eloy-cacca/Trabajo-final/trabajo final/tesis aon/tesis/hardware/tesis.PcbDoc.htm

Reporting Options

# File in Newer Format

Date | : | 30/9/2021
Time | : | 12:57:49
Filename | : | C:\Users\eloy_\Desktop\trabajo final\tesis aon\tesis\hardware\tesis.PcbDoc

Version | Warning
Release 20.0 | CAUTION - Support of propagation delay for primitives

This file was generated by a later version of the software
