eloy-cacca/Trabajo-final/trabajo final/filtro antialiasing/Analisis filtro.docx

Como se pretende adquirir señales de tensión y corriente provenientes de la línea, a estas se las debe filtrar y adecuar en tensión para su ingreso en el ADC del micro ARM. Para ello se eligió un filtro Butterworth de 3er orden.


Circuito para censado de corriente

En el circuito se optó por utilizar el amplificador operacional TLV 2474 dado que presenta una característica de amplitud lineal(dB) y no agrega fase en el intervalo de interés, esta última característica surge de que necesitamos conocer la diferencia de fase entre tensión y corriente para evaluar cuál es el comportamiento de la línea( resistivo, inductivo, capacitivo, etc.).


Circuito de salida


Bode circuito de salida

Se plantea el análisis por etapas, llegando a las ecuaciones:

H^(-) =(R_4)/(R_4 +R_5)=10.000/(10.000+10.000)=0.5

H^(+) = ((R_1 *R_2)/(R_1 +R_2)*C_1 *S)/(1+(R_1 *R_2)/(R_1 +R_2)*C_1 *S)*1/(1+R_3 *C_2 *S)=(S/21482)/(1+S/21482)*1/(1+S/21276)

G^(+) =(R_2)/(R_2 +R_1)*1/(1+(R_2 *R_1 *C_1 *S)/(R_2 +R_1))*1/(1+R_3 *C_2 *S)=0.5*1/(1+S/21482)*1/(1+S/21276)

Consideraciones de diseño:

C_1 =C_2 ; R_2 =R_1 ; R_4 =R_5 ; R_3 ~(R_4)/2


Del lado izquierdo tenemos a H^(-) y del lado derecho la red H^(+)


Circuito G+


Se trazó el diagrama de bode y se analizo la amplitud de cada una para analizar su aporte, llegando a que solo debemos considerar a H^(-) para nuestra región de incumbencia.


En verde traza de H^(+) y en celeste H^(-)

A su vez como trabajamos en la zona de G*H >> 1 entonces la ganancia se la puede considerar como A_(v1) =(G+)/(H-)=((R_2)/(R_2 +R_1)*1/(1+(R_2 *R_1 *C_1 *S)/(R_2 +R_1))*1/(1+R_3 *C_2 *S))/((R_4)/(R_4 +R_5))=(0.5*1/(1+S/21482)*1/(1+S/21276))/0.5 de donde sale que en baja frecuencia(S=0) gana 1.


Vamos a analizar la parte superior del sistema, la cual es igual a la de abajo, llegando a las ecuaciones:

H^(-) =((1+R_8 *C_6 *S)*(1+R_7 *C_3 *S))/(1+(R_8 *C_6 +R_7 *C_3 +R_7 *C_6 )*S+R_8 *C_6 *R_7 *C_3 *S^2)=((1+S/31.64)*(1+S/21276))/((1+S/12.7)*(1+S/52941))

G^(-) =(R_7 *C_6 *S)/(1+(R_8 *C_6 +R_7 *C_3 +R_7 *C_6 )*S+R_8 *C_6 *R_7 *C_3 *S^2)=(S/212.766)/((1+S/12.7)*(1+S/52941))

Como : C_6 =C_5 ; C_3 =C_7 ; R_8 =R_6 ; R_9 =R_7 entonces:

G^(+) _1 =G^(-) =(R_7 *C_6 *S)/(1+(R_8 *C_6 +R_7 *C_3 +R_7 *C_6 )*S+R_8 *C_6 *R_7 *C_3 *S^2)

G^(+) _2 =H^(-) =((1+R_8 *C_6 *S)*(1+R_7 *C_3 *S))/(1+(R_8 *C_6 +R_7 *C_3 +R_7 *C_6 )*S+R_8 *C_6 *R_7 *C_3 *S^2)

G^(+) _2 corresponde con la entrada de continua, de donde A_v =(G^(+) _2)/(H^(-))=1

A_(v2) =(G^(+) _1)/(H^(-))=(R_7 *C_6 *S)/((1+R_8 *C_6 *S)*(1+R_7 *C_3 *S))=(S/212.766)/((1+S/31.64)*(1+S/21276))


A_(vTotal) =A_(v2) *A_(v1) =(S/212.766)/((1+S/31.64)*(1+S/21276))*0.5*1/(1+S/21482)*1/(1+S/21276)*1/0.5

Se puede ver la caída de 3 dB a la frecuencia.

Es posible eliminar el capacitor C5 y C6 del circuito, el cambio general se observa que no filtra la continua. Calculando nuevamente las transferencias se llega a:

Análisis circuito tensión


Se puede ver la caída de 3dB a la frecuencia de 3400Hz


No se analiza el bloque de salida dado que es igual al de corriente, ahora bien con este circuito se llega a las ecuaciones:

H^(-) =(R_T)/(R_T +R_7)*(1+R_7 *C_3 *S)/(1+(R_T *R_7)/(R_T +R_7)*C_3 *S)

G^(-) =(R_7)/(R_7 +R_T)*1/(1+(R_T *R_7)/(R_T +R_7)*C_3 *S)

G^(+) _1 =G^(-) =(R_7)/(R_7 +R_T)*1/(1+(R_T *R_7)/(R_T +R_7)*C_3 *S)

G^(+) _2 =H^(-) =(R_T)/(R_T +R_7)*(1+R_7 *C_3 *S)/(1+(R_T *R_7)/(R_T +R_7)*C_3 *S)

G^(+) _2 corresponde con la entrada de continua, de donde A_v =(G^(+) _2)/(H^(-))=1

A_v =(G^(+) _1)/(H^(-))=((R_7)/(R_7 +R_T)*1/(1+(R_T *R_7)/(R_T +R_7)*C_3 *S))/((R_T)/(R_T +R_7)*(1+R_7 *C_3 *S)/(1+(R_T *R_7)/(R_T +R_7)*C_3 *S))=(R_7)/(R_T)

Donde R_T =R_10 +R_6

R_10 =R_11 ; R_6 =R_8 ; R_7 =R_9 ; C_3 =C_7
