eloy-cacca/Trabajo-final/firmware/proyecto_final/Nuevo DOCX Document.docx

Configuracion usb

/**

* USB Device Configuration

* @{

*/

//! Device definition

#define USB_DEVICE_VENDOR_ID USB_VID_ATMEL

#define USB_DEVICE_PRODUCT_ID USB_PID_ATMEL_ASF_CDC

#define USB_DEVICE_MAJOR_VERSION 1

#define USB_DEVICE_MINOR_VERSION 0

#define USB_DEVICE_POWER 100

#define USB_DEVICE_MANUFACTURE_NAME "ATMEL ASF"

#define USB_DEVICE_PRODUCT_NAME "CDC"

#define USB_DEVICE_ATTR \

(USB_CONFIG_ATTR_SELF_POWERED)

/**

* USB Device Callbacks definitions

* @{

*/

#define UDC_VBUS_EVENT(b_vbus_high)

#define UDC_SOF_EVENT()

#define UDC_SUSPEND_EVENT()

#define UDC_RESUME_EVENT()

//@}

//@}

/**

* USB Interface Configuration

* @{

*/

/**

* Configuration of CDC interface

* @{

*/

//! Interface callback definition

#define UDI_CDC_ENABLE_EXT(port) stdio_usb_enable()

#define UDI_CDC_DISABLE_EXT(port) stdio_usb_disable()

#define UDI_CDC_RX_NOTIFY(port)

#define UDI_CDC_TX_EMPTY_NOTIFY(port)

#define UDI_CDC_SET_CODING_EXT(port,cfg)

#define UDI_CDC_SET_DTR_EXT(port,set)

#define UDI_CDC_SET_RTS_EXT(port,set)

//! Default configuration of communication port

#define UDI_CDC_DEFAULT_RATE 115200

#define UDI_CDC_DEFAULT_STOPBITS CDC_STOP_BITS_1

#define UDI_CDC_DEFAULT_PARITY CDC_PAR_NONE

#define UDI_CDC_DEFAULT_DATABITS 8

//@}

//@}

Definicion de board_init()

void board_init(void)

{

/* Disable the watchdog */

WDT->WDT_MR = WDT_MR_WDDIS;

/* GPIO has been deprecated, the old code just keeps it for compatibility.

* In new designs IOPORT is used instead.

* Here IOPORT must be initialized for others to use before setting up IO.

*/

ioport_init();

/* Configure LED pins */

gpio_configure_pin(LED0_GPIO, LED0_FLAGS);

gpio_configure_pin(LED1_GPIO, LED1_FLAGS);

/* Configure Push Button pins */

gpio_configure_pin(GPIO_PUSH_BUTTON_1, GPIO_PUSH_BUTTON_1_FLAGS);

}

**

* \brief main function

*/

int main (void)

{

sysclk_init(); // inicializo reloj

board_init(); // inicializo la board
