eloy-cacca/Trabajo-final/trabajo final/archivos entregar/logo/Diagrama en bloques final 3_9.pptx

Fuentes de Alimentación

Adecuación de sensado de Corriente

Microcontrolador ARM

USB

Filtro Antialiasing

Conversor ADC
Y
PLL Digital

Firmware de procesado

Modulo wifi

Adecuación de sensado de tensión

Filtro Antialiasing

Modulo SD
