eloy-cacca/Trabajo-final/trabajo final/tesis aon/tesis/docs/et-junta/sections/.output/analog-y-dig.pdf

Calibrador y caracterizador de sondas de corriente | Especificación técnica

### 0.1. Generación de corriente

Requisito relacionado | Descripción
RF01 | Generación y adquisición de corriente

La etapa de generación de corriente se implementará utilizando una configuración puente H, utilizando MOSFETs controlados por sus respectivos drivers. En las Figuras 1a y 1b se pueden observar los dispositivos y sus respectivos esquemáticos que se utilizarán. Se deberá incluír un circuito de alimentación, mostrado en la Figura 1c, un circuito de protección, mostrado en la Figura 1d y una resistencia de medición tipo shunt, junto con un conector para la salida al multiplicador, mostrados en la Figura 1e.

Se utilizarán cuatro MOSFETs junto con dos drivers, con la misma configuración mostrada.

### 0.2. Adecuación y filtrado

Requisito relacionado | Descripción
RF01 | Generación y adquisición de corriente

### 0.3. ADC

Requisito relacionado | Descripción
RF01 | Generación y adquisición de corriente

### 0.4. Microcontrolador

Requisito relacionado | Descripción
RF01 | Generación y adquisición de corriente
RF02 | Sistema de control gráfico y gestión de ensayos

### 0.5. Fuentes de alimentación

Fecha: 05/08/2021 | Versión 1.0 | Página 1 de 2

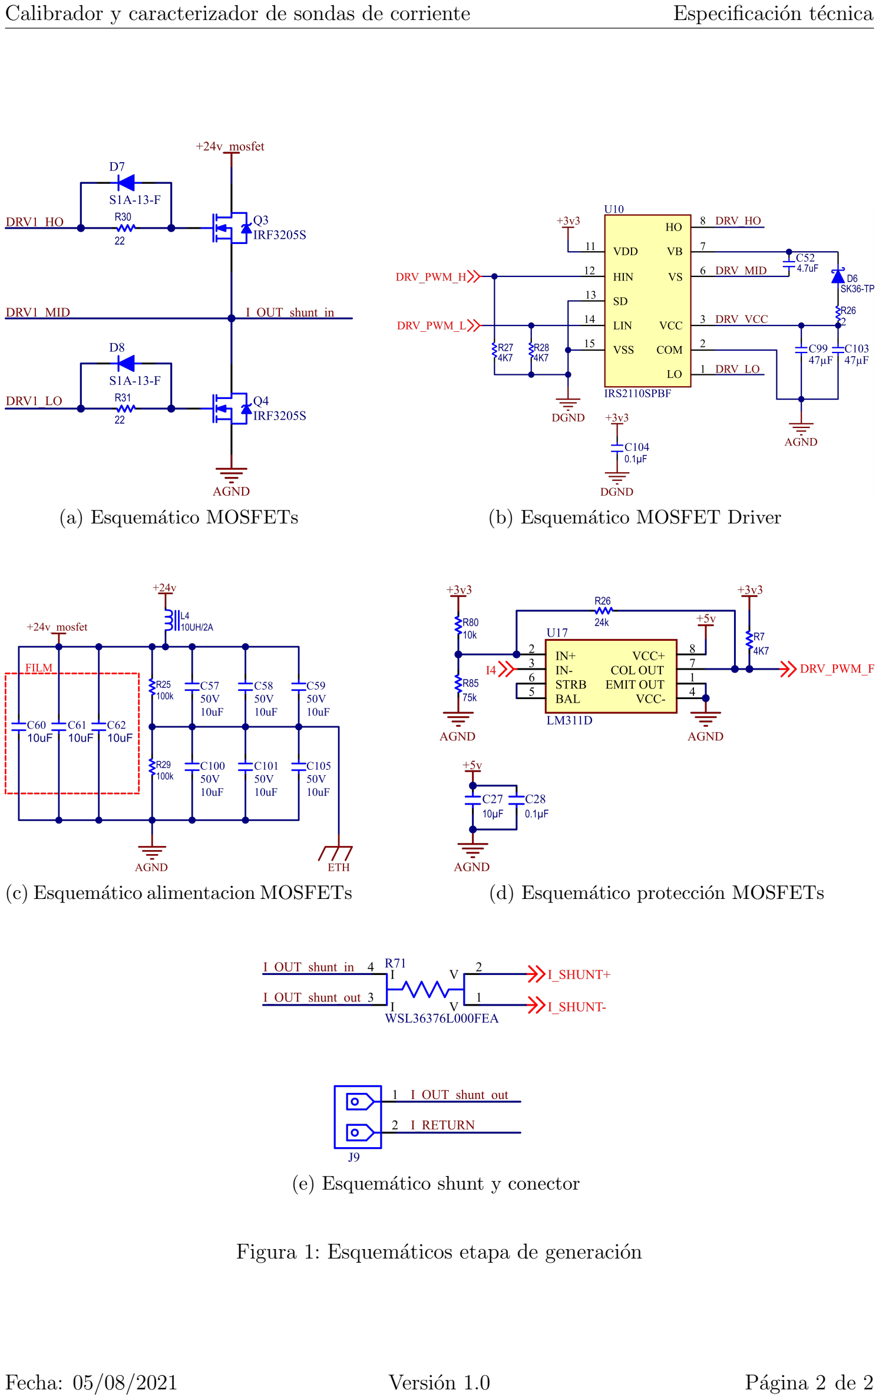
[picture p71: page 2]

Calibrador y caracterizador de sondas de corriente | Especificación técnica
(a) Esquemático MOSFETs | (b) Esquemático MOSFET Driver
(c) Esquemático alimentacion MOSFETs | (d) Esquemático protección MOSFETs
(e) Esquemático shunt y conector

Figura 1: Esquemáticos etapa de generación

Fecha: 05/08/2021 | Versión 1.0 | Página 2 de 2
