eloy-cacca/Trabajo-final/trabajo final/tesis aon/tesis/docs/et-junta/sections/analog-y-dig/.output/adc.pdf

Calibrador y caracterizador de sondas de corriente | Especificación técnica

Para la implementación del lazo de control de corriente en el multiplicador y la adquisición de la señal entregada por la sonda de corriente a caracterizar, se utilizará un conversor analógico digital.

Se utilizará el integrado ADS1174IPAPT. El esquemático para la conexión del mismo, por su complejidad, fue dividido en secciones.

### 0.0.1. Alimentación

Este dispositivo, necesita tres fuentes de alimentación separadas: 5 V, 3.3 V y 1.8 V. Debido a indicaciones del fabricante, se agregó un capacitor de desacople de 10 µF entre cada entrada y masa, como se puede ver en la Figura 1

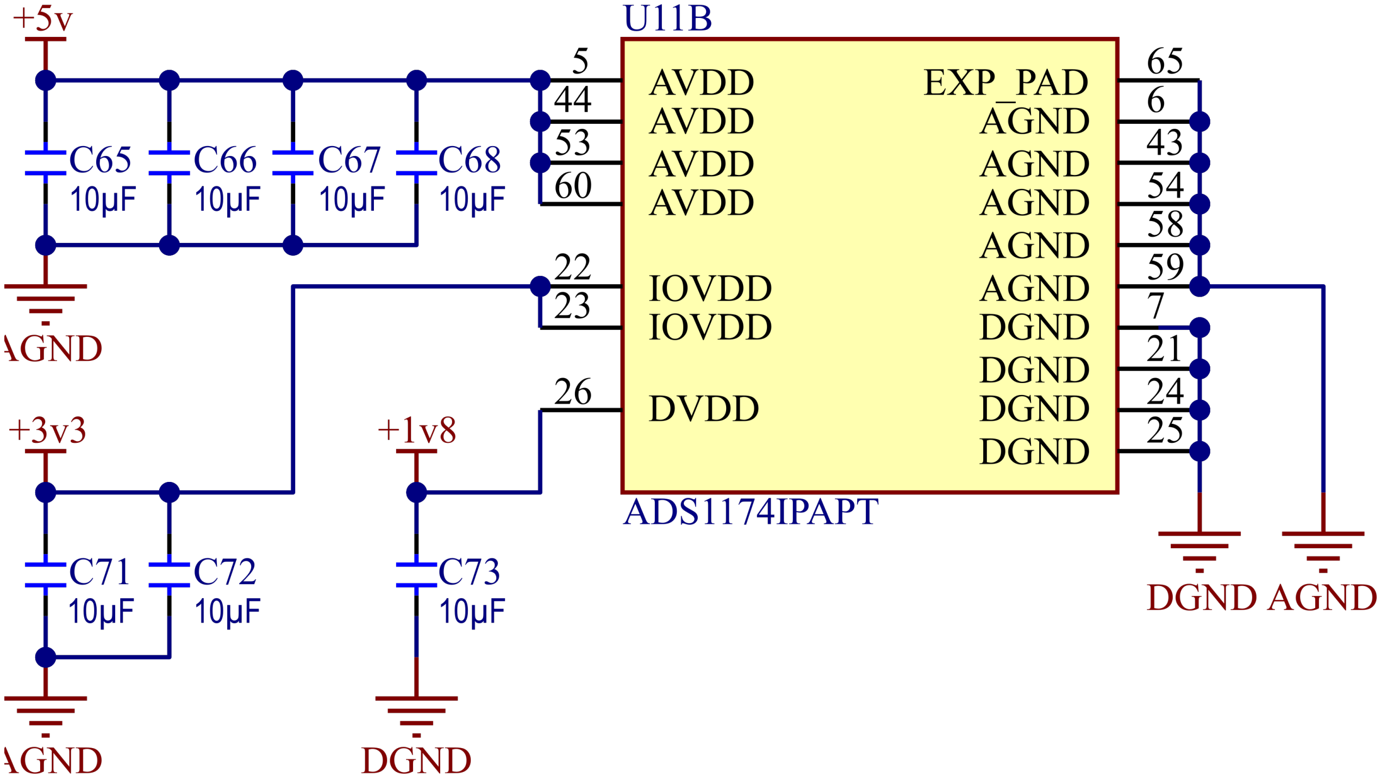
[picture p89: figure]

Figura 1: Alimentación del ADC

### 0.0.2. Entradas analógicas

En el caso de las entradas analógicas, se colocó un capacitor cerámico de 2.2 nF entre cada entrada diferencial, por indicación del fabricante para mejorar la performance del sistema. Además, se colocaron las cuatro entradas superiores (AINP4-AINP8) a masa, ya que éstas sólo están habilitadas en la versión de 8 canales del integrado. En esta etapa se incluyó también la tensión de referencia, la cual dictará el fondo de escala del dispositivo. El esquemático resultante se puede ver en la Figura 2.

### 0.0.3. Entradas y salidas digitales

Siguiendo las indicaciones del fabricante, se conectó el pin DOUT1 a la entrada SPI MISO (Master Input Slave Output) del microcontrolador, terminando la conexión con una resistencia de 100 Ω para adaptación de impedancias. Se conectó también SPCK al clock del SPI del microcontrolador y CLK al clock generado por el PWM del microcontrolador. El pin de DRDY (data ready) se ha conectado a una entrada GPIO del microcontrolador.

El funcionamiento de la interfaz SPI es el siguiente. Una vez que el ADC tiene los datos listos, genera una interrupción en el microcontrolador a través del pin de DRDY. El microcontrolador así comienza a generar el clock del SPI y el ADC envía los datos. En la Figura 3 se puede observar una descripción gráfica del funcionamiento descripto.

Fecha: 05/08/2021 | Versión 1.0 | Página 1 de 5

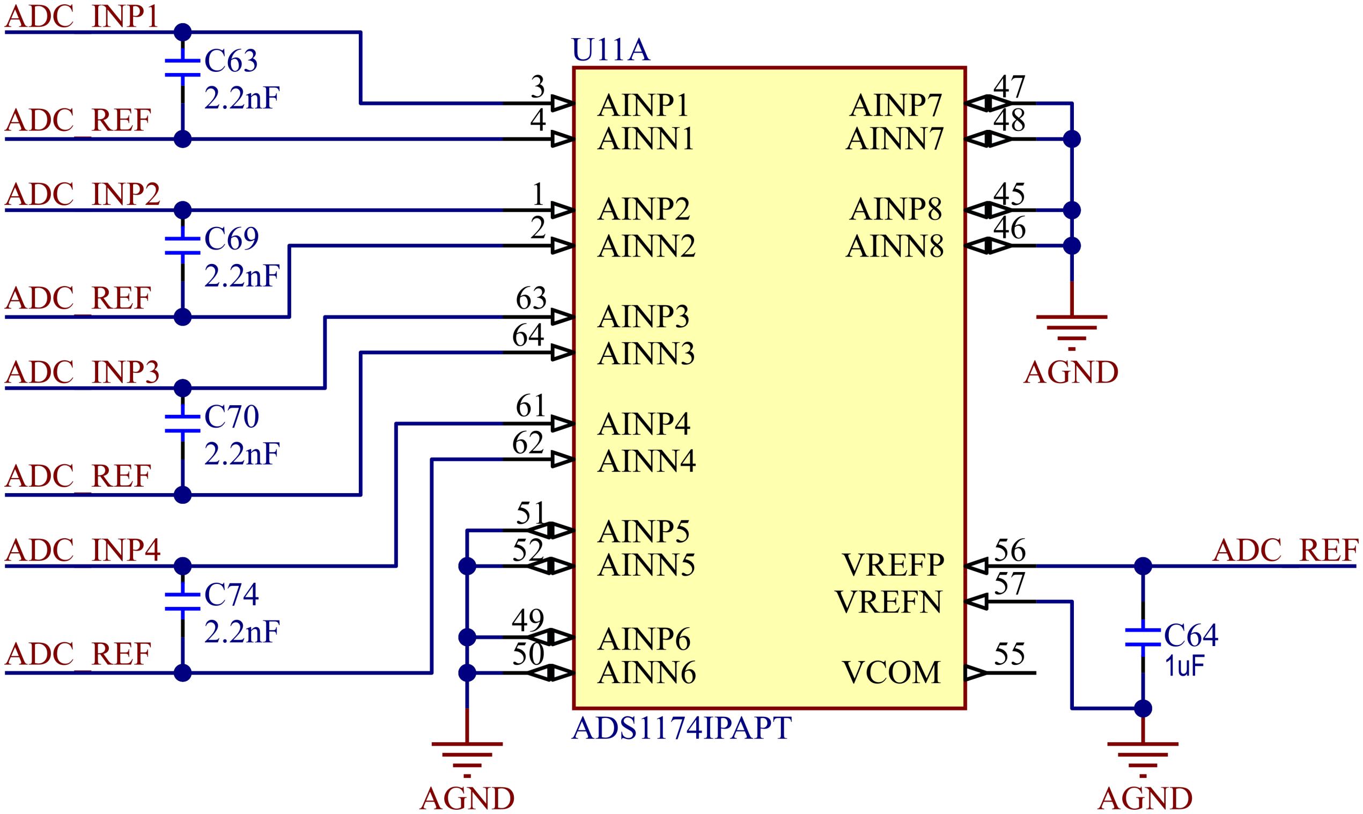
[picture p90: figure]

Figura 2: Entradas analógicas del ADC

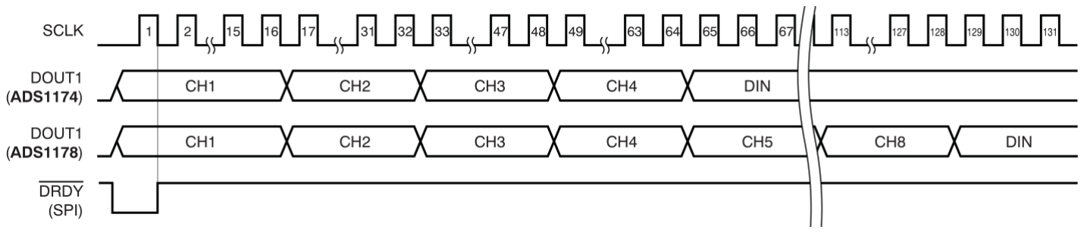
[picture p91: figure]

Figura 3: Diagrama de tiempo de envío de datos del ADC en modo TDM

### 0.0.4. Modos de salida de datos

Tanto para la conexión mediante el protocolo SPI o Frame-Sync, el ADC ofrece tres modos distintos para envío de datos:

TDM Dynamic: solo se enviarán las muestras de los canales habilitados en serie a través del pin DOUT1.

TDM Fixed: las muestras de todos los canales son enviadas en serie a través del pin DOUT1. En caso de que alguno no esté habilitado, se dejará lugar para el tiempo que hubiese ocupado.

Discrete: las muestras son enviadas en paralelo en cada una de los pones de salida dispo-nibles para tal fin (DOUT1-4).

Previendo futuras modificaciones en el modo de envío de información, se decidió dejar un header que permita modificar esta configuración mediante el agregado de jumpers, como se puede ver en la Figura 4

### 0.0.5. Modos de testeo

Este modo permite medir la continudad de los pines de entrada y salida según se ve en la Tabla 1. Una vez activado, las funciones normales de los pines digitales son deshabilitadas. Nuevamente se dejó un header con pines expuestos en caso de que se necesite utilizar esta función, como se puede ver en la Figura 5.

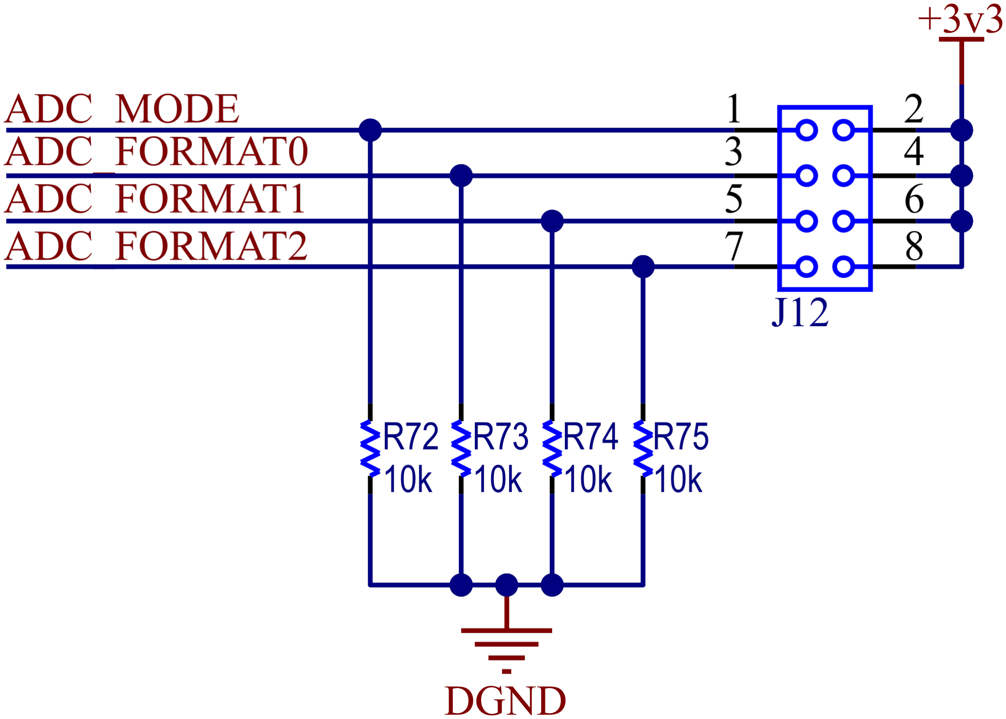
[picture p92: figure]

Figura 4: Selector de modo de salida de datos del ADC

Entrada | Salida
PWDN1 | DOUT1
PWDN2 | DOUT2
PWDN3 | DOUT3
PWDN4 | DOUT4
MODE | DIN
FORMAT0 | CLKDIV
FORMAT1 | DRDY/FSYNC
FORMAT2 | SCLK

Cuadro 1: Conexión interna de pines en modo de testeo del ADC

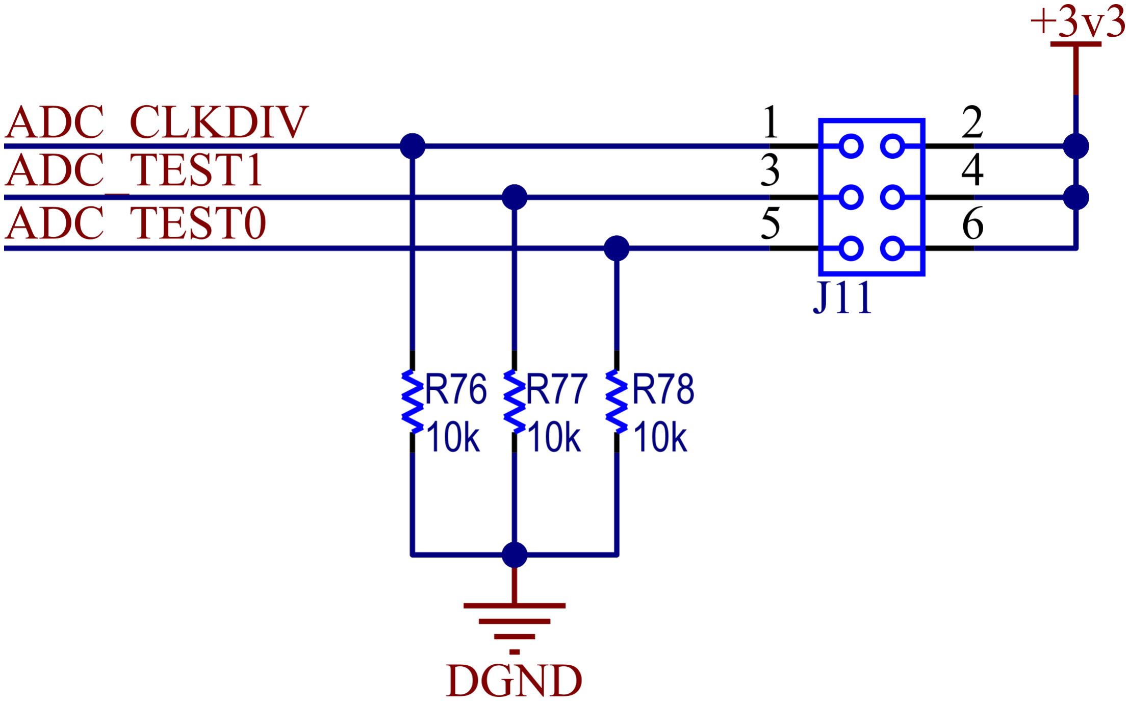
[picture p93: figure]

Figura 5: Selector de modo de testeo del ADC

### 0.0.6. Selección de ADC

Se contempló el uso del conversor analógico interno del microcontrolador, por lo que se adicionó un header de selección. El esquemático se puede ver en la Figura 6.

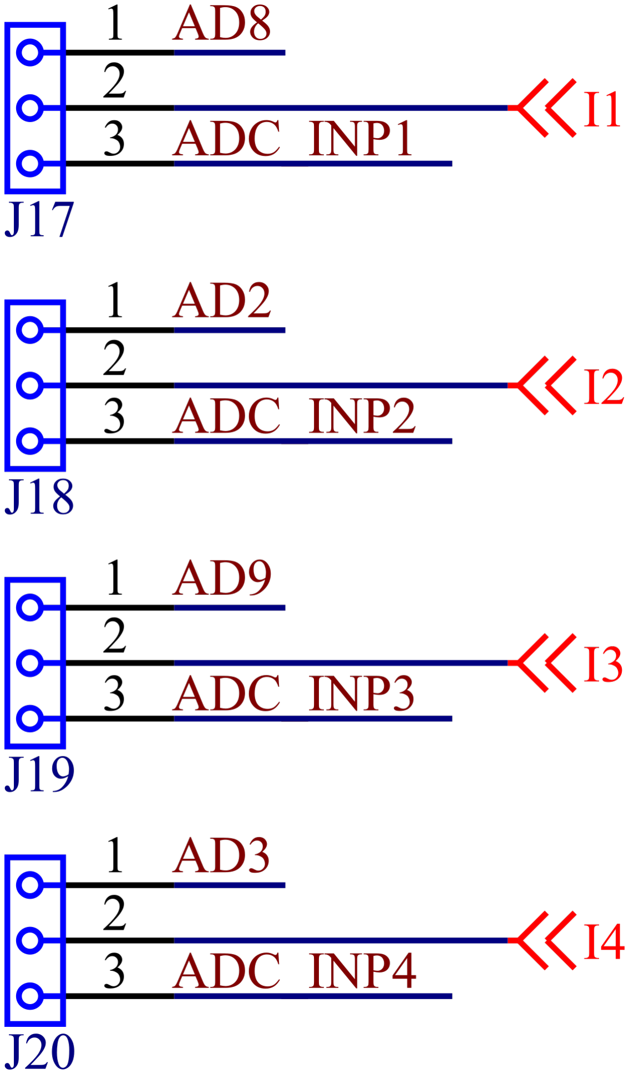
[picture p94: figure]

Figura 6: Selector de ADC

### 0.0.7. Características integrado

El integrado que se utilizará es el ADS1174IPAPT de Analog Devices. Este cuenta con las siguientes características:

4 canales simultáneos.

Dos modos de selección posibles: 52 kSPS o 10 kSPS.

DC Performance:

2 µV/°C deriva de offset

2 ppm/°C deriva de ganancia

AC Performance:

25 kHz de ancho de banda

97 dB de SNR

−105 dB de THD

Interfaz SPI.

Muestreador tipo delta-sigma.

Filtro interno de ±0.005 dB de ripple y respuesta de fase lineal.

En la Figura 7 se puede observar el diagrama en bloques interno del integrado, provisto por el fabricante.


Figura 7: Diagrama en bloques interno del ADS1174IPAPT
