eloy-cacca/Trabajo-final/trabajo final/tesis aon/tesis/docs/et-junta/sections/analog-y-dig/.output/adecuacion.pdf

Calibrador y caracterizador de sondas de corriente | Especificación técnica

El instrumento deberá contar con tres puertos a los cuales se puedan conectar sondas externas (sondas de Rogowski, pinzas amperométricas, etc.), para su calibración y caracterización. Uno de estos puertos será dedicado para la sonda Rogowski y los otros dos genérico para otras sondas.

El dispositivo contará con dos esquemáticos distintos para sus puertos de conexión. En la Figura 1a se puede observar el correspondiente para la sonda Rogowski y en la Figura 1b el correspondiente para otras sondas.

Se incluirá además circuitos de adecuación y filtrado para cada etapa, descriptos en el esquemático de la Figura 1c.

(a) Esquemático puerto
sonda Rogowski


(b) Esquemático puertos para otras sondas


(c) Esquemático circuito de adecuación y filtrado

Figura 1: Esquemáticos etapa de adquisición

### 0.0.1. Funcionamiento

Este circuito proveerá la ganancia y filtrado anti-aliasing para los cuatro canales del conversor analógico digital. Los mismos, están divididos en dos tipos diferentes:

Un canal para medir la corriente en el multiplicador. Se mide la caída de tensión de la resistencia shunt colocada en serie con la corriente que circula por la carga. Esta medición es realizada de manera de, a partir de un lazo de control, regular la corriente.

Tres canales para la conexión de las sondas de corriente a caracterizar.

Si bien existen estos dos tipos de entradas, el circuito de adecuación y filtrado es el mismo para todas, pudiendo variar entre ellos la ganancia aplicada.

En la Figura 2 se puede observar el circuito genérico utilizado para la adecuación y filtrado.

Fecha: 05/08/2021 | Versión 1.0 | Página 1 de 4

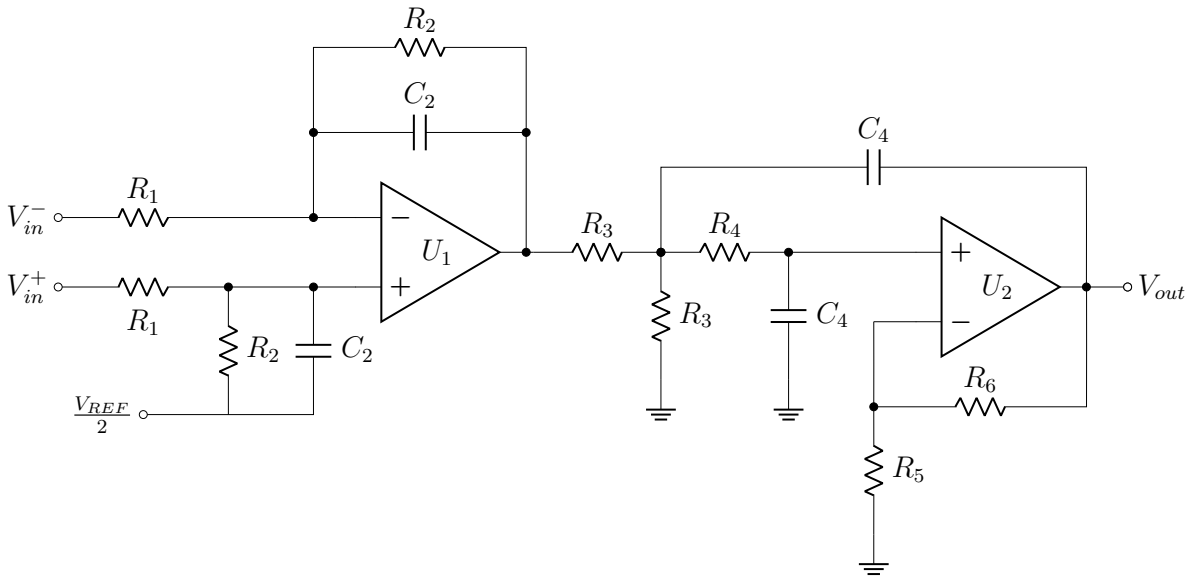
[picture p95: figure]
VREF 2; Vout

Figura 2: Circuito de adecuación y filtrado

Primera etapa En esta etapa que culmina en la salida del primer amplificador operacional U1, se incluye una configuración diferencial junto con un filtro pasabajos de primer orden. La transferencia de esta etapa es la siguiente:

V1(s)
V

+
in (s) − V

−
in (s)

=

R2
R1

·

1
1 + sC2R2

De manera de tener una frecuencia de corte de aproximadamente 3400 Hz, se eligieron los siguientes valores:

R2 = 4.7 kΩ

C2 = 10 nF

Se obtuvo de esta forma una frecuencia de corte fc = 3386 Hz. La resistencia R1 se elegirá de acuerdo a las necesidades de ganancia de cada entrada.

Los amplificadores operacionales son alimentados en forma unipolar, por lo que se emplea una tensión de offset de VREF
2

Segunda etapa Filtro pasabajos de segundo orden tipo Sallen-Key.

Si se observa la Figura 3, se verá una de las configuraciones más comunes encontradas en la literatura [ti:sloa024b].

La transferencia de un circuito Sallen-Key en la configuración de la Figura 3 es la siguiente:

Vo(s)
Vi(s)

=

K
s

2
(R3R4C3C4) + s(R3C3 + R4C3 + R3C4(1 − K)) + 1

siendo:
fc =

1
2π

√
R3R4C3C4

y Q =

√
R3R4C3C4
R3C3 + R4C3 + R3C4(1 − K)

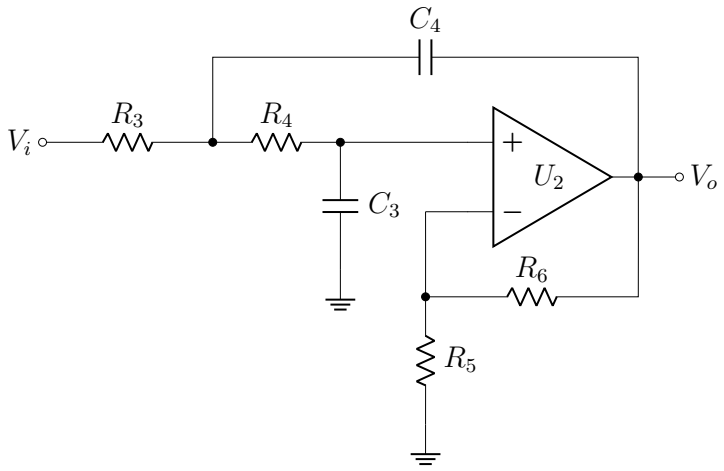
[picture p96: figure]

Figura 3: Configuración Sallen-Key pasabajos estándar

Para acelerar el diseño, se pueden encontrar en la literatura diversas simplificaciones [ti:sloa024b]. En este caso, se ha decidido optar por igualar componentes. Así, R3 = R4 = R y C3 = C4 = C, resultando en:
fc =

1
2πRC | y | Q =

1
3 − K

Así, se eligió utilizar un factor Q = 1 que, utilizando resistencias con margen de error de 1 %, resultaría para un peor caso un factor Q = 1.02.

Habiendo realizado esta elección, y siendo este el único grado de libertad del circuito, se obtiene K = 2. Es por ello que, tal como se mencionó antes, se realiza la modificación en la resistencia R3. Al atenuar la señal a la mitad con el divisor resistivo antes de introducirla a la segunda etapa, se cancela el efecto de ganancia de esta última, quedando así, a fines prácticos, una ganancia unitaria. La única condición necesaria es ahora:

R3
2
| = R4

de manera de cumplir la simplificación planteada.

Atendiendo a todas estas consideraciones y cumpliendo la frecuencia de corte antes planteada, se eligieron los siguientes valores:

R3 = 9.31 kΩ

R4 = 4.7 kΩ

C3 = C4 = 10 nF

R5 = R6 = 10 kΩ

utilizando de esta manera los mismos componentes que en la etapa previa, llegando a la frecuencia de corte de 3386 Hz, logrando el filtro pasabajos de tercer orden deseado.

Protección ADC En el circuito final, se agregaron dos diodos schottky a la salida, uno conectado a 3.3 V y el otro a masa para la protección de las entradas del conversor analógico digital, limitando la tensión máxima a 3.3 V +VF , siendo VFmax = 1 V para el integrado elegido.

### 0.0.2. Puertos de conexión

Para los puertos de conexión, se incluirá en ambos casos salidas de ±5 V, junto con una salida de masa, para conectar las sondas que las requieran. Se agregará también una salida con la tensión de referencia utilizada en la etapa de adecuación.

En el caso del puerto genérico se agregará una serie de resistencias que permita generar una tensión medible a partir de la corriente de entrada. Las mismas no serán montadas en la construcción y se dejará al usuario decidir los valores de acuerdo a la necesidad de la sonda que desee conectar.

Los puertos físicos podrán ser elegidos por el desarrollador.
