eloy-cacca/Trabajo-final/trabajo final/tesis aon/tesis/docs/et-junta/sections/analog-y-dig/.output/gen-corriente.pdf

Calibrador y caracterizador de sondas de corriente | Especificación técnica

La etapa de generación de corriente se implementará utilizando una configuración puente H, utilizando MOSFETs controlados por sus respectivos drivers. En las Figuras 1a y 1b se pueden observar los dispositivos y sus respectivos esquemáticos que se utilizarán. Se deberá incluír un circuito de alimentación, mostrado en la Figura 1c, un circuito de protección, mostrado en la Figura 1d y una resistencia de medición tipo shunt, junto con un conector para la salida al multiplicador, mostrados en la Figura 1e.

Se utilizarán cuatro MOSFETs junto con dos drivers, con la misma configuración mostrada.

### 0.0.1. Funcionamiento

El circuito completo a utilizar, se puede ver en la Figura 2.

El microcontrolador controlará a partir de sus salidas PWM los drivers de los MOSFETs. Así, este dictará la apertura y cierre de los cuatro MOSFET que generarán una caída de tensión sobre el multiplicador de corriente, representado en el circuito como el inductor L, de aproximadamente 24 V positiva o negativa.

Se incluirá también una resistencia de shunt Rshunt cuya caída de tensión deberá ser medida para poder ser realimentada en el microcontrolador y así controlar la corriente generada.

Para poder proveer las corrientes de alta frecuencia necesarias y aliviar los requerimientos sobre la fuente de tensión externa, se agregará el circuito de alimentación de la Figura 3.

El capacitor C1 representará varios capacitores de film en paralelo, capaces de proveer gran cantidad de corriente en frecuencias de bajas a medias. Para la corriente agregada por el switching se agregarán capacitores cerámicos representados por C2 y C3. Estos proveerán las corrientes de alta frecuencia. En paralelo a estos se agregarán dos resistencias R1 y R2 que permitan mantener el punto medio de los capacitores cerámicos en la mitad de la tensión.

Además de estos componentes se agregó una bobina L1 que actúa de filtro pasaaltos, de manera tal que las corrientes de alta frecuencia sean obtenidas por los capacitores y no de la fuente de alimentación externa.

### 0.0.2. MOSFETs

Se utilizarán MOSFETs de montaje superficial, por su velocidad de conmutación, por su capacidad de disipar el calor con el mismo cobre del PCB, su baja resistencia de drain y baja resistencia térmica.

Se montará entonces el integrado IRF3205S, que cuenta con las siguientes características:

VDSS = 55 V

RDSon = 8 mω

ID = 110 A

RθJA = 40 °C/W

Como se puede observar en la Figura 1a, en serie entre el driver y el MOSFET, se encuentra una resistencia en paralelo con un diodo conectado en inverso. El objetivo de la resistencia es aumentar el tiempo que tarda el transistor en encenderse, como se puede ver en la Figura 4 obtenida del datasheet del integrado, dado que un encendido demasiado rápido puede producir tensiones negativas sobre el pin VS, lo cual puede llegar a romper el integrado. El diodo, por

Fecha: 05/08/2021 | Versión 1.0 | Página 1 de 8

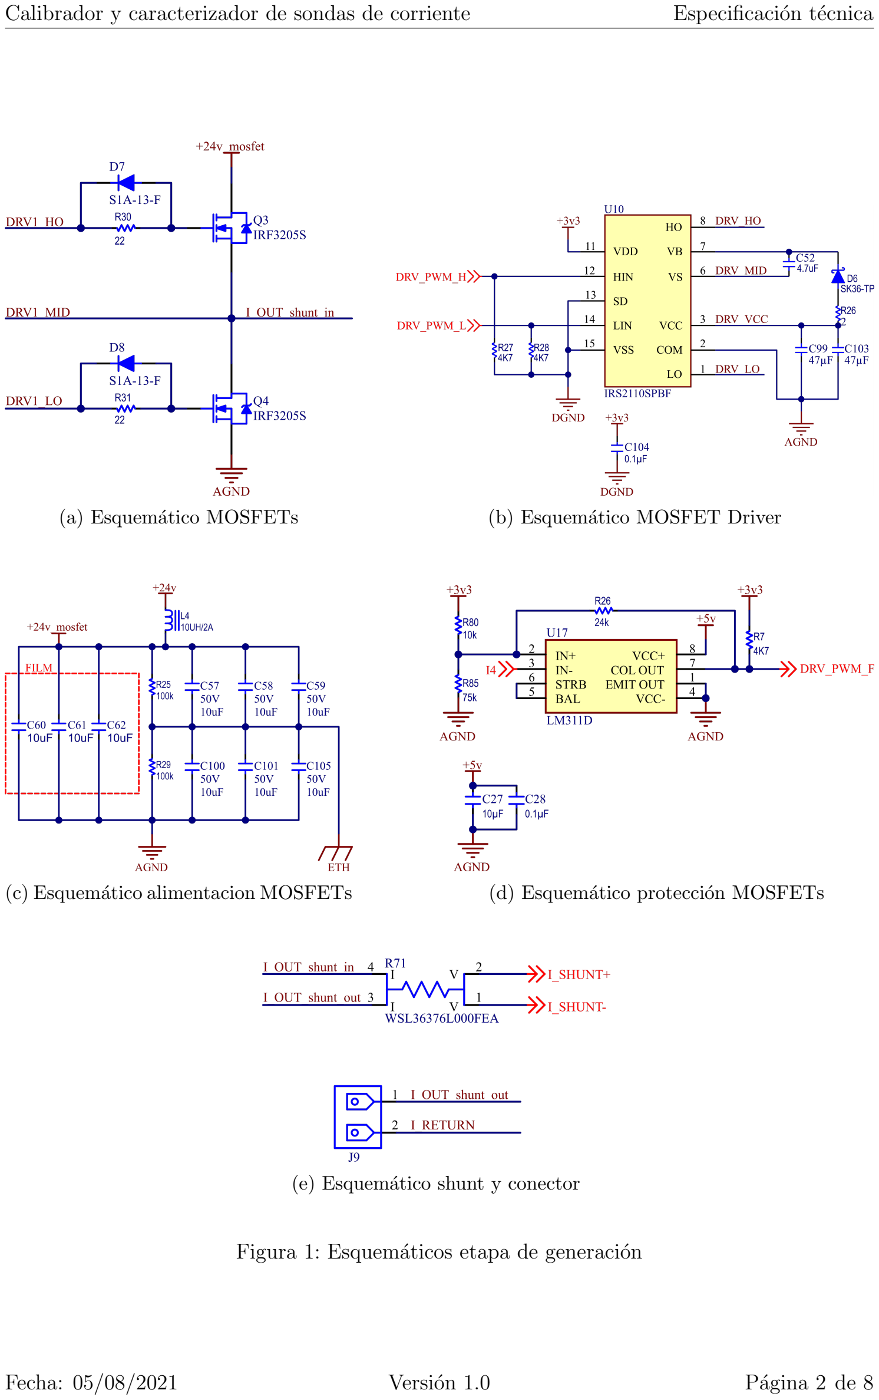
[picture p101: page 2]

(a) Esquemático MOSFETs | (b) Esquemático MOSFET Driver
(c) Esquemático alimentacion MOSFETs | (d) Esquemático protección MOSFETs
(e) Esquemático shunt y conector

Figura 1: Esquemáticos etapa de generación

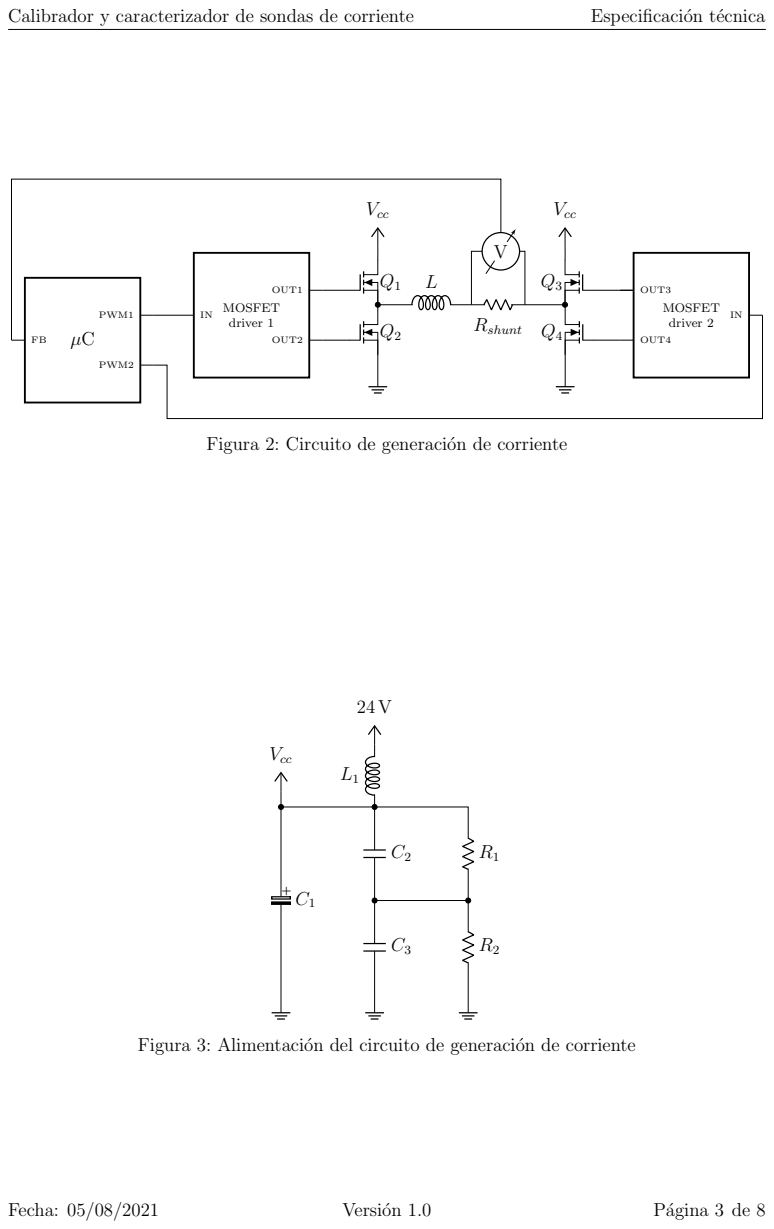
[picture p102: page 3]

Figura 2: Circuito de generación de corriente

Figura 3: Alimentación del circuito de generación de corriente

otra parte, acelera el apagado del MOSFET, previniendo las posibilidades de cortocircuito en la conmutación.


Figura 4: Pico de tensión en pin VS vs. resistencia y tiempo de encendido

### 0.0.3. MOSFET driver

El rol de estos componentes será controlar la apertura y cierre de los MOSFET. Para ello se buscó un dispositivo que cumpliera con los requerimientos de frecuencia de switching necesarios, tensión de disparo del gate, bajo costo y de utilización general.

El integrado que se montará será el IRS2110SPBF, de Infineon Technologies con las siguientes características:

Tensión de gate entre 10 V y 20 V.

Tiempo de encendido y apagado de 130 ns y 120 ns respectivamente.

Tensión de drive del MOSFET hasta 500 V

Compatible con lógica 3.3 V

Canal flotante diseñado para utilizar con bootstrap

La frecuencia de switching que se utilizará es 100 kHz, siendo el retardo del integrado despreciable comparado con esta. La tensión de gate del MOSFET será proveída por la fuente de 12 V. Además, el MOSFET driver será disparado con el PWM del microcontrolador, de lógica 3.3 V. Finalmente el canal flotante permitirá disparar el MOSFET del lado alto utilizando únicamente un diodo y un capacitor de bootstrap de componentes externos.

El diagrama de bloques interno del integrado se puede ver en la Figura 5.

Se describirá a continuación la selección realizada de componentes para el esquemático de este dispositivo.

Etapa lógica Las entradas HIN y LIN serán conectadas a los puertos PWM del microcontrolador, con dos resistencias pull-down de 4.7 kW, lo cual permitirá dejar el valor en bajo ante el apagado del microcontrolador. La fuente de tensión lógica VDD será conectada a 3.3 V, siendo esta la máxima tensión del microcontrolador, y VSS a masa.


Figura 5: Diagrama en bloques del integrado IRS2110SPBF

Etapa de potencia El pin de VCC se conectará a 12 V. Los capacitores de desacople para esta pin fueron elegidos de esos valores ya que el fabricante recomienda una capacidad al menos 10 veces más grande que el capacitor de bootstrap. Se han colocado dos por motivos de disposición del PCB.

En los pines 8 y 7 se puede ver la conexión de la fuente flotante VB y VS, el punto de retorno de la misma. El objetivo de este bloque es el de proveer una tensión mayor a 24 V para poder activar el gate del MOSFET de la parte alta. Así, durante el período en el que el MOSFET de la parte baja está activo, el capacitor C52 se carga a través del diodo D6 a la tensión de VCC, es decir aproximadamente 12 V. Luego cuando este MOSFET se apaga y se quiere activar el de la parte alta, VS ahora se encuentra a 24 V, quedando la fuente flotante VB con una tensión efectiva de 36 V debido al capacitor cargado, pudiendo así proveer la tensión necesaria al gate del MOSFET.

Capacitor de bootstrap Dado que el capacitor de bootstrap C52 sera utilizado como fuente para proveer de carga al gate del MOSFET, se debe dimensionar de manera tal que mantenga su tensión luego de haberla entregado. Siguiendo las notas de aplicación brindada por el fabricante [ir:an-978], [ir:dt04-04], se han diseñado entonces los componentes de bootstrap.

El primer paso es establecer la máxima disminución de tensión ∆VBS que se puede tener en el capacitor de bootstrap Cbs para garantizar que el MOSFET del lado alto se mantenga prendido. Esta caída estará dada por:

∆VBS ≤ VCC − VF − VGSmin − VDSon − VRbs | (1)

siendo VCC la tensión de la fuente de alimentación de 12 V, VF la caída sobre el diodo de bootstrap, VGSmin la mínima tensión de gate a mantener, VDSon la caída sobre el MOSFET del lado bajo cuando está encendido y VRbs la caída sobre la resistencia de bootstrap. En la Figura 6 se puede observar un esquemático de esta parte del circuito.

Para poder encontrar ∆VBS, se deben hallar primero los valores de las demás tensiones, como se puede ver en (1). A partir de valores del fabricante y datos propios se obtuvo:

VCC = 12 V

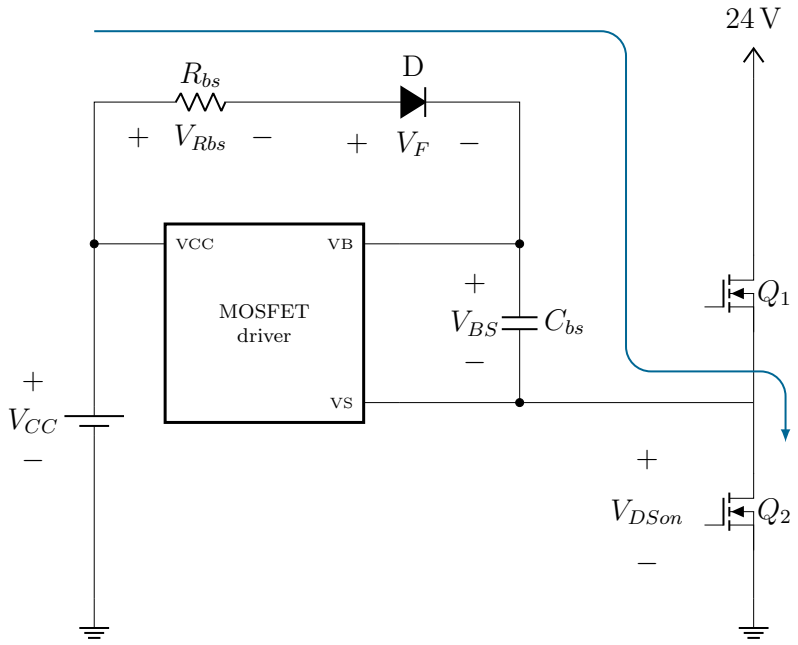
[picture p103: figure]
MOSFET driver; VCC; Rbs; + VRbs; Cbs; VBS; VDSon

Figura 6: Esquemático de la etapa de bootstrap del MOSFET driver

VF = 0.75 V

VGSmin = 4 V

VDSon = ID · RDSon = 10 A · 3.95 mΩ = 395 mV

De aquí solo resta hallar VRbs. El objetivo de esta resistencia es limitar la máxima corriente que circula por el diodo D al valor máximo que permite el fabricante. Para ello se calcula:

Rbsmin =

VCC

IDmax

=

12 V
100 A = 0.12 Ω

La cual si multiplicamos por 10 para tener un margen de seguridad y redondeamos hacia arriba al valor más cercano obtenemos Rbs = 2 Ω, obteniendo así una corriente máxima sobre el diodo IDmax = 6 A.

De manera de poder hallar entonces VRbs en valor promedio se realiza el siguiente cálculo:

VRbs = Qtot · Tof f · Rbs | (2)

el cual solo podrá ser resuelto una vez se obtenga la carga total que sale del capacitor de bootstrap.

El segundo paso es entonces, hallar todos los factores que contribuyen a que VBS disminuya, es decir todas las cargas y corrientes que circulan por el circuito:

Carga de Gate requerida para encender el transistor (QG)

Carga requerida por los level shifters internos del MOSFET (QLS), generamente 5 nC (500V/600V MOSFETs) o 20 nC (1200V MOSFETs)

Corriente de fuga Gate-Source del transistor (ILK−GS)

Corriente de reposo de la sección flotante (IQBS)

Corriente de fuga de la sección flotante (ILK)

Corriente de fuga del diodo de bootstrap (ILK−D)

Corriente de desaturación del diodo encendido (IDS−)

Corriente de fuga del capacitor de bootstrap (ILK−CAP )

Tiempo que dura encendido el lado alto (THon)

ILK−CAP es sólo relevante cuando se utiliza un capacitor electrolítico y puede ser ignorada si se usan de otro tipo. El fabricante recomienda utilizar al menos un capacitor cerámico con bajo ESR (puede ser en paralelo con un capacitor electrolítico).

ILK−D es sólo elevante para diodos comunes, siendo en nuestro caso uno tipo Schottky.

Entonces se tiene:

QT OT = QG + QLS + (ILK−GS + IQBS + ILK + ILK−D + IDS−) · THon | (3)

Para poder hallar esta carga total, se recurre a los datos de los fabricantes nuevamente, obteniendo:

QG = 146 nC

QLS = 5 nC

ILK−GS = 100 nA

IQBS = 230 µA

ILK = 50 µA

ILK−D = 10 mA

Se obtiene suponiendo el peor caso, cuando el MOSFET alto está el mayor tiempo prendido, es decir para THon =

0.9
100 kHz :

Cbsmin =

QT OT

∆VBS

= 36.22 nF | (4)

Dejando un margen de seguridad de al menos 100 veces y redondeando al siguiente valor superior, se obtuvo:

Cbs = 4.7 µF

### 0.0.4. Protección

Para protección de sobrecorriente se deberá agregar el circuito mostrado en la Figura 1d. Para su diseño se utilizó el comparador LM311D, en una configuración de comparador con histéresis

Con los valores de resistencias dados, se obtiene una histéresis de 10 A a 20 A.

### 0.0.5. Resistencia de shunt

Esta resistencia se colocará en serie al multiplicador de corriente, como se puede ver en la Figura 1e de manera que deberá soportar 10 A que circularán por esta. Se utilizará entonces la resistencia WSL36376L000FEA que tiene las siguientes características:

R = 6 mΩ ± 1 %

Pmax = 3W

Esta resistencia posee cuatro terminales, permitiendo así contar con puertos separados para la medición y la parte de potencia.

Se deberá también incluír un conector que soporte una salida de por lo menos 10 A, para la conexión con el multiplicador de corriente.
