eloy-cacca/Trabajo-final/vistas nuevo diseño 31-3-22.docx

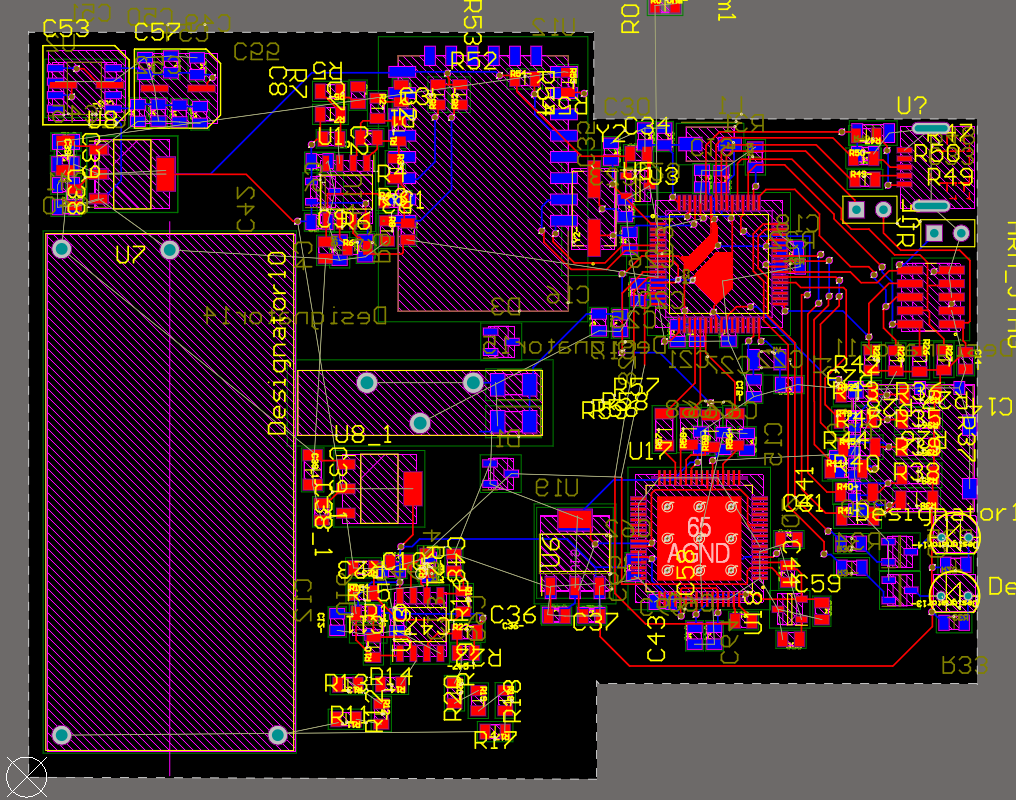
[picture p119: figure]
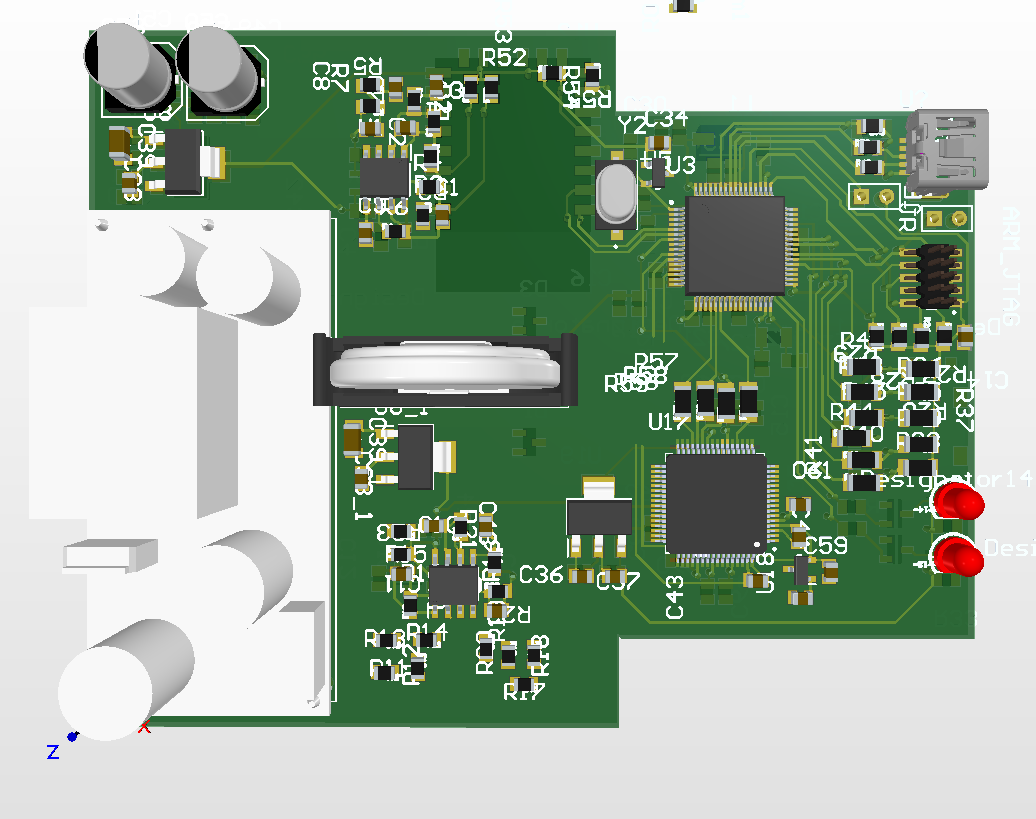
[picture p120: figure]
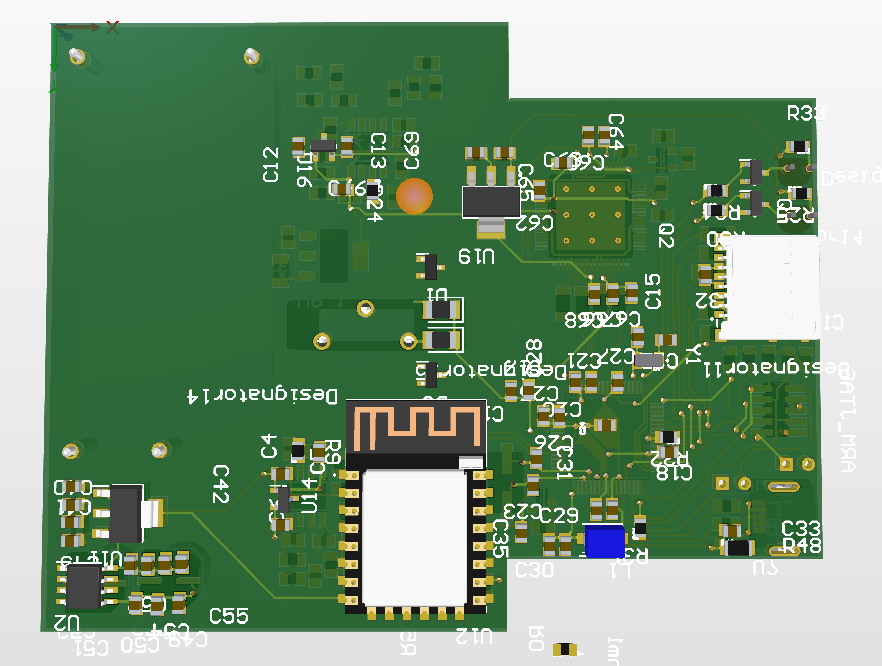
[picture p121: figure]
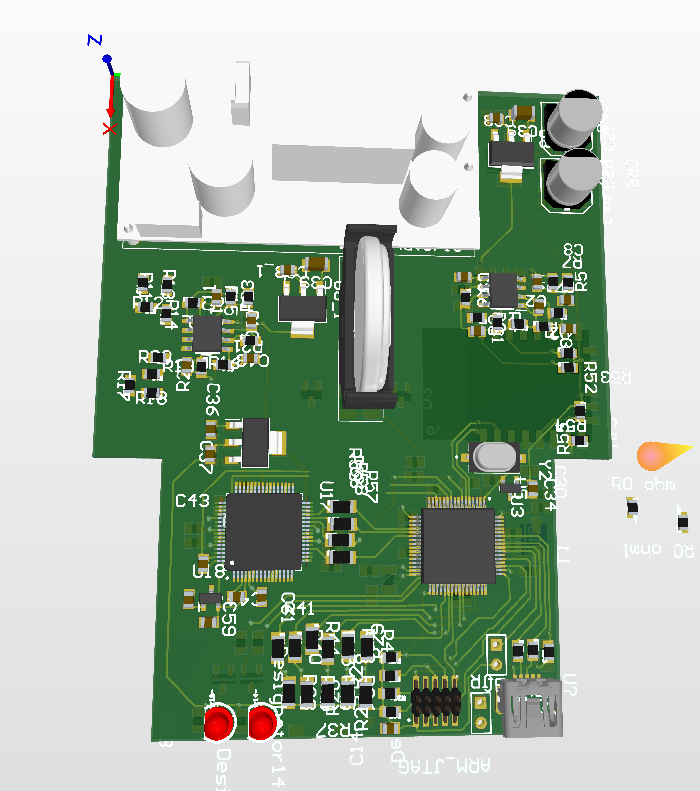
[picture p122: figure]
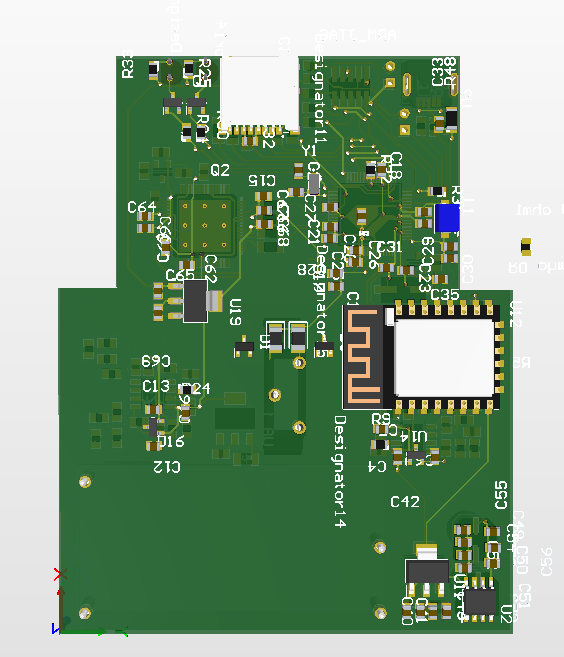
[picture p123: figure]
