eloy-cacca/Trabajo-final/curso altium/Trabajo Final/smd capacitores.docx

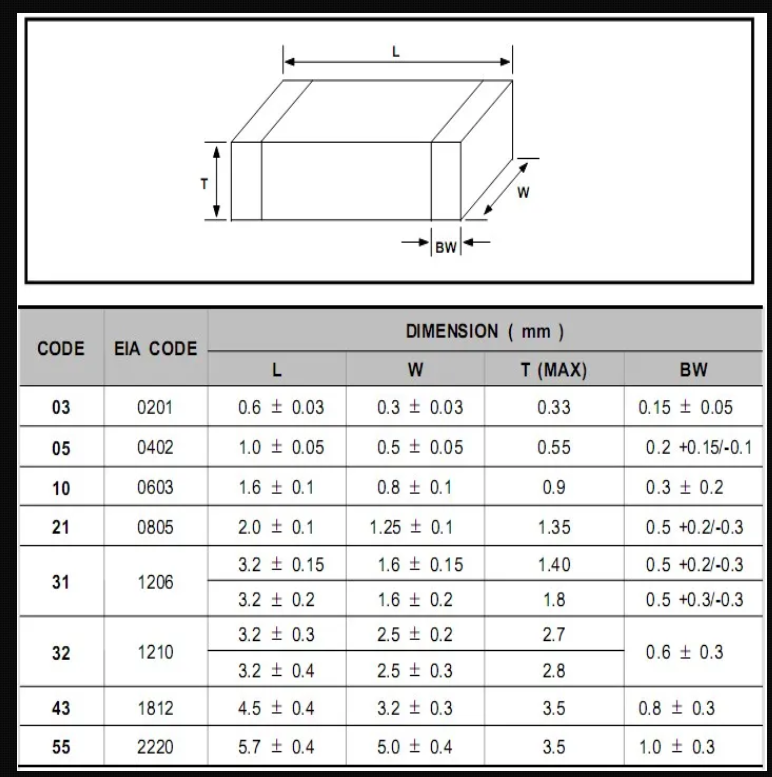
[picture p130: figure]
