eloy-cacca/Trabajo-final/trabajo final/tesis aon/tesis/docs/et-junta/sections/.output/firmware.pdf

Calibrador y caracterizador de sondas de corriente | Especificación técnica

El diseño de firmware consiste en la creación del proceso de decisión que se lleva a cabo en el microcontrolador. Este luego ha sido programado en lenguaje C, sin utilizar ningún sistema operativo en tiempo real (RTOS) y con la ayuda del Advanced Software Framework (ASF) de Atmel, que provee una capa de abstracción de hardware, facilitando así el uso de los periféricos.

Esta sección responde a los requerimientos RF01 y RF02.

### 0.1. Estructura general

El programa que correrá en el microcontrolador se dividirá en módulos llamados apps. Cada uno de ellos cuenta con un api que será el encargado de comunicarse con la interfaz de comunicaciones, así permitiendo tener una capa de abstracción entre ambos. Por último, esta interfaz de comunicaciones además de contar con su propio api para comunicarse con los módulos, provee también la estructura necesaria para poder comunicarse con la PC, ya sea vía UART o USB.

Esta estructura se puede ver en la Figura 1.


Figura 1: Estructura general de los módulos en el microcontrolador

Las distintas partes que componen el firmware son:

Módulo de comunicaciones

Módulo de control

Módulo de adquisición y procesamiento de señales

Módulo de generación de corriente

De estos se explicarán algunos que vale la pena resaltar.

### 0.2. Módulo de comunicaciones

Este módulo es el encargado de enviar y recibir comunicaciones entre el microcontrolador y la PC. La característica de diseño del mismo es que su función sea solamente receptiva: esto es,

Fecha: 05/08/2021 | Versión 1.0 | Página 1 de 6

el microcontrolador nunca iniciará una comunicación por si cuenta, sólo responderá. Se ahorra así la implementación de un esquema de acceso al medio.

Se diseñó entonces un sencillo protocolo de comunicaciones mostrado a continuación:

Inicio | Proyecto | Fuente | Destino | Longitud | Datos | ... | CRC

Cada bloque representa un byte, excepto el CRC (código de corrección de errores) que es de dos bytes. Tanto el byte de inicio, como el de proyecto, fuente y destino, son configurables. La longitud representa la cantidad de datos enviados y el CRC se genera y verifica solo.

Se permite realizar la comunicación de dos formas. La primera es utilizando la UART y conectando la PC a través de un convertidor. La segunda y más cómoda es utilizar el puerto USB. Una vez conectado, el mismo funcionará generando un puerto COM virtual, a través del cual se puede enviar y recibir información.

### 0.3. Módulo de control

Este módulo es la implementación del mecanismo de control a partir del cual se genera una corriente precisa. Esto se logra realimentándola y comparando la medición con un valor de referencia, obteniendo así un error que se desea minimizar.

### 0.3.1. Estrategia de control

Si bien hay varias estrategias de control para sistemas con señales de referencia alternas, se decidió utilizar un esquema de control repetitivo (RC) tal como está descripto en [1].

La ventaja del controlador repetitivo respecto al controlador resonante, otra opción explorada, es que este último introduce polos en s = ±jω0, debiendo introducir tantos controladores como frecuencias se quieran controlar. En cambio, el RC, al estar basado en el principio del modelo interno, introduce polos en s = ±jnω0, de manera de permitir seguir tanto la señal fundamental como sus armónicos, obteniendo así mejor performance.

### 0.3.2. Diagrama en bloques

Es necesario entonces, definir la estructura del sistema que se desea controlar. Es así como el diagrama en bloques del sistema completo se puede ver en la Figura 2. Se pueden observar los siguientes bloques y señales:

r(z): señal de referencia

e(z): señal de error

Grc(z): transferencia controlador repetitivo

Gc(z): transferencia del controlador del lazo interno

Gp(z): transferencia de la planta

Gf (z): transferencia del filtro de adquisición

i(z): salida de corriente

Cabe mencionar que en el planteo de este diagrama en bloques, se omitió el conversor analógicodigital y se trabajó directamente con el sistema discreto, teniendo en cuenta una frecuencia de muestreo fs = 128 × 50 Hz = 6400 Hz. Además, se trabajó con el modelo promediado, sin considerar la injerencia de la frecuencia del tuyo del PWM (100 kHz) por encontrarse muy por encima de la frecuencia máxima de trabajo del sistema de control.

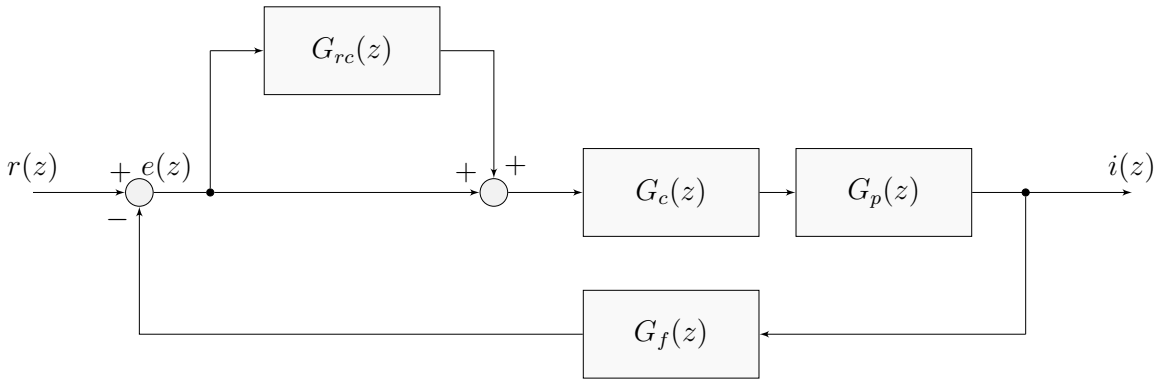
[picture p183: figure]
Grc(z)

Figura 2: Diagrama en bloques sistema completo

De aquí se pueden comenzar a definir las transferencias de los bloques.

La transferencia del filtro de adquisición, tal como fue definida en la sección ??, se puede definir como:
Gf (s) = 1

s

2
p

2 +

s
p + 1

·

1

s
p + 1

donde p es el polo del filtro, cuyo valor de diseño es 2π3400. Sin embargo, debido a que este sistema analógico es adquirido digitalmente, su transferencia debe ser analizada de manera discreta, obteniendo así:

Gf (z) = 0.9105z

2 + 0.4081z + 0.03233
z

3 + 0.3296z

2 + 0.02255z − 0.001261

La transferencia de la planta en este estadío del proyecto, sólo se puede estimar. Es por ello que se aproxima la impedancia de salida a:

L = 0.3 mH

R = 0.1 Ω

De esta forma, se define la transferencia como:

Gp(s) = 2VCC
s ∗ L + R
en donde 2VCC es la ganancia del modulador, siendo VCC = 24 V, obteniendo así una transferencia discreta:
Gp(z) = 24.36
z − 0.9492

Respecto del controlador repetitivo, su estructura interna se puede observar en la Figura 3. Siguiendo el principio del modelo interno, la mínima expresión para sintetizar los polos de un controlador repetitivo es:
Grc(z) = z

−N
1 − z

−N donde N es un entero fijo calculado como N = Tg/Ts, siendo Tg el período de la señal generada y Ts el período de muestreo. Sin embargo, se puede demostrar que esta forma simple no es estable. Se incorporan así dos bloques, Q(z) y L(z), quedando la transferencia siguiente:

Grc(z) = krc

Q(z)z

−N L(z)
1 − Q(z)z

−N

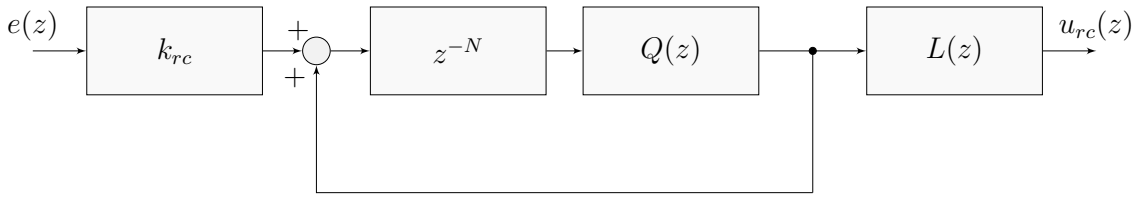
[picture p184: figure]
krc; urc(z)

Figura 3: Diagrama en bloques de controlador repetitivo

Q(z) es un filtro pasabajos, cuya función es seleccionar aquellas frecuencias que el sistema va a controlar y estabilizar el sistema a altas frecuencias. Por su simplicidad, se eligió el siguiente filtro FIR:
Q(z) = 0.25z + 0.5 + 0.25z

−1

Este filtro no añade retraso de fase, lo cual de otra forma degradaría la performance del controlador.

Se puede demostrar que la ganancia krc se debe encontrar entre 0 y 2 para que el sistema sea estable. De esta forma se elige el siguiente valor:

krc = 0.5

L(z) es un filtro de compensación de fase, cuya función es estabilizar el sistema a bajas frecuencias. Uno de los métodos de diseño del mismo es la compensación de fase cero. Esto implica plantear el filtro de la siguiente forma:

L(z) = 1 H(z)

Una vez finalizado el diseño del controlador repetitivo, se ajustó el controlador Gc(z). Se decidió utilizar un controlador proporcional que posee mínimo costo computacional y ofrece una respuesta transitoria aceptable. La ganancia del mismo fue elegida de acuerdo a las variaciones de los parámetros de la planta, que se asumen ±50 % para L y ±30 % para R.

Se obtuvo así el siguiente valor de ganancia:

Gc(z) = 0.001

que considerando el peor caso (L + 50 %, R − 20 %) se obtiene un margen de fase de aproximadamente 85°.

### 0.4. Módulo de adquisición y procesamiento de señales

Este módulo es el encargado de adquirir y procesar las señales provenientes de los instrumentos que se desean calibrar o caracterizar. El objetivo general del mismo es obtener parámetros comunes a partir de los cuales el software va a mostrar la información pertinente al usuario.

Entre las mediciones que se desean obtener se tiene:

Amplitud RMS

Amplitud RMS de armónicos, fundamental y continua

Distorsión total de la forma de onda (TWD)

### 0.4.1. Obtención de parámetros

La obtención de la amplitud RMS es sencilla, siguiéndose la siguiente ecuación:

URMS =

PN
n=1 x

2
[n]
N

en donde x[n] es el valor de la muestra n y N es la cantidad de muestras a partir de las cuales se calcula este parámetro, definido más adelante.

Para la obtención de la amplitud RMS de armónicos, fundamental y continua se siguió el algoritmo de medición de armónicos utilizando transformadas de Fourier discretas de ventana deslizante modulada o mSDFT, por sus siglas en inglés. Este método se puede encontrar desarrollado en [2].

La distorsión total de la forma de onda (TWD) permite cuantificar la distorsión armónica, incluyendo la distorsión por continua, interarmónicos y/o ruido, a diferencia de la distorsión armónica total (THD), que solo mide la distorsión armónica pura. La ecuación para su cálculo es la siguiente:

TW D =

p
U

2
RMS − U

2
1
U1
en donde URMS es la amplitud RMS de la señal y U1 es la amplitud de la fundamental.

### 0.4.2. Mecanismo de medición

Para la adquisición y procesado de las señales se siguió un mecanismo de medición basado en índices y tendencias (“index” y “trend”). El esquema seguido es de la Figura 4.

El muestreo se produce regularmente, 128 veces por ciclo de la frecuencia fundamental de 50 Hz. Este proceso es disparado por un timer del microcontrolador. Cuando el dispositivo tiene tiempo, se calcula los index y los trend. Este proceso al no ser prioritario no es necesario que sea provocado por una interrupción. El proceso de trend puede ser generado a partir de un real time clock de ser necesario, para mayor precisión.

Los index son generados cada 10 ciclos de la frecuencia fundamental. En ellos se obtiene las distintas amplitudes como la distorsión. A partir de los mismos se construye los trend. Estos son generados cada una cierta cantidad de minutos definida por el usuario, aunque usualmente se utilizan entre 1 y 3 segundos. Estas tendencias además de dar valores promediados a partir de los índices, proveen los valores máximos y mínimos de ese período.

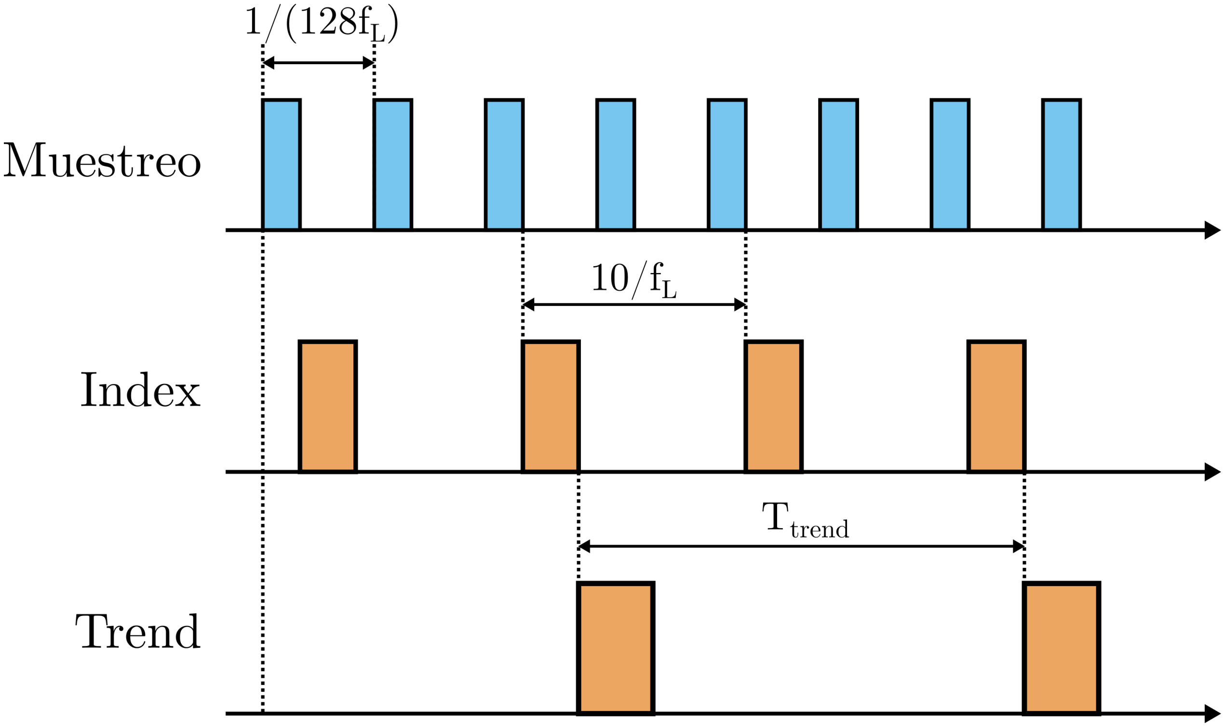
[picture p185: figure]

Figura 4: Esquema de adquisición y procesado de señales
