eloy-cacca/Trabajo-final/trabajo final/tesis aon/tesis/docs/et-junta/sections/.output/software.pdf

Calibrador y caracterizador de sondas de corriente | Especificaci´on t´ecnica

Para dise˜nar la interfaz del usuario en la PC, se decidi´o utilizar el lenguaje de programaci´on Python, por su simplicidad y cantidad de librer´ıas y recursos que se pueden encontrar en l´ınea.

Esta app fue dividida en dos, el backend que se comunica con el microcontrolador y la interfaz gr´afica utilizando la librer´ıa Tkinter. Esta librer´ıa fue elegida por su simplicidad y ya que viene incluida por defecto en Python.

En la Figura 1 se puede ver una imagen de la ventana principal. Se utiliza una barra superior, donde se puede elegir el puerto COM, refrescar la lista de puertos, conectarse al dispositivo y ver su estado; una barra lateral, donde se muestran y modifican par´ametros; y la ventana principal, donde se puede elegir el test a correr y ver su resultado.


Figura 1: Ventana principal interfaz PC

En cada uno de estos tests se podr´a guardar un informe en formato PNG o CSV, si se necesita trabajar con esos datos crudos. Adem´as, se pueden ver los logs del sistema, seleccionando el nivel de profundidad con el que se quiere inspeccionar.

Fecha: 05/08/2021 | Versi´on 1.0 | P´agina 1 de 1
