eloy-cacca/Trabajo-final/trabajo final/tesis aon/tesis/docs/ef/diagrams/puertos.png

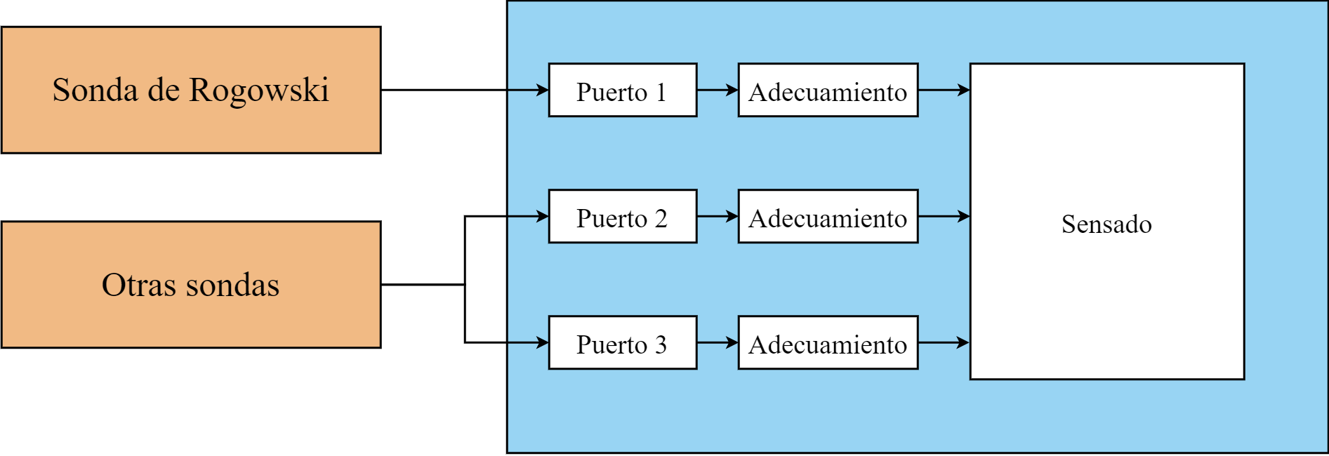
trabajo final/tesis aon/tesis/docs/ef/diagrams/puertos.png
