eloy-cacca/Trabajo-final/trabajo final/tesis aon/tesis/docs/et-junta/images/adc-digital-io.png

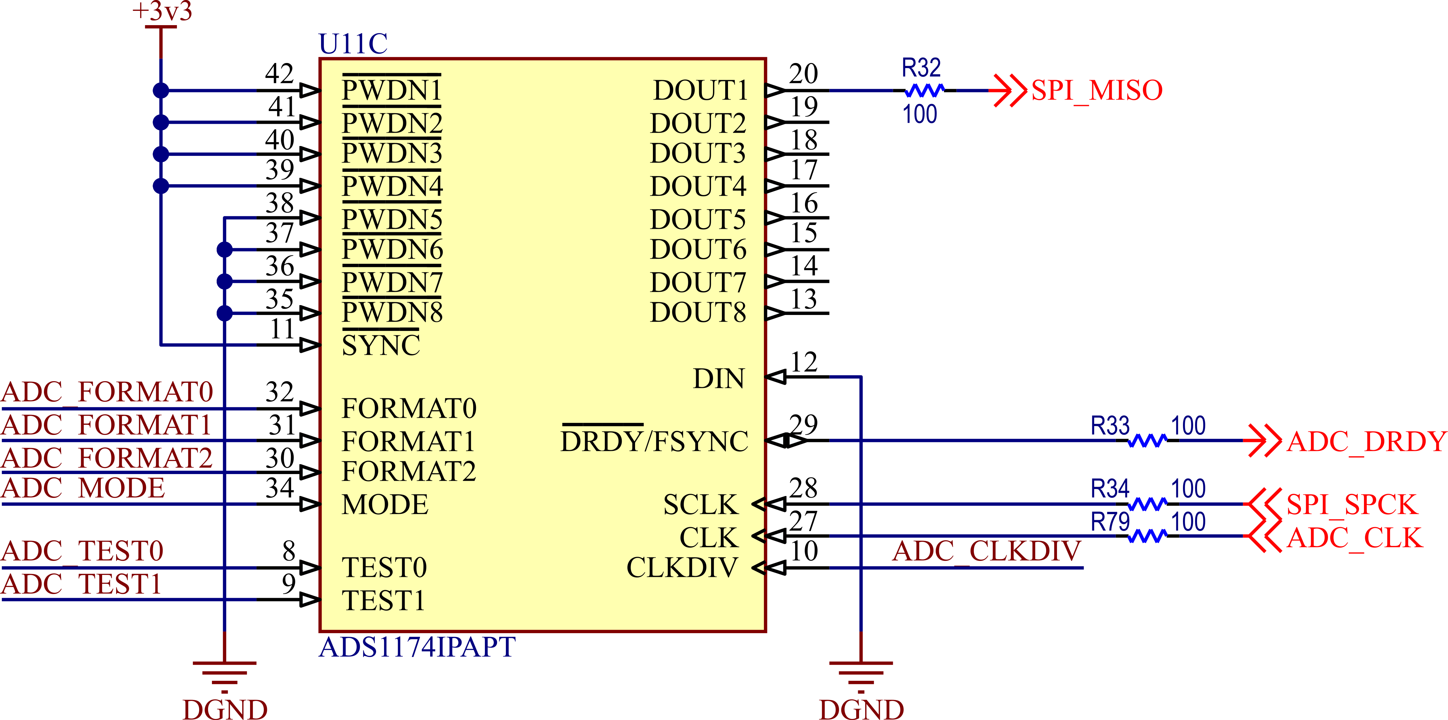
trabajo final/tesis aon/tesis/docs/et-junta/images/adc-digital-io.png
