eloy-cacca/Trabajo-final/trabajo final/tesis aon/tesis/docs/et-junta/images/analog-fuente-5v.png

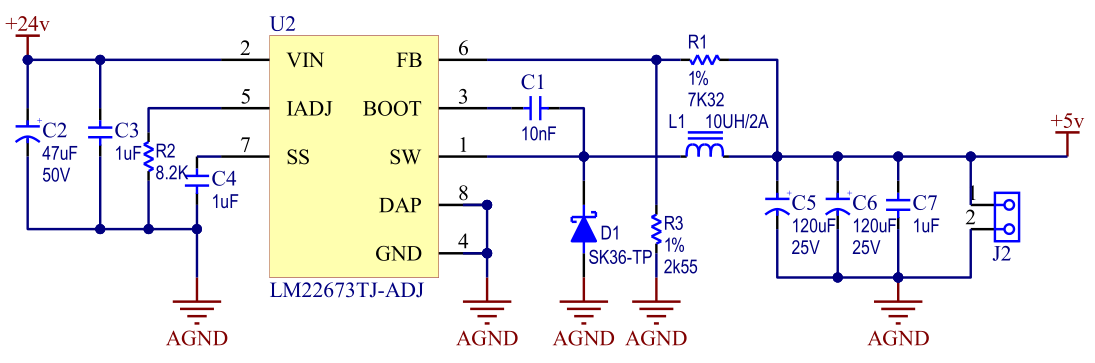
trabajo final/tesis aon/tesis/docs/et-junta/images/analog-fuente-5v.png
