eloy-cacca/Trabajo-final/trabajo final/tesis aon/tesis/docs/informe/images/mosfet-driver-selector.png

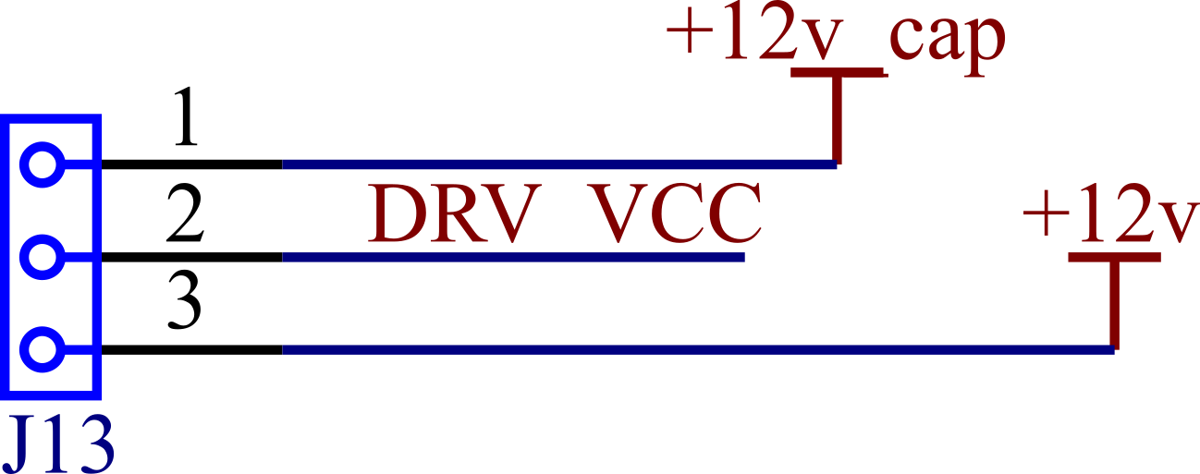
trabajo final/tesis aon/tesis/docs/informe/images/mosfet-driver-selector.png
