eloy-cacca/Trabajo-final/trabajo final/tesis aon/tesis/docs/informe/images/rogowski-esquematico.png

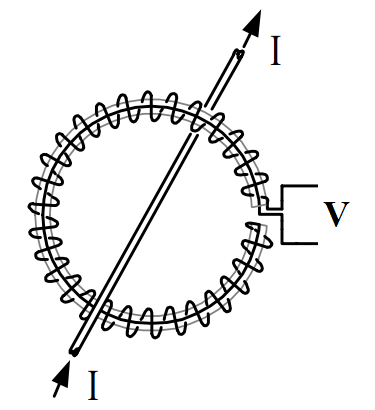
trabajo final/tesis aon/tesis/docs/informe/images/rogowski-esquematico.png
