eloy-cacca/Trabajo-final/curso altium/Trabajo Final/Project Outputs for Trabajo Final/lista componentes 23_11.xls

Line # | Description | Quantity | Manufacturer Part Number 1 | Supplier Part Number 1 | Designator
 | Conn Unshrouded Header HDR 10 POS 1.27mm Solder ST Top Entry SMD Minitek127® T/R | 1 | 20021121-00010C4LF | 609-3695-1-ND | ARM_JTAG
 | 0805 10 nF 50 V ±1% Tolerance C0G SMD Multilayer Ceramic Capacitor | 8 | GRM2195C1H103FA01D | GRM2195C1H103FA01D | C1, C2, C8, C9, C10, C11, C47, C48
 | Cap Film 10uF 500V PP 10% (31.5 X 22 X 36.5mm) Dipped Radial 27.5mm 105°C Bulk | 2 | B32754C2106K000 | 495-76101-ND | C3, C7
 | CAPACITOR, 0805, 100NF, 25V, REEL 4000 | 16 | CC0805KRX7R8BB104 | 311-1141-1-ND | C4, C14, C18, C19, C20, C21, C25, C26, C27, C28, C29, C30, C32, C33, C45, C46
 | YAGEO CC0805KKX7R7BB105 CERAMIC CAPACITOR, 1UF, 16V, X7R, 10%, 0805 | 6 | CC0805KKX7R7BB105 | 311-1365-1-ND | C5, C6, C12, C13, C34, C35
 | Multilayer Ceramic Capacitors MLCC - SMD/SMT 50volts 15pF 5% C0G | 4 | C0805X150J5GACTU | 399-7428-1-ND | C15, C22, C23, C31 | 11
 | CAP CER 10UF 16V X5R 0805 | 11 | CL21A106KOCL3RC | 1276-2398-2-ND | C16, C17, C24, C36, C37, C38, C40, C41, C42, C43, C44
 | Cap Ceramic 10uF 50V X5R 20% Pad SMD 1206 85°C T/R | 1 | CL31A106MBHNNNE | 1276-6736-1-ND | C39
 | DIODE ARRAY SCHOTTKY 40V SOT23 | 2 | BAS40-04-TP | BAS40-04TPMSDKR-ND | D1, D2 | 1
 | SMD LED red 2.4 V 0805, 150080RS75000, Würth Elektronik | 1 | 150080RS75000 | 732-4984-1-ND | D3
 | PANASONIC - DB2J20900L - Schottky Rectifier, 20 V, 500 mA, Single, SOD-323F, 2 Pins, 500 mV | 2 | DB2J20900L | 70358466 | D4, D5 | 3
 | LED GREEN CLEAR 0805 SMD | 1 | 150080VS75000 | 8154237P | D6
 | LED YELLOW CLEAR 0805 SMD | 1 | 150080YS75000 | 8154231P | D7
 |  | 2 |  |  | H1, H2
 | Ind General Purpose Chip Wirewound 10uH 10% 2.52MHz 50Q-Factor Ferrite 250mA 1812 T/R | 1 | CM453232-100KL | CM453232-100KLCT-ND | L1
 | Trans GP BJT NPN 40V 0.6A 3-Pin SOT-23 T/R | 2 | MMBT2222ALT1G | MMBT2222ALT1GOSCT-ND | Q1, Q2 | 6 | transistor
 | YAGEO - RC0805FR-074K7L - SMD 0805 [2012 Metric], 4.7 kohm, 125 mW | 6 | RC0805FR-074K7L | 6181408 | R1, R4, R7, R10, R16, R22
 | Res Thick Film smd 0805 3.16K Ohm 1% 0.125W(1/8W) | 2 | RC0805FR-073K16L | 311-3.16KCRCT-ND | R2, R5
 | Res Thick Film smd 0805 9.31K Ohm 1% 0.125W(1/8W) | 4 | RC0805FR-079K31L | 311-9.31KCRCT-ND | R3, R8, R15, R23
 | RES SMD 0805 10K OHM 1% 1/8W | 4 | RC0805FR-0710KL | 311-10.0KCRCT-ND | R6, R9, R21, R24
 | RES SMD 0805 412K OHM 1% 1/8W | 6 | RC0805FR-07412KL | 311-412KCRCT-ND | R11, R12, R13, R17, R18, R19 | 12
 | Res Thick Film smd 0805 15.8K Ohm 1% 0.125W(1/8W) | 2 | RC0805FR-0715K8L | 311-15.8KCRCT-ND | R14, R20
 | Res Thick Film smd 0805 130 Ohm 1% 0.125W( | 3 | RC0805FR-07130RL | 311-130CRCT-ND | R25, R33, R51 | 1
 | Thick Film Resistors - SMD 0805 100K ohm 5% 1/8W | 5 | AC0805JR-07100KL | YAG3756CT-ND | R26, R27, R28, R29, R47
 | Res Thick Film smd 0805 10K Ohm 5% 1/8W | 8 | RC0805JR-0710KL | 311-10KARCT-ND | R30, R31, R32, R34, R52, R53, R54, R55
 | Thick Film Resistors smd 1206(3216) 68K OHM 5% 250mW | 5 | RC1206JR-0768KL | 311-68KERCT-ND | R35, R36, R37, R38, R39 | 4 | res 0805
 | Thick Film Resistors SMD 1206 (3264) 100 OHM 5% 250mW | 7 | RC1206JR-07100RL | 311-100ERCT-ND | R40, R41, R42, R43, R44, R45, R46 | 23
 | RES SMD 1206 180K OHM 5% 1/4W | 1 | RC1206JR-07180KL | 82AH8580 | R48
 | Res Thick Film smd 0805 22 Ohm 5% 1/8W | 2 | RC0805JR-0722RL | 311-22ARCT-ND | R49, R50
 | IC OPAMP GP 2.8MHZ RRO 8SOIC | 2 |  | 296-2440-1-ND | U1, U13 | 12 | tlv2472
 | INTERSIL ISL21010CFH315Z-TK Voltage Reference, Precision Micropower, Series - Fixed, ISL21010 Series, 1.5V, SOT-23-3 | 2 | ISL21010CFH315Z-TK | ISL21010CFH315Z-TK | U2, U14
 | MICROCONTROLLER MCU, 32 BIT, CORTEX-M4, 120MHZ, LQFP-64; Architecture:ARM Cortex-M4; CPU Speed:120MHz; Program Memory Size:512KB; RAM Memory Size:128KB; No. of Pins:64; MCU Case Style:LQFP; No. of I/Os:47; Supply Voltage Min:1.62V ;RoHS Compliant: Yes | 1 | ATSAM4S8BA-AU | ATSAM4S8BA-AU-TRAY | U3 | 4 | micro arm
 | Conn; Data; SD (SanDisk Memory) Card Reader; Push - Push Type | 1 | 10067847-001RLF | 70248486 | U4
 | INTERSIL ISL21010CFH330Z-TK Voltage Reference, Precision Micropower, Series - Fixed, ISL21010 Series, 3V, SOT-23-3 | 1 | ISL21010CFH330Z-TK | ISL21010CFH330Z-TK | U5 | 2 | 3v regulador
 | LDO Regulator Pos 3.3V 0.8A 4-Pin(3+Tab) SOT-223 T/R | 2 | LM1117MP-3.3 | LM1117MP-3.3 | U6, U11
 | AC/DC CONVERTER 12V 10W | 1 | VOF-10B-S12 | 102-4145-ND | U7
 | Space saving 800-mA low-dropout linear regulator with internal current limit 4-SOT-223 0 to 125 | 1 | LM1117MP-5.0/NOPB | LM1117MP-5.0/NOPB | U8
 | Conn Mini USB 2.0 Type B RCP 5 POS 0.8mm Solder RA SMD 5 Terminal 1 Port Embossed T/R | 1 | UX60SC-MB-5S8 | H11589CT-ND | U9
 | Fixed Positive LDO Regulator, 1.8V, 1.3V Dropout, BIPolar, PDSO4 | 1 | LM1117MP-1.8/NOPB | LM1117MP-1.8/NOPBCT-ND | U10
 |  | 1 |  |  | U12
 | BATTERY HOLDER COIN 20MM PC PIN | 1 | BS-7 | BS-7-ND | U15
 | Crystal 0.032768MHz ±20ppm (Tol) 12.5pF Flexural 70000Ohm 2-Pin CSMD T/R | 1 | ECS-.327-12.5-34S-TR | XC1967CT-ND | Y1 | 5 | cristal
 | CRYSTAL 12.0000MHZ 20PF SMD | 1 | ECS-120-20-3X-TR | XC1770CT-ND | Y2 | 5 | cristal
