eloy-cacca/Trabajo-final/curso altium/Trabajo Final/Project Outputs for Trabajo Final/Trabajo Final.xls

Description | Quantity | Designator | Manufacturer Part Number 1 | Supplier Unit Price 1 | Supplier Subtotal 1 | otro modelo
Conn Unshrouded Header HDR 10 POS 1.27mm Solder ST Top Entry SMD Minitek127® T/R | 1 | ARM_JTAG | 20021121-00010C4LF
0805 10 nF 50 V ±1% Tolerance C0G SMD Multilayer Ceramic Capacitor | 8 | C1, C2, C8, C9, C10, C11, C47, C48 | GRM2195C1H103FA01D | 0.2548 | 2.04
CAP CER 10UF 16V X5R 0805 | 21 | C3, C7, C16, C17, C24, C36, C37, C38, C40, C41, C42, C61, C62, C63, C64, C65, C66, C67, C68, C69, C70 | CL21A106KOCL3RC
CAPACITOR, 0805, 100NF, 25V, REEL 4000 | 23 | C4, C14, C18, C19, C20, C21, C25, C26, C27, C28, C29, C30, C32, C33, C45, C46, C49, C50, C51, C52, C54, C55, C56 | CC0805KRX7R8BB104 | 0.084 | 1.93
YAGEO CC0805KKX7R7BB105 CERAMIC CAPACITOR, 1UF, 16V, X7R, 10%, 0805 | 9 | C5, C6, C12, C13, C34, C35, C58, C59, C60 | CC0805KKX7R7BB105 | 0.112 | 1.12
Multilayer Ceramic Capacitors MLCC - SMD/SMT 50volts 15pF 5% C0G | 4 | C15, C22, C23, C31 | C0805X150J5GACTU
Cap Ceramic 10uF 50V X5R 20% Pad SMD 1206 85°C T/R | 2 | C39, C71 | CL31A106MBHNNNE | 0.3 | 0.6 | c3225y5v1h106z
Cap Ceramic 0.0022uF 50V X7R 10% SMD 0805 125°C Paper T/R | 2 | C43, C44 | C0805C222K5RACTU |  |  | Son del ADC externo
KEMET - ESY107M050AG3AA - Elektrolytkondensator, 100 µF, 50 V, Produktreihe ESY, ± 20%, Radial bedrahtet, 8 mm | 2 | C53, C57 | ESY107M050AG3AA |  |  | Ver equivalente SMD 100X10 SMD
DIODE ARRAY SCHOTTKY 40V SOT23 | 2 | D1, D2 | BAS40-04-TP | 0.36 | 0.72 | bat542 free electron
SMD LED red 2.4 V 0805, 150080RS75000, Würth Elektronik | 1 | D3 | 150080RS75000 | 0.18 | 0.18 | Va led comun
PANASONIC - DB2J20900L - Schottky Rectifier, 20 V, 500 mA, Single, SOD-323F, 2 Pins, 500 mV | 2 | D4, D5 | DB2J20900L |  |  | 3 unidades
LED GREEN CLEAR 0805 SMD | 1 | D6 | 150080VS75000 | 0.096 | 48
LED YELLOW CLEAR 0805 SMD | 1 | D7 | 150080YS75000 | 0.096 | 48 | Va led comun
tira poste para erase y reset, modulo wifi(Cambiar de modo) | 2 | H1, H2
Connector | 1 | J1 |  |  |  | comprar free electron conector 2 pines
Connector | 1 | J2 |  |  |  | comprar free electron conector 4 pines
Ind General Purpose Chip Wirewound 10uH 10% 2.52MHz 50Q-Factor Ferrite 250mA 1812 T/R | 1 | L1 | CM453232-100KL | 0.43 | 0.43 | pm812-100j-rc
Trans GP BJT NPN 40V 0.6A 3-Pin SOT-23 T/R | 2 | Q1, Q2 | MMBT2222ALT1G
YAGEO - RC0805FR-074K7L - SMD 0805 [2012 Metric], 4.7 kohm, 125 mW | 6 | R1, R4, R7, R10, R16, R22 | RC0805FR-074K7L | 0.005 | 25
Res Thick Film smd 0805 3.16K Ohm 1% 0.125W(1/8W) | 2 | R2, R5 | RC0805FR-073K16L | 0.1 | 0.2
Res Thick Film smd 0805 9.31K Ohm 1% 0.125W(1/8W) | 4 | R3, R8, R15, R23 | RC0805FR-079K31L | 0.1 | 0.4
RES SMD 0805 10K OHM 1% 1/8W | 4 | R6, R9, R21, R24 | RC0805FR-0710KL | 0.1 | 0.4 | free electron
RES SMD 0805 412K OHM 1% 1/8W | 6 | R11, R12, R13, R17, R18, R19 | RC0805FR-07412KL | 0.042 | 0.42
Res Thick Film smd 0805 15.8K Ohm 1% 0.125W(1/8W) | 2 | R14, R20 | RC0805FR-0715K8L | 0.1 | 0.2
Res Thick Film smd 0805 130 Ohm 1% 0.125W( | 3 | R25, R33, R51 | RC0805FR-07130RL | 0.1 | 0.3 | 1 unidad
Thick Film Resistors - SMD 0805 100K ohm 5% 1/8W | 5 | R26, R27, R28, R29, R47 | AC0805JR-07100KL | 0.043 | 0.43
Res Thick Film smd 0805 10K Ohm 5% 1/8W | 8 | R30, R31, R32, R34, R52, R53, R54, R55 | RC0805JR-0710KL | 0.036 | 0.36 | free electron PR0805-10K
Res Thick Film smd 1206 10K Ohm 1% 0.25W(1/4W) | 1 | R35 | RC1206FR-0710KL
Thick Film Resistors smd 1206(3216) 68K OHM 5% 250mW | 4 | R36, R37, R38, R39 | RC1206JR-0768KL | 0.1 | 0.4 | erj-8geyj683v
Thick Film Resistors SMD 1206 (3264) 100 OHM 5% 250mW | 11 | R40, R41, R42, R43, R44, R45, R46, R56, R57, R58, R59 | RC1206JR-07100RL | 0.063 | 0.693
RES SMD 1206 180K OHM 5% 1/4W | 1 | R48 | RC1206JR-07180KL |  |  | erj-8geyj184v
Res Thick Film smd 0805 22 Ohm 5% 1/8W | 2 | R49, R50 | RC0805JR-0722RL | 0.1 | 0.2
IC OPAMP GP 2.8MHZ RRO 8SOIC | 2 | U1, U13 | TLV2472CDR | 2.73 | 5.46
Charge Pump INV/STPUP -1.5V to -5.5V 120mA 8-Pin SOIC T/R | 1 | U2 | LM2660MX/NOPB
MICROCONTROLLER MCU, 32 BIT, CORTEX-M4, 120MHZ, LQFP-64; Architecture:ARM Cortex-M4; CPU Speed:120MHz; Program Memory Size:512KB; RAM Memory Size:128KB; No. of Pins:64; MCU Case Style:LQFP; No. of I/Os:47; Supply Voltage Min:1.62V ;RoHS Compliant: Yes | 1 | U3 | ATSAM4S8BA-AU
INTERSIL ISL21010CFH330Z-TK Voltage Reference, Precision Micropower, Series - Fixed, ISL21010 Series, 3V, SOT-23-3 | 1 | U5 | ISL21010CFH330Z-TK
LDO Regulator Pos 3.3V 0.8A 4-Pin(3+Tab) SOT-223 T/R | 2 | U6, U11 | LM1117MP-3.3 |  |  | free electron
AC/DC CONVERTER 12V 10W | 1 | U7 | VOF-10B-S12 | 12.02 | 12.02 | hay stock
Space saving 800-mA low-dropout linear regulator with internal current limit 4-SOT-223 0 to 125 | 2 | U8, U20 | LM1117MP-5.0/NOPB |  |  | free electron
Conn Mini USB 2.0 Type B RCP 5 POS 0.8mm Solder RA SMD 5 Terminal 1 Port Embossed T/R | 1 | U9 | UX60SC-MB-5S8 | 0.99 | 0.99 | 3 uniades
Strain Relief Bushing; .437" Mounting Hole; Black | 1 | U10 | 1074 | 0.66 | 0.66 | Porta pila vertical free electron
Modulo Wifi | 1 | U12
ISL21080 Series 1.5 V 0.5% 300nA NanoPower Voltage Reference - SOT-23-3 | 3 | U14, U16, U18 | ISL21080CIH315Z-TK | 2.06 | 6.18 | free electron
1.10mm Pitch microSD Memory Card Connector, Surface Mount, Push-Pull Type, 1.42mm Height, with Detect Switch | 1 | U15 | 104031-0811 | 2.12 | 2.12
Octal Channel Quad ADC Delta-Sigma 52ksps 16-bit Serial 64-Pin HTQFP EP T/R | 1 | U17 | ADS1174IPAPT | 16.29 | 16.29 | adc externo
Fixed Positive LDO Regulator, 1.8V, 1.3V Dropout, BIPolar, PDSO4 | 1 | U19 | LM1117MP-1.8/NOPB |  |  | adc externo/free electron
Crystal 0.032768MHz ±20ppm (Tol) 12.5pF Flexural 70000Ohm 2-Pin CSMD T/R | 1 | Y1 | ECS-.327-12.5-34S-TR
CRYSTAL 12.0000MHZ 20PF SMD | 1 | Y2 | ECS-120-20-3X-TR | 0.35 | 0.35
