eloy-cacca/Trabajo-final/trabajo final/tesis aon/Nueva carpeta/PM2PM1MB1_PCB_RevA_ic_161017_Altium/pqm_v2/Project Outputs for pqm_v2/pqm_v2.xls

Comment | Description | Digikey Part Number | Mouser Part Number | Quantity
CAP_C3216X7R2J103K115AA_TDK | 10000pF, 630 V, Capacitores cerámicos, X7R, 1206 (3216 métrico), 0.126" L x 0.063" A (3.20 mm x 1.60 mm) | 445-2291-1-ND | 810-C3216X7R2J103K | 1
CAP_EEE-1HA470XP_PANASONIC | 47µF 50V Aluminum Capacitors Radial, Can - SMD 2000 Hrs @ 85°C | PCE3929CT-ND | 667-EEE-1HA470XP | 1
CAP_C3216X7R1E105M085AA_TDK | 1 µF, 25 V, Capacitores cerámicos, X7R, 1206 (3216 métrico), 0.126" L x 0.063" A (3.20 mm x 1.60 mm) | 445-4024-1-ND | 810-C3216X7R1E105M-2 | 5
CAP_ELXY250ELL121MF15D_UC | CAP ALUM 120UF 20% 25V RADIAL | 565-1791-ND | 661-ELXY250ELL121MF1 | 2
CAP_GRM2195C1H103FA01D_MURATA | CAP CER 10000PF 50V NP0 0805 | 490-8295-1-ND | 81-GRM2195C1H103FA1D | 32
CAP_CC0805KRX7R8BB104_YAGEO | CAP CER 0.1UF 25V 10% X7R 0805 | 311-1141-1-ND | 603-CC805KRX7R8BB104 | 26
CAP_CC0805KKX7R7BB105_YAGEO | CAP CER 1UF 16V X7R 0805 | 311-1365-1-ND | 603-CC805KKX7R7BB105 | 13
CAP_CC1206KKX7R7BB225_YAGEO | CAP CER 2.2UF 16V X7R 1206 | 311-1957-1-ND | 603-CC126KKX7R7BB225 | 1
CAP_C2012X6S1C106K085AC_TDK | CAP CER 10UF 16V 10% X6S 0805 | 445-14483-1-ND | 810-C2012X6S1C106K0C | 3
CAP_C0805X150J5GACTU_KEMET | CAP CER 15PF 50V NP0 0805 | 399-7428-1-ND | 80-C0805X150J5G | 4
CAP_CC0805JRNPO9BN101_YAGEO | CAP CER 100PF 50V NPO 0805 | 311-1111-1-ND | 603-CC805JRNPO9BN101 | 8
DIO_SK36_MICROCOM | DIODE SCHOTTKY 60V 3A SMC | SK36-TPMSCT-ND | 833-SK36-TP | 1
DIO_DB2J20900L_PANASONIC | DIODE SCHOTTKY 20V 500MA SMINI2 | DB2J20900LCT-ND | 667-DB2J20900L | 2
LED | LED |  |  | 1
CON_DB_15 | Receptacle Assembly, 15 Position, Right Angle, 8.08mm Series, Amplimite, with Screwlocks |  |  | 2
DIM 100 - F28335 |  | A121375-ND | 571-5390213-1 | 1
CON_Header_2X4 |  |  |  | 1
HeaderX2 |  |  |  | 4
CON_RADX2 |  |  |  | 5
HeaderX8 |  |  |  | 1
CON_HeaderX40 |  |  |  | 1
CON_20021121-00010C4LF_FCI | CONN HEADER 10POS DL UNSHRD SMD | 609-3695-1-ND | 649-202112100010C4LF | 1
COM_HeaderX9 |  |  |  | 1
Header_DSP_1 |  |  |  | 1
CON_BAT | HOLDER COINCELL 2032 RETAINRCLIP | BS-7-ND | 122-2420-GR | 1
CON_HeaderX30 |  |  |  | 1
CON_RADX2b |  |  |  | 2
MAG_SRR1005-100M_BOURNS | FIXED IND 10UH 2A 65 MOHM SMD | SRR1005-100MCT-ND | 652-SRR1005-100M | 1
MAG_CM453232-100KLCT_BOURNS | FIXED IND 10UH 2A 65 MOHM SMD | CM453232-100KLCT-ND | 652-CM453232-100KL | 2
RES_ERJ-8ENF2551V_Panasonic | RES SMD 2.55K OHM 1% 1/4W 1206 | P2.55KFCT-ND | 667-ERJ-8ENF2551V | 1
RES_ERJ-8GEYJ822V_Panasonic | RES SMD 8.2K OHM 5% 1/4W 1206 | P8.2KECT-ND | 667-ERJ-8GEYJ822V | 1
RES_ERJ-8ENF7321V_Panasonic | RES SMD 7.32K OHM 1% 1/4W 1206 | P7.32KFCT-ND | 667-ERJ-8ENF7321V | 1
RES_RC0805FR-0710KL_YAGEO | RES SMD 10K OHM 1% 1/8W 0805 | 311-10.0KCRCT-ND | 603-RC0805FR-0710KL | 16
RES_RC0805FR-07412KL_YAGEO | RES SMD 412K OHM 1% 1/8W 0805 | 311-412KCRCT-ND | 603-RC0805FR-07412KL | 24
RES_RC0805FR-074K7L_YAGEO | RES SMD 4.7K OHM 1% 1/8W 0805 | 311-4.70KCRCT-ND | 603-RC0805FR-074K7L | 24
RES_RC0805FR-079K31L_YAGEO | RES SMD 9.31K OHM 1% 1/8W 0805 | 311-9.31KCRCT-ND | 603-RC0805FR-079K31L | 16
RES_RC0805FR-07510KL_YAGEO | RES SMD 510K OHM 1% 1/8W 0805 | 311-510KCRCT-ND | 603-RC0805FR-07510KL | 8
RES_RC0805FR-0749K9L_YAGEO | RES SMD 49.9K OHM 1% 1/8W 0805 | 311-49.9KCRCT-ND | 603-RC0805FR-0749K9L | 4
RES_RC0805FR-0715K8L_YAGEO | RES SMD 15.8K OHM 1% 1/8W 0805 | 311-15.8KCRCT-ND | 603-RC0805FR-0715K8L | 8
RES_RC0805FR-073K16L_YAGEO | RES SMD 3.16K OHM 1% 1/8W 0805 | 311-3.16KCRCT-ND | 603-RC0805FR-073K16L | 8
RES_RC1206FR-0710KL_Yageo | RES SMD 10K OHM 1% 1/4W 1206 | 311-10.0KFRCT-ND | 603-RC1206FR-0710KL | 1
RES_RC0805FR-071RL_YAGEO | RES SMD 1 OHM 1% 1/8W 0805 | 311-1.00CRCT-ND | 603-RC0805FR-071RL | 4
RES_AC0805JR-07100KL_YAGEO | RES SMD 100K OHM 5% 1/8W 0805 | YAG3756CT-ND | 603-AC0805JR-07100KL | 5
RES_RC0805JR-0710KL_YAGEO | RES SMD 10K OHM 5% 1/8W 0805 | 311-10KARCT-ND | 603-RC0805JR-0710KL | 2
RES_RC0805JR-07330RL_YAGEO | RES SMD 330 OHM 5% 1/8W 0805 | 311-330ARCT-ND | 603-RC0805JR-07330RL | 1
IC_LM22673TJ-ADJ | 3A SIMPLE SWITCHER® Step-Down Voltage Regulator with Adjustable Soft-Start and Current Limit, 7-pin TO-263 Thin | LM22673TJ-ADJ/NOPBCT-ND | 926-LM22673TJADJNOPB | 1
IC_DCR010503U_TI | IC REG ISOLATED 3.3V 0.3A 12SOP | 296-9450-5-ND | 595-DCR010503U | 1
IC_TLV2472_ANALOG | IC OPAMP GP 2.8MHZ RRO 8SOIC | 296-2440-1-ND | 595-TLV2472CDR | 4
IC_TLV2474_ANALOG | IC OPAMP GP 2.8MHZ RRO 14SOIC | 296-2442-1-ND | 595-TLV2474CDR | 2
IC_INA121U | IC OPAMP INSTR 600KHZ 8SOIC | INA121UA-ND | 595-INA121UA | 4
IC_ATSAM4S8BA-AU_ATMEL | IC MCU 32BIT 512KB FLASH 64LQFP | ATSAM4S8BA-AU-ND | 556-ATSAM4S8BA-AU | 1
ISL21010_1V5 | IC VREF SERIES 1.5V SOT23-3 | ISL21010CFH315Z-TKCT-ND | 968-ISL21010CFH315ZT | 4
ISL21010_2V5 | IC VREF SERIES 2.5V SOT23-3 | ISL21010CFH325Z-TKCT-ND | 968-ISL21010CFH325ZT | 1
ISL21010_3V0 | IC VREF SERIES 3V SOT23-3 | ISL21010CFH330Z-TKCT-ND | 968-ISL21010CFH330ZT | 1
IC_IAZ23C5V6-E3-18_VISHAY | DIODE ZENER ARRAY 5.6V SOT23 | AZ23C5V6-E3-18CT-ND | 78-AZ23C5V6-E3-18 | 4
MSC_ECS-.327-12.5-34S-TR_ECS | CRYSTAL 32.7680KHZ 12.5PF SMD | XC1967CT-ND | 520-ECS32.7-12.534ST | 1
MSC_ECS-120-20-3X-TR_ECS | 12 MHz ±30 ppm Cristales 20 pF 60 Ohm -10°C ~ 70°C Montaje en superficie HC49/US | XC1770DKR-ND | 520-120-20-3XT | 1
