eloy-cacca/Trabajo-final/curso altium/PCB_Project/3D models/User Library-CR2012-0805.step

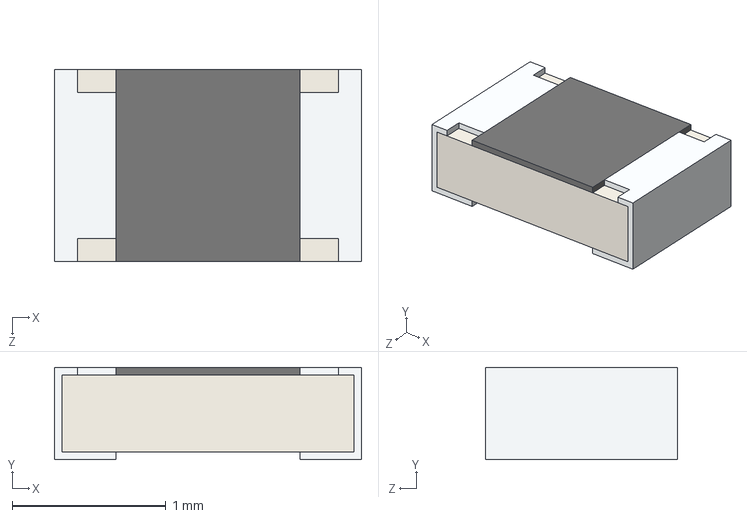
[picture p193: CAD file, 2021-11-13]
curso altium/PCB_Project/3D models/User Library-CR2012-0805.step
2.00 x 0.6 x 1.25 mm
