eloy-cacca/Trabajo-final/curso altium/Trabajo Final/3D Models/Cap/cap smd 1206/2021-10-05_21-04-04/CAPC370195_120N_KEM.step

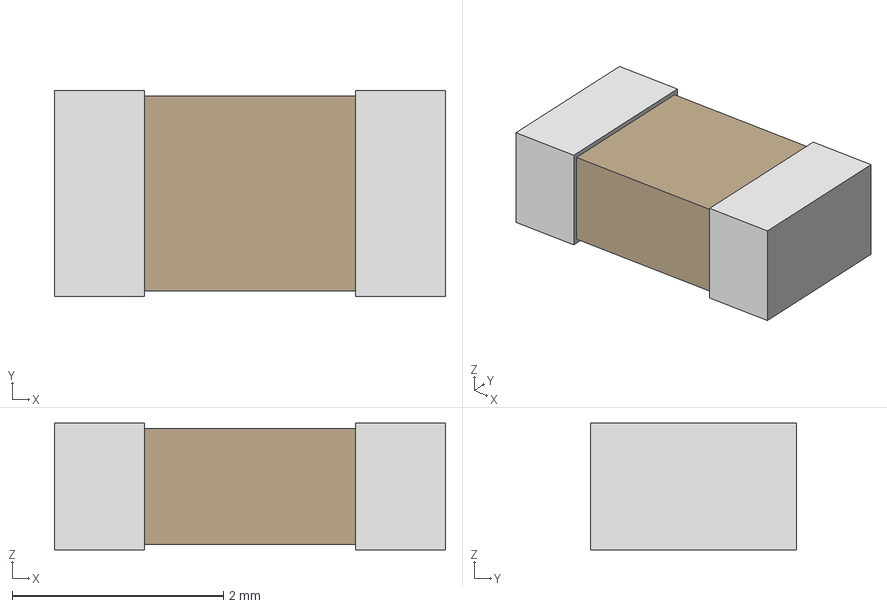
[picture p194: CAD file, 2021-11-13]
curso altium/Trabajo Final/3D Models/Cap/cap smd 1206/2021-10-05_21-04-04/CAPC370195_120N_KEM.step
3.70 x 1.95 x 1.20 mm
