eloy-cacca/Trabajo-final/curso altium/Trabajo Final/3D Models/Cap/cap smd 1210.stp

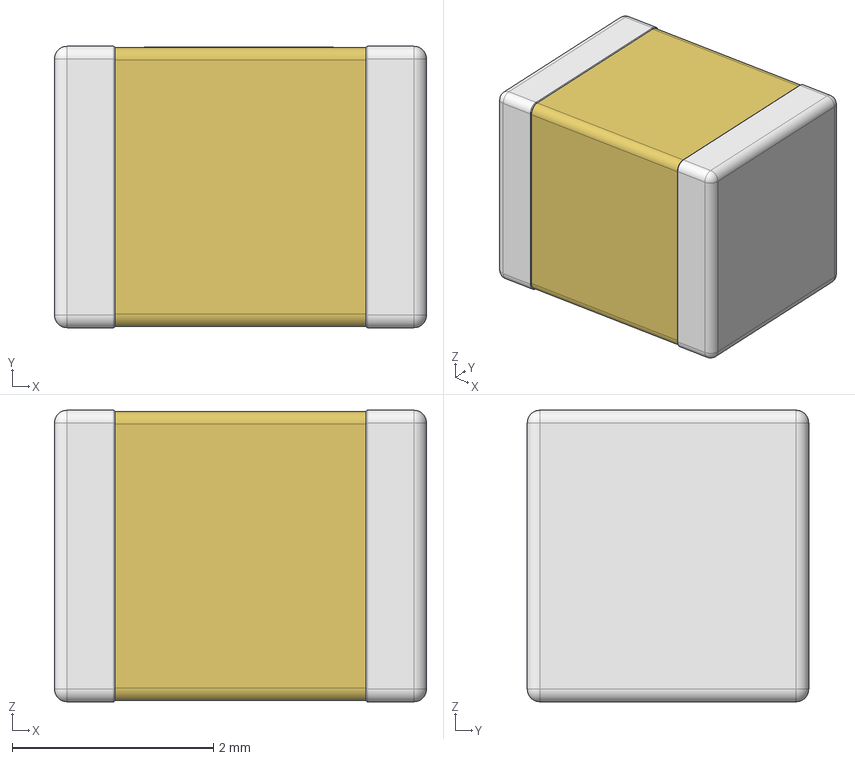
[picture p195: CAD file, 2021-11-13]
curso altium/Trabajo Final/3D Models/Cap/cap smd 1210.stp
3.70 x 2.80 x 2.90 mm
