eloy-cacca/Trabajo-final/curso altium/Trabajo Final/3D Models/Diodo/LED0603_BLUE.STEP

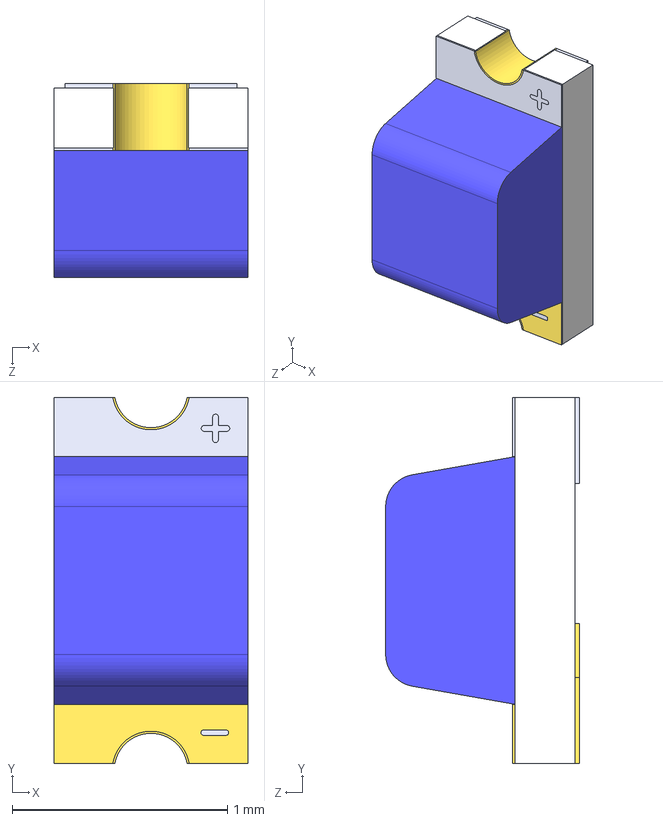
[picture p196: CAD file, 2021-11-13]
curso altium/Trabajo Final/3D Models/Diodo/LED0603_BLUE.STEP
0.9 x 1.70 x 0.9 mm
User_Library-LTST-C190GKT_Pad005
User_Library-LTST-C190GKT_Pad001
User_Library-LTST-C190GKT_Pad006
User_Library-LTST-C190GKT_Pad004
User_Library-LTST-C190GKT_Pad003
User_Library-LTST-C190GKT_Pad007
User_Library-LTST-C190GKT_Lens
User_Library-LTST-C190GKT_Pad
String+
String-
