eloy-cacca/Trabajo-final/curso altium/Trabajo Final/3D Models/inductores/inductor smd 1812.stp

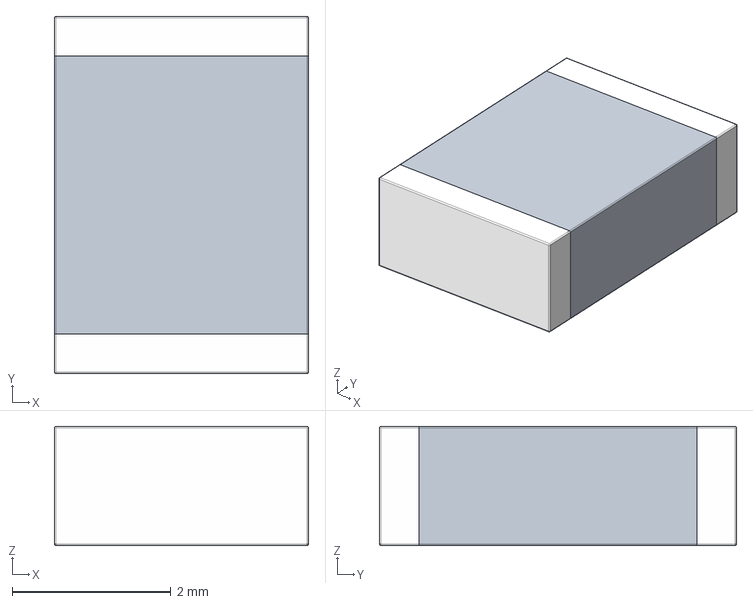
[picture p197: CAD file, 2021-11-13]
curso altium/Trabajo Final/3D Models/inductores/inductor smd 1812.stp
3.20 x 4.50 x 1.50 mm
