eloy-cacca/Trabajo-final/curso altium/Trabajo Final/3D Models/others/source 12V.step

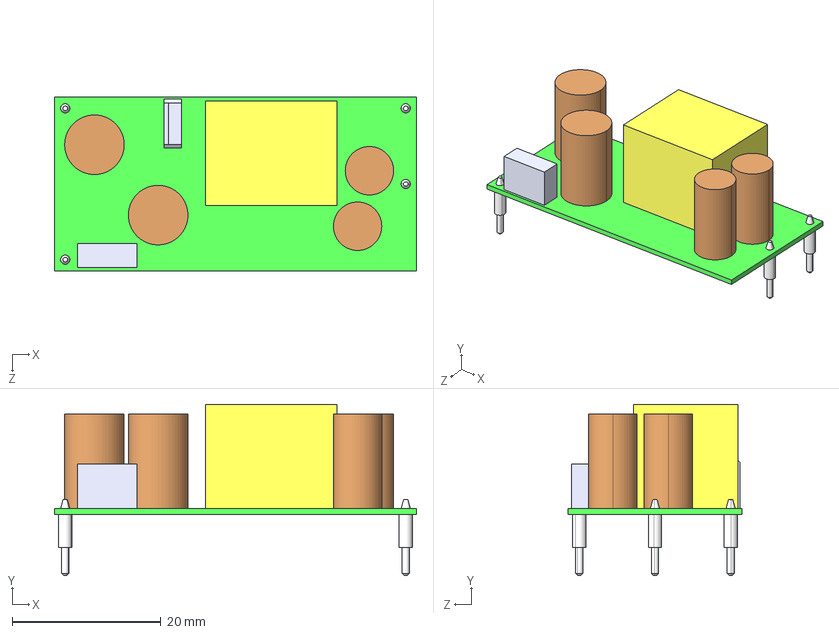
[picture p198: CAD file, 2021-11-13]
curso altium/Trabajo Final/3D Models/others/source 12V.step
48.6 x 23.0 x 23.3 mm
VOF-10B PCB
VOF-B PIN x 4
