eloy-cacca/Trabajo-final/curso altium/Trabajo Final/3D Models/res/RES1206.step

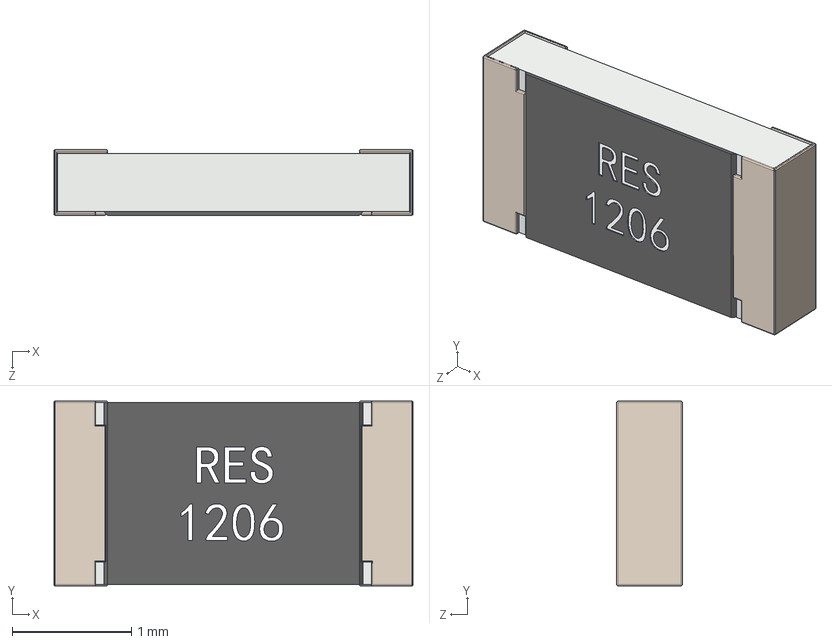
[picture p199: CAD file, 2021-11-13]
curso altium/Trabajo Final/3D Models/res/RES1206.step
3.01 x 1.55 x 0.55 mm
