eloy-cacca/Trabajo-final/curso altium/PCB_Project/3D models/User Library-LED 0603.step

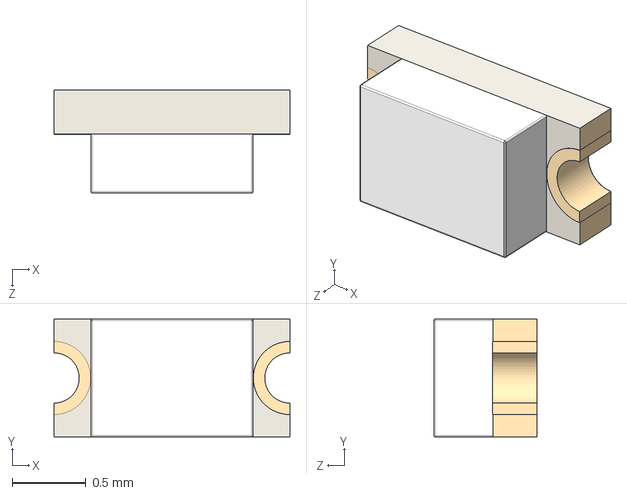
[picture p200: CAD file, 2021-11-13]
curso altium/PCB_Project/3D models/User Library-LED 0603.step
1.60 x 0.8 x 0.701 mm
