eloy-cacca/Trabajo-final/curso altium/Trabajo Final/3D Models/Diodo/diode (SMA).step

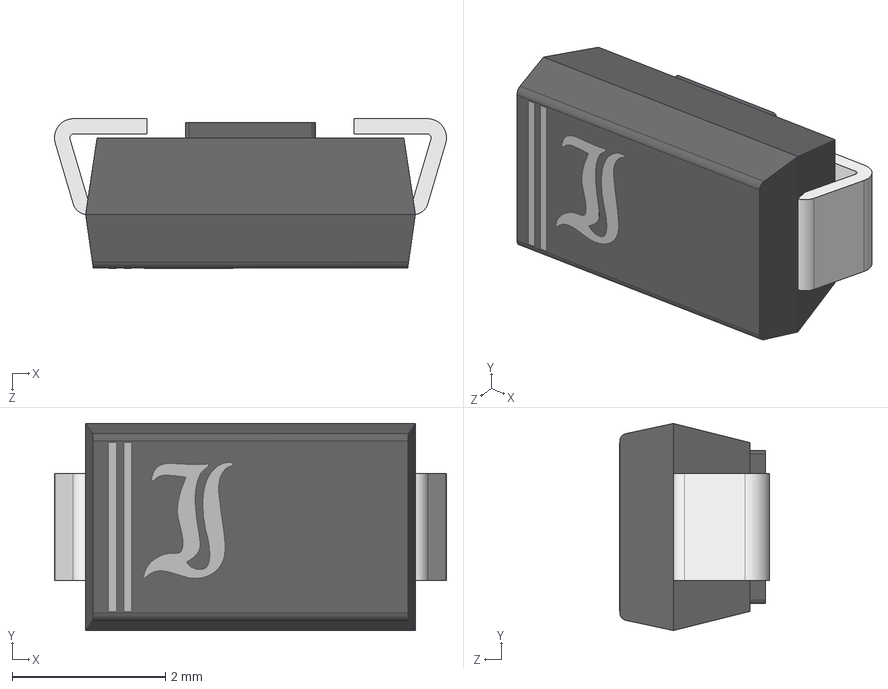
[picture p202: CAD file, 2021-11-13]
curso altium/Trabajo Final/3D Models/Diodo/diode (SMA).step
5.11 x 2.70 x 1.95 mm
