eloy-cacca/Trabajo-final/curso altium/Trabajo Final/3D Models/inductores/srr1005-100m.stp

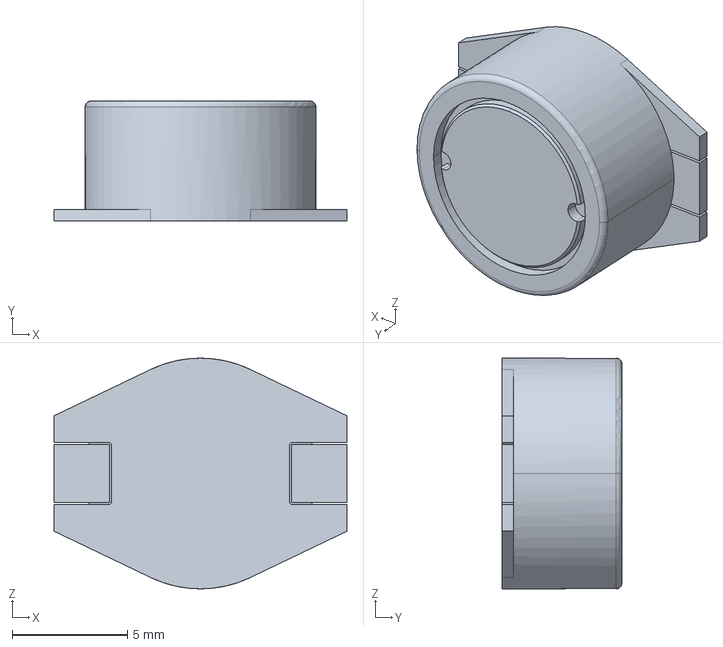
[picture p203: CAD file, 2021-11-13]
curso altium/Trabajo Final/3D Models/inductores/srr1005-100m.stp
12.7 x 5.20 x 10.0 mm
