eloy-cacca/Trabajo-final/curso altium/Trabajo Final/3D Models/others/Varistor 0805.stp

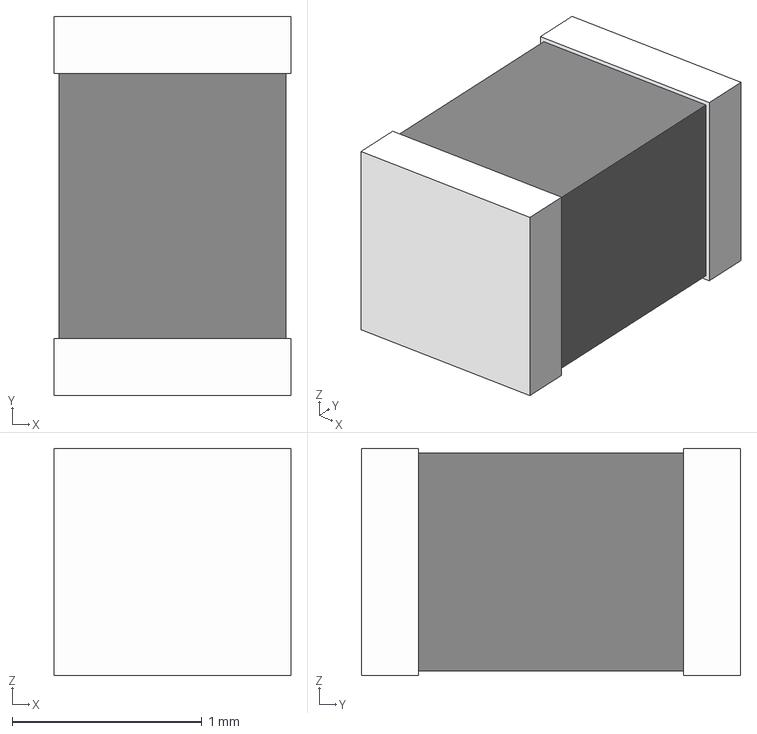
[picture p204: CAD file, 2021-11-13]
curso altium/Trabajo Final/3D Models/others/Varistor 0805.stp
1.25 x 2.00 x 1.20 mm
