eloy-cacca/Trabajo-final/curso altium/Trabajo Final/3D Models/res/res0805.stp

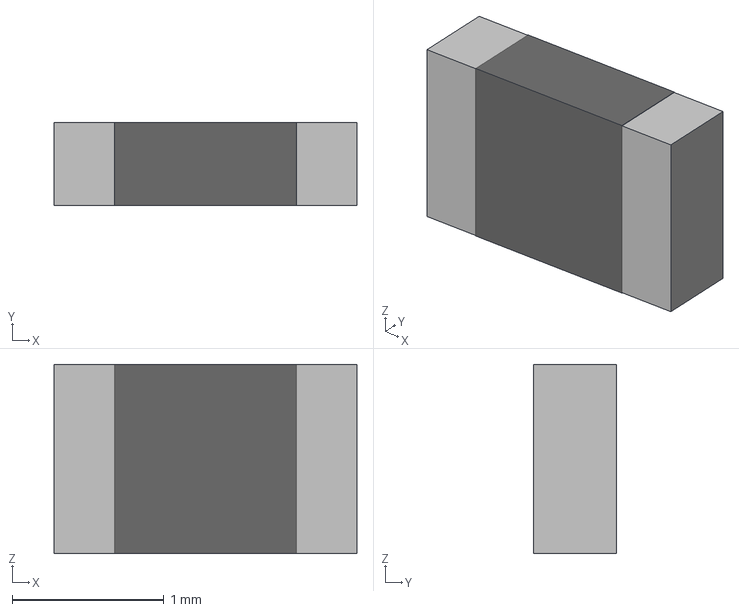
[picture p205: CAD file, 2021-11-13]
curso altium/Trabajo Final/3D Models/res/res0805.stp
2.00 x 0.55 x 1.25 mm
