eloy-cacca/Trabajo-final/curso altium/Trabajo Final/3D Models/Cap/Cap electro 8x11_5x3_5mm.step

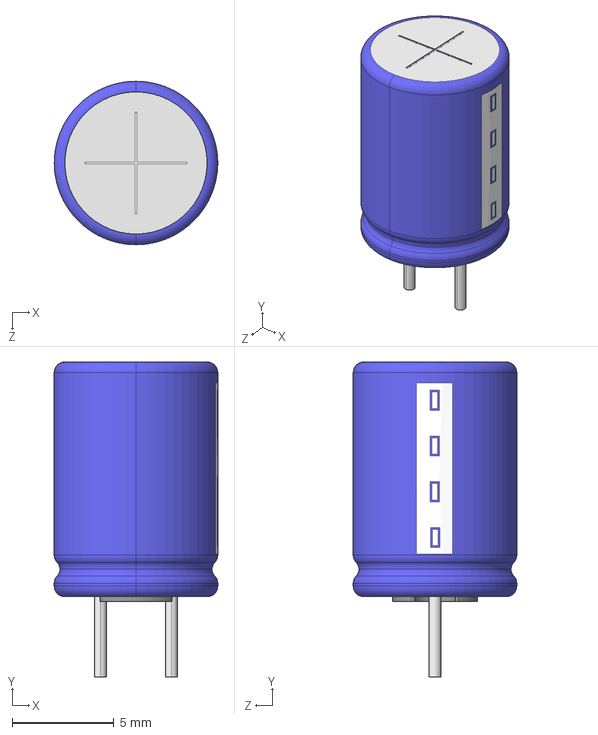
[picture p207: CAD file, 2021-11-13]
curso altium/Trabajo Final/3D Models/Cap/Cap electro 8x11_5x3_5mm.step
8.05 x 15.5 x 8.05 mm
