eloy-cacca/Trabajo-final/curso altium/Trabajo Final/3D Models/Diodo/LED_0603_G.STEP

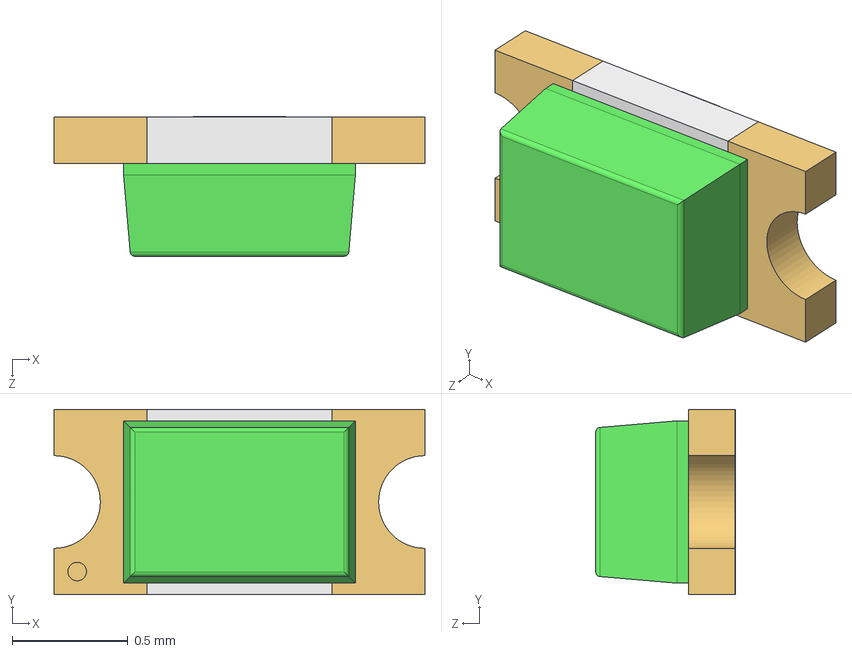
[picture p208: CAD file, 2021-11-13]
curso altium/Trabajo Final/3D Models/Diodo/LED_0603_G.STEP
1.60 x 0.8 x 0.602 mm
