eloy-cacca/Trabajo-final/curso altium/Trabajo Final/3D Models/others/crystal 32k.step

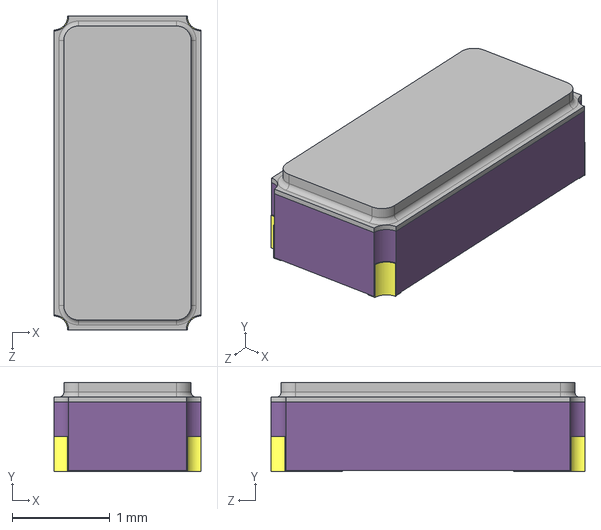
[picture p209: CAD file, 2021-11-13]
curso altium/Trabajo Final/3D Models/others/crystal 32k.step
1.50 x 0.91 x 3.20 mm
