eloy-cacca/Trabajo-final/curso altium/Trabajo Final/3D Models/res/res0603.stp

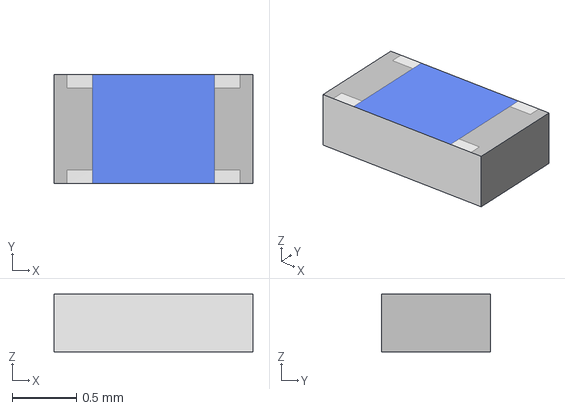
[picture p210: CAD file, 2021-11-13]
curso altium/Trabajo Final/3D Models/res/res0603.stp
1.55 x 0.85 x 0.45 mm
