eloy-cacca/Trabajo-final/curso altium/Trabajo Final/3D Models/Cap/cap alum 6.3x15.STEP

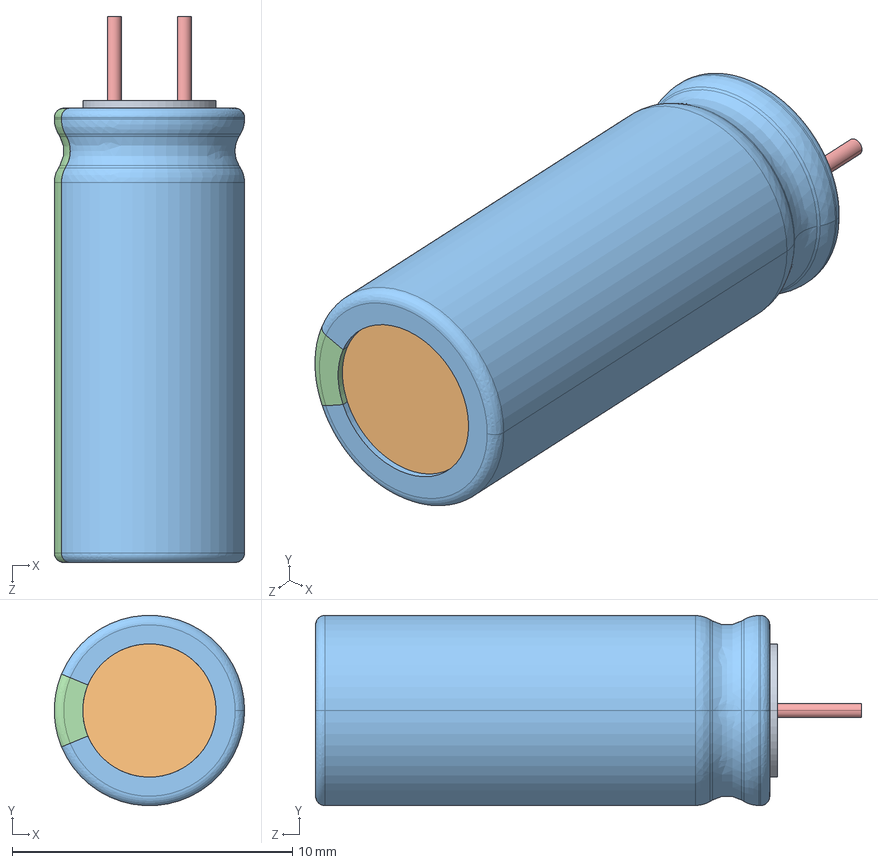
[picture p211: CAD file, 2021-11-13]
curso altium/Trabajo Final/3D Models/Cap/cap alum 6.3x15.STEP
6.79 x 6.79 x 19.5 mm
rubber_pad
can
shell_and_minus
shell_and_minus_2
lead x 2
