eloy-cacca/Trabajo-final/curso altium/Trabajo Final/3D Models/Diodo/0805LED-YELLOW.step

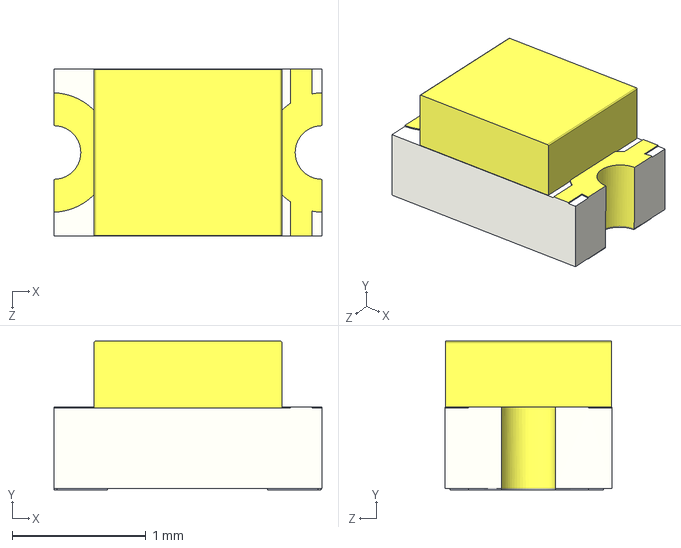
[picture p212: CAD file, 2021-11-13]
curso altium/Trabajo Final/3D Models/Diodo/0805LED-YELLOW.step
2.00 x 1.11 x 1.25 mm
