eloy-cacca/Trabajo-final/curso altium/Trabajo Final/3D Models/others/crystal 12M.STEP

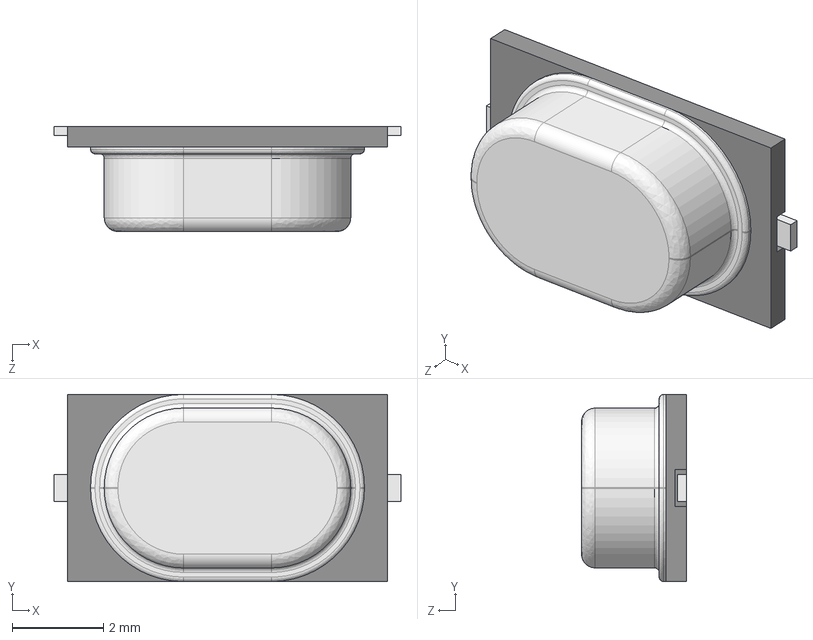
[picture p213: CAD file, 2021-11-13]
curso altium/Trabajo Final/3D Models/others/crystal 12M.STEP
7.60 x 4.10 x 2.30 mm
