eloy-cacca/Trabajo-final/curso altium/Trabajo Final/3D Models/Cap/cap smd 0603 (1608M).stp

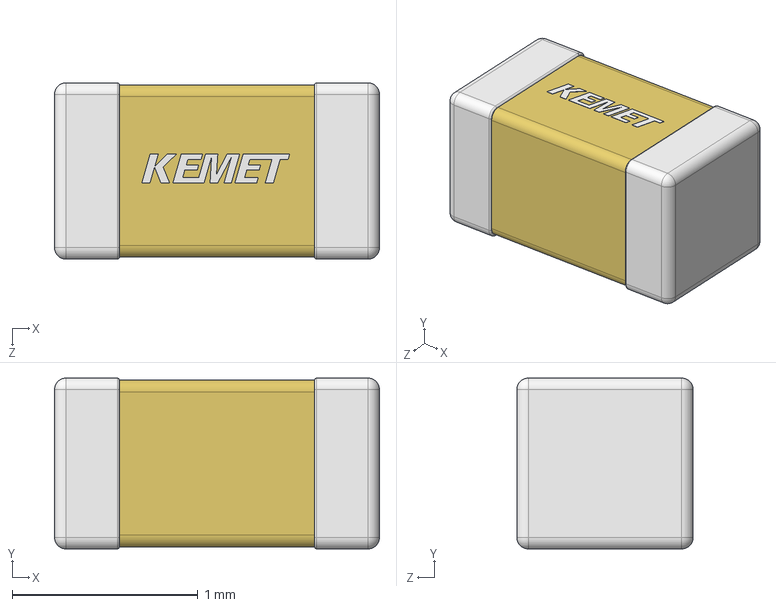
[picture p214: CAD file, 2021-11-13]
curso altium/Trabajo Final/3D Models/Cap/cap smd 0603 (1608M).stp
1.75 x 0.92 x 0.95 mm
Base_12
Termination_12 x 2
