eloy-cacca/Trabajo-final/curso altium/Trabajo Final/3D Models/others/SWITCH TACTILE SPST-NO 0.05A 24V.stp

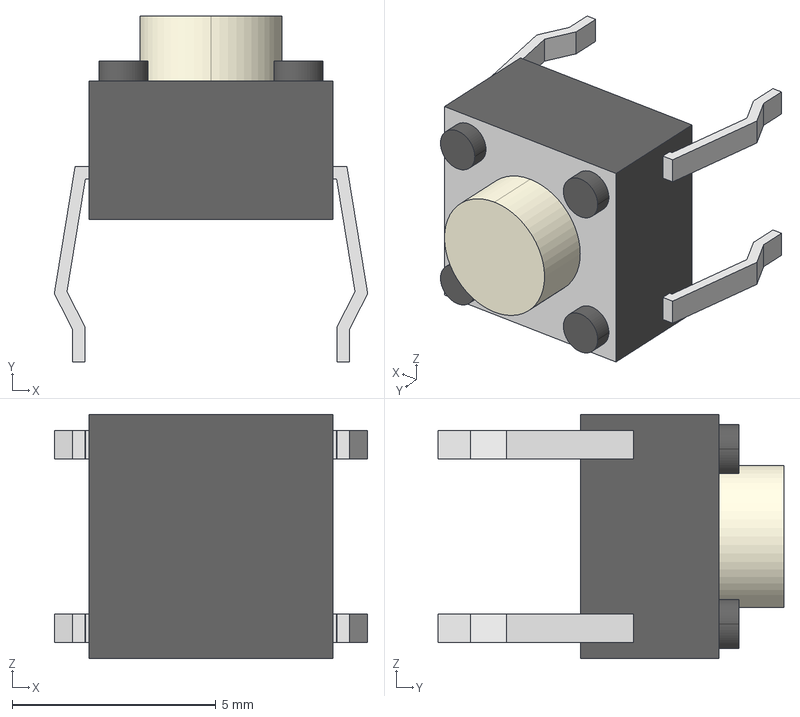
[picture p215: CAD file, 2021-11-13]
curso altium/Trabajo Final/3D Models/others/SWITCH TACTILE SPST-NO 0.05A 24V.stp
7.70 x 8.50 x 6.00 mm
