eloy-cacca/Trabajo-final/curso altium/Trabajo Final/3D Models/Cap/Cap electro 10x16x5_0mm.step

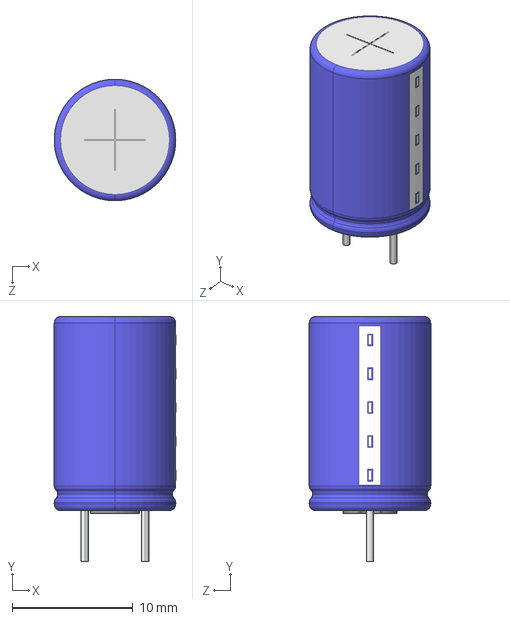
[picture p216: CAD file, 2021-11-13]
curso altium/Trabajo Final/3D Models/Cap/Cap electro 10x16x5_0mm.step
10.1 x 20.3 x 10.1 mm
