eloy-cacca/Trabajo-final/curso altium/Trabajo Final/3D Models/Diodo/diodo sot 23-3.stp

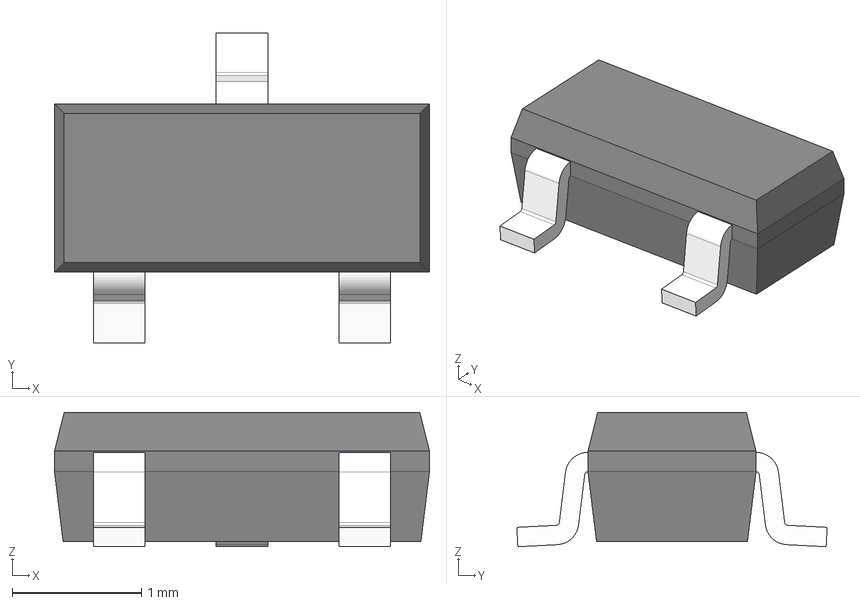
[picture p217: CAD file, 2021-11-13]
curso altium/Trabajo Final/3D Models/Diodo/diodo sot 23-3.stp
2.90 x 2.40 x 1.04 mm
