eloy-cacca/Trabajo-final/curso altium/Trabajo Final/3D Models/Cap/cap smd 6.3x7.7.step

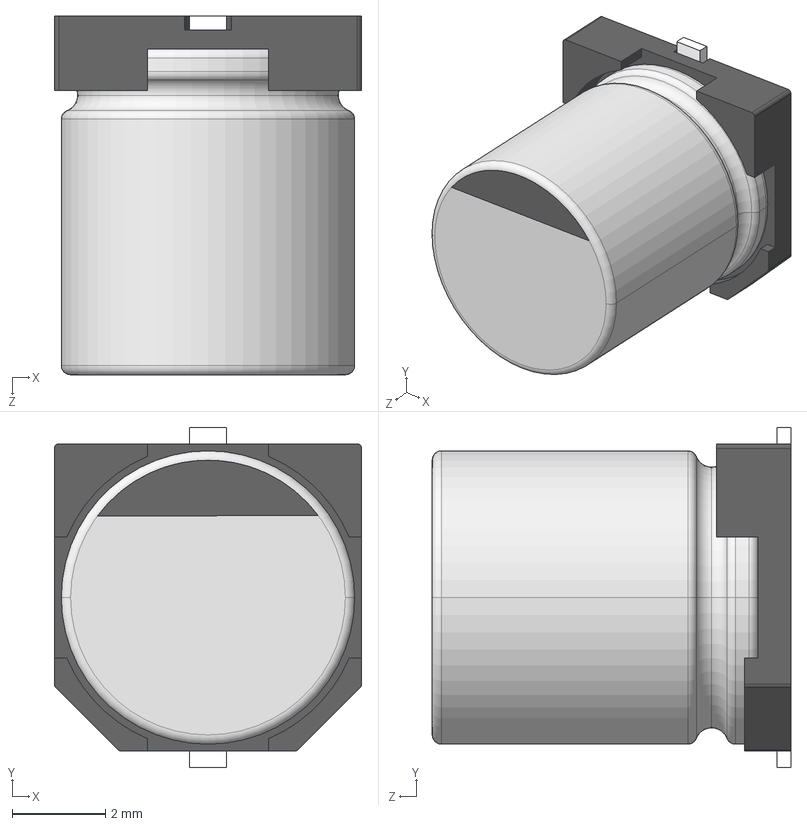
[picture p218: CAD file, 2021-11-13]
curso altium/Trabajo Final/3D Models/Cap/cap smd 6.3x7.7.step
6.60 x 7.30 x 7.70 mm
