eloy-cacca/Trabajo-final/curso altium/Trabajo Final/3D Models/Diodo/DO-214AB SMC.step

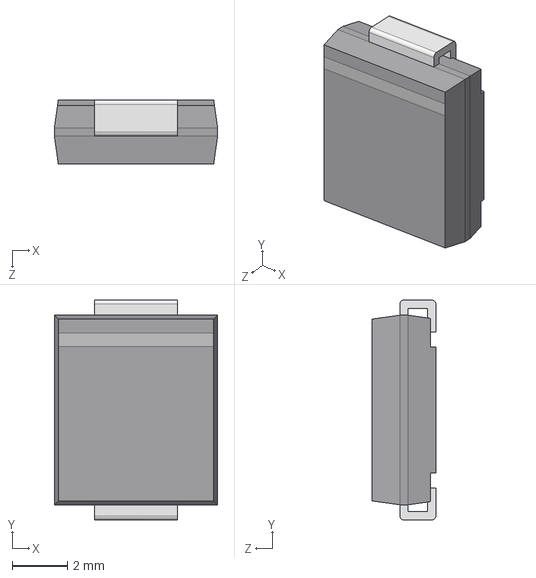
[picture p219: CAD file, 2021-11-13]
curso altium/Trabajo Final/3D Models/Diodo/DO-214AB SMC.step
5.90 x 7.95 x 2.30 mm
