eloy-cacca/Trabajo-final/curso altium/Trabajo Final/3D Models/Cap/cap smd 0805.stp

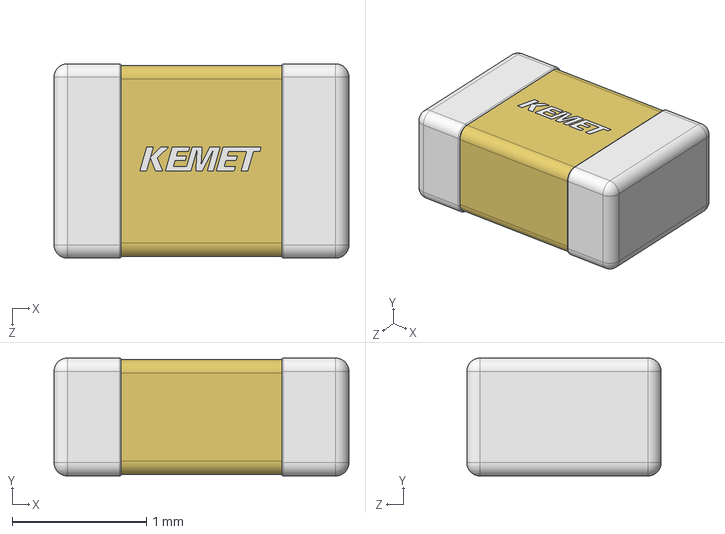
[picture p220: CAD file, 2021-11-13]
curso altium/Trabajo Final/3D Models/Cap/cap smd 0805.stp
2.20 x 0.88 x 1.45 mm
Base_26
Termination_26 x 2
