eloy-cacca/Trabajo-final/curso altium/Trabajo Final/3D Models/Cap/User Library-CE_R300_D650_H1000_16x25mm.step

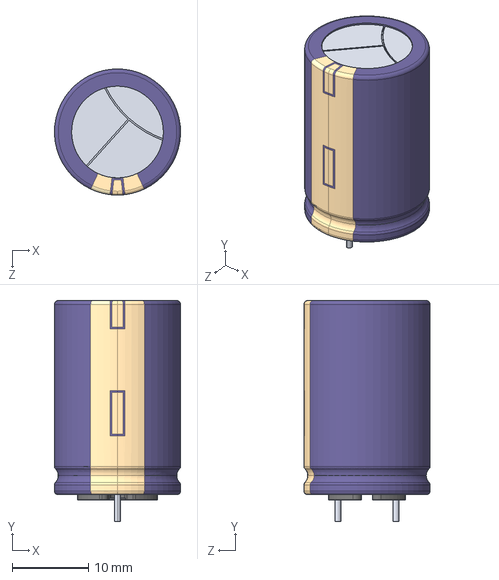
[picture p221: CAD file, 2021-11-13]
curso altium/Trabajo Final/3D Models/Cap/User Library-CE_R300_D650_H1000_16x25mm.step
16.5 x 28.9 x 16.5 mm
