eloy-cacca/Trabajo-final/curso altium/Trabajo Final/3D Models/Diodo/SMini2-F5-B.STEP

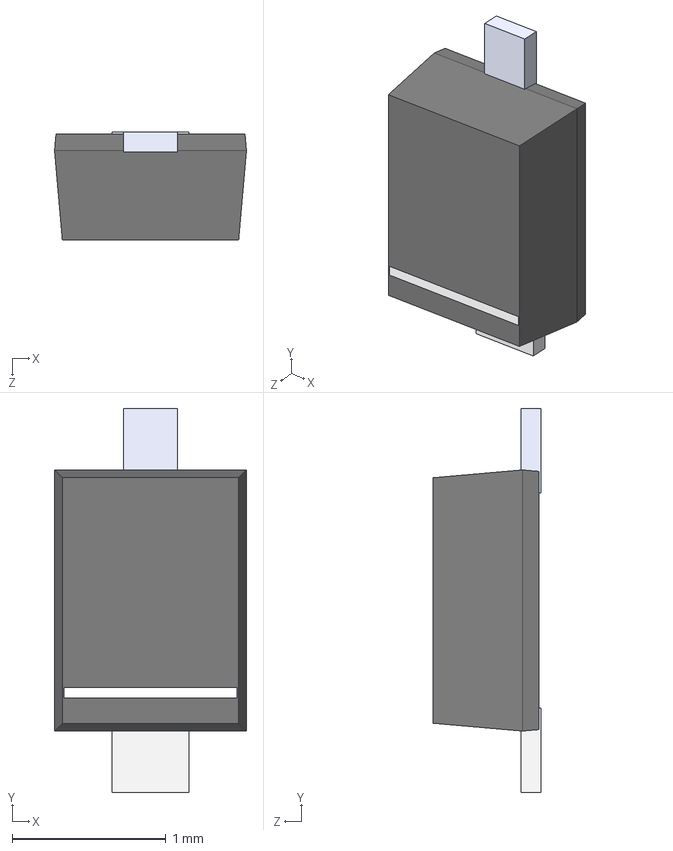
[picture p222: CAD file, 2021-11-13]
curso altium/Trabajo Final/3D Models/Diodo/SMini2-F5-B.STEP
1.25 x 2.50 x 0.7 mm
K
A
Diode
Marker
