eloy-cacca/Trabajo-final/curso altium/Trabajo Final/3D Models/Cap/cap 30x45.stp

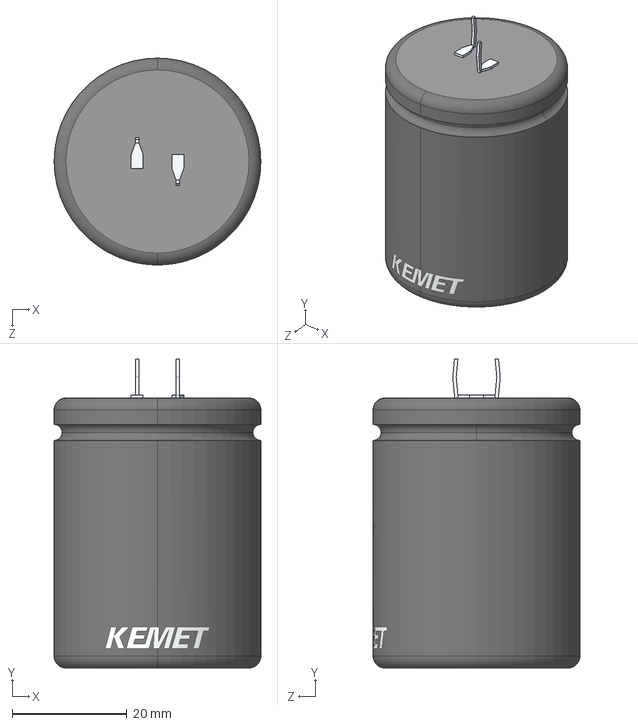
[picture p223: CAD file, 2021-11-13]
curso altium/Trabajo Final/3D Models/Cap/cap 30x45.stp
36.0 x 53.8 x 36.0 mm
