eloy-cacca/Trabajo-final/curso altium/Trabajo Final/3D Models/Cap/cap FILM_BLUE_P2750L3150W2200H3650PD90_22x31.5x.step

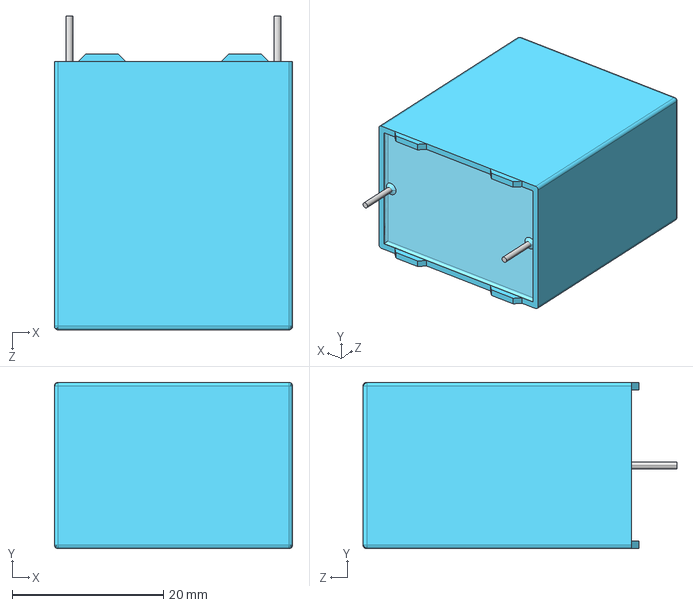
[picture p224: CAD file, 2021-11-13]
curso altium/Trabajo Final/3D Models/Cap/cap FILM_BLUE_P2750L3150W2200H3650PD90_22x31.5x.step
31.5 x 22.0 x 41.5 mm
