eloy-cacca/Trabajo-final/curso altium/Trabajo Final/3D Models/Diodo/REDLED 5mm.step

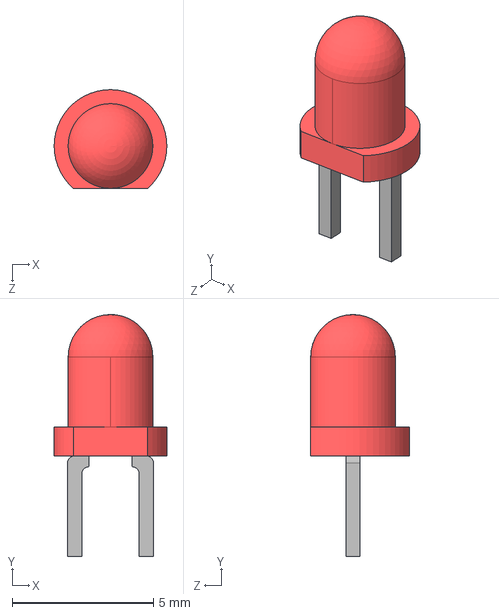
[picture p225: CAD file, 2021-11-13]
curso altium/Trabajo Final/3D Models/Diodo/REDLED 5mm.step
3.99 x 8.56 x 3.49 mm
