eloy-cacca/Trabajo-final/(list of files, cad)

Other CAD files:
curso altium/PCB_Project_1/3d models/CR2012-0805.step
curso altium/PCB_Project_1/3d models/SMD LED 0603.step
curso altium/Trabajo Final/3D Models/Diodo/0805LED-red.step
curso altium/Trabajo Final/3D Models/Diodo/0805LED-GREEN.step
curso altium/Trabajo Final/3D Models/Diodo/led0603_RED-1.STEP
curso altium/PCB_Project/3D models/022232021.stp
curso altium/PCB_Project_1/3d models/022292021.stp
