eloy-cacca/Trabajo-final/trabajo final/tesis aon/tesis/docs/pruebas/Aon_Plan-de-pruebas_v2.xlsx

Sheet: Plan de Prueba
Universidad Nacional de Mar del Plata
Facultad de Ingeniería
Carrera: Ingeniería Electrónica
Proyecto: Calibrador y caracterizador de sondas de corriente
PLAN DE PRUEBAS
Alcance | Verificaciones unitarias y dispositivo completo. Validación de requerimientos.
Ambientes de prueba | No se requieren ambientes de prueba especiales
Recursos, herramientas e instrumentos | Osciloscopio, multímetro, fuente de tensión de 24V, analizador lógico, programador JTAG/SWD, PC, sonda patrón
Políticas de trabajo | Las pruebas que involucren la etapa de generación de corriente deberán ser realizadas bajo la supervisión del director del proyecto. Los resultados de todas las pruebas deberán ir siendo comunicadas al director a medida que se vayan realizando.
Estrategia de Comunicación | Informes parciales al director. Informe final a la junta evaluadora.

Sheet: Casos de Prueba
Módulo | ID | Prueba | Tipo de Prueba | Procedimiento | Instrumental | Resultado Esperado | Fecha de Prueba | Iteración | Resultado Obtenido | Iteración | Resultado obtenido | Observaciones
Fuentes de alimentación | 1 | Verificación de las diferentes fuentes de alimentación del instrumento | Unitaria | 1- Soldado y medición fuente de 12V 2- Soldado y medición fuente de 5V 3- Soldado y medición fuente de 3.3V 4- Soldado y medición fuente de -5V 5- Soldado y medición fuentes de referencia En cada paso se verificará la correcta tensión y corrientes medidas por el multímetro | Multímetro | Tensiones nominales deseadas y corrientes acordes al consumo en standby de acuerdo al fabricante | 2021-05-01 | 1 | Se registró un correcto funcionamiento | - | - | -
Microcontrolador | 2 | Verificación conexión JTAG/SWD | Unitaria | Verificar correcto funcionamiento del puerto JTAG/SWD subiendo el programa al dispositivo y observando LEDs | Programador JTAG/SWD | LEDs titilan 3 veces al iniciar el microcontrolador | 2021-05-01 | 1 | Se registró un correcto funcionamiento | - | - | -
Generación y adquisición de corriente | 3 | Verificación PWM | Unitaria | Sin la parte de potencia conectada (sin L4) verificar que la señal PWM sea la deseada, forzando distintos duty cycles. | Osciloscopio o analizador lógico | Se miden correctamente los duty cycles esperados | 2021-08-24 | 1 | Se verificó que las salidas de PWM funcionaban correctamente. | - | - | -
 | 4 | Verificación drivers | Unitaria | Sin la parte de potencia conectada (sin L4) verificar que las salidas de potencia de los drivers sean las adecuadas. | Osciloscopio | Se miden correctamente las señales de acuerdo a lo esperado en el datasheet y a la entrada de PWM | 2021-08-26 | 1 | La salida de los drivers presentan un alto transitorio. Se verifica que se había montado incorrectamente las resistencias de gate de los MOSFET. | 2 | Se cambió las resistencias incorrectas y se verificó un correcto funcionamiento. | -
 | 5 | Verificación etapa de potencia con puente H a ramas separadas | Unitaria | Sin cerrar el lazo y utilizando las ramas del puente H de maneras separadas, verificar el correcto funcionamiento de los transistores. | Osciloscopio | Los transistores disparan correctamente, en línea con la señal proveniente del driver y del PWM |  |  |  | - | - | -
 | 6 | Verificación etapa de potencia a lazo abierto | Unitaria | Sin cerrar el lazo, verificar con una carga resistiva y poca corriente el funcionamiento correcto de la etapa de potencia | Osciloscopio | Se mide las tensiones y corrientes esperadas. Se verifica el funcionamiento del dead time y el correcto disparo de los transistores |  |  |  | - | - | -
 | 7 | Verificación etapa de potencia a lazo abierto - corriente máxima | Unitaria | Repetir test 6, pero obteniendo ahora la corriente máxima requerida, 10 Arms | Osciloscopio | Se mide 10 Arms |  |  |  | - | - | -
 | 8 | Verificación protección por sobrecorriente | Unitaria | Introduciendo una tensión mayor al límite superior de la protección por sobrecorriente, verificar que la salida de la protección se active | Osciloscopio, generador de tensión | Se activa la protección |  |  |  | - | - | -
 | 9 | Verificación protección ADC | Unitaria | Introduciendo tensiones mayores a 3.3V, verificar que la protección no permita que esas tensiones lleguen al ADC | Multímetro | Las tensión en el ADC se mantiene menor o igual a 3.3V |  |  |  | - | - | -
 | 10 | Verificación correcto muestreo | Unitaria | Muestrear el ADC de manera manual sobre el microcontrolador, verificando que los valores leídos sean iguales a las tensiones de entrada de prueba | Multímetro | Los valores leídos corresponden a las tensiones de prueba | 2021-05-01 | 1 | Se registró un correcto funcionamiento | - | -
 | 11 | Verificación interrupción generada al indicar protección por sobrecorriente | Unitaria | Simulando una entrada en alto del pin de protección por sobrecorriente, verificar que se dispare la interrupción, cortando las salidas de los PWM | Oscilsocopio, generador de tensión | Se dispara la interrupción, cortando las salidas de los PWM |  |  |  | - | - | -
 | 12 | Verificar correcto funcionamiento sistema de índices y tendencias | Unitaria | Simulando una lectura de señales en el ADC, verificar que el sistema de procesamiento obtenga los parámetros esperados | PC | Los parámetros coinciden con los de las señales simuladas |  |  |  | - | -
 | 13 | Verificación etapa de potencia a lazo cerrado | Integración | Verificar a lazo cerrado el correcto funcionamiento del sistema. Probar los siguientes controladores: 1- Controlador P de muy baja ganancia 2- Controlador PI 3- Controlador final RC | Osciloscopio | Se logra controlar efectivamente la corriente generada |  |  |  | - | - | -
Sistema de control gráfico y gestión de ensayos | 14 | Verificación conexión USB | Integración | Verificar utilizando el software en la PC la correcta conexión con el dispositivo | PC | El dispositivo debería aparecer conectado en la PC y en el software debería poder responder ecos | 2021-05-01 | 1 | Se registró un correcto funcionamiento | - | - | -
 | 15 | Verificar correcta generación de reportes | Integración | Simulando una lectura de señales en el ADC, verificar que el sistema de reportes funcione correctamente | PC | El sistema reporta los datos medidos de manera correcta | 2021-05-01 | 1 | Se registró un correcto funcionamiento | - | - | -
Dispositivo completo | 16 | Verificar funcionamiento completo del sistema | Homologación | Utilizando una sonda patrón, verificar que el reporte obtenido en el software se condiga con lo indicado por el fabricante de la sonda | PC, sonda patrón | El reporte se condice con lo descrito por el software |  |  |  | - | - | -
