eloy-cacca/Trabajo-final/trabajo final/filtro antialiasing/diseños pdf/Sensado corriente.pdf

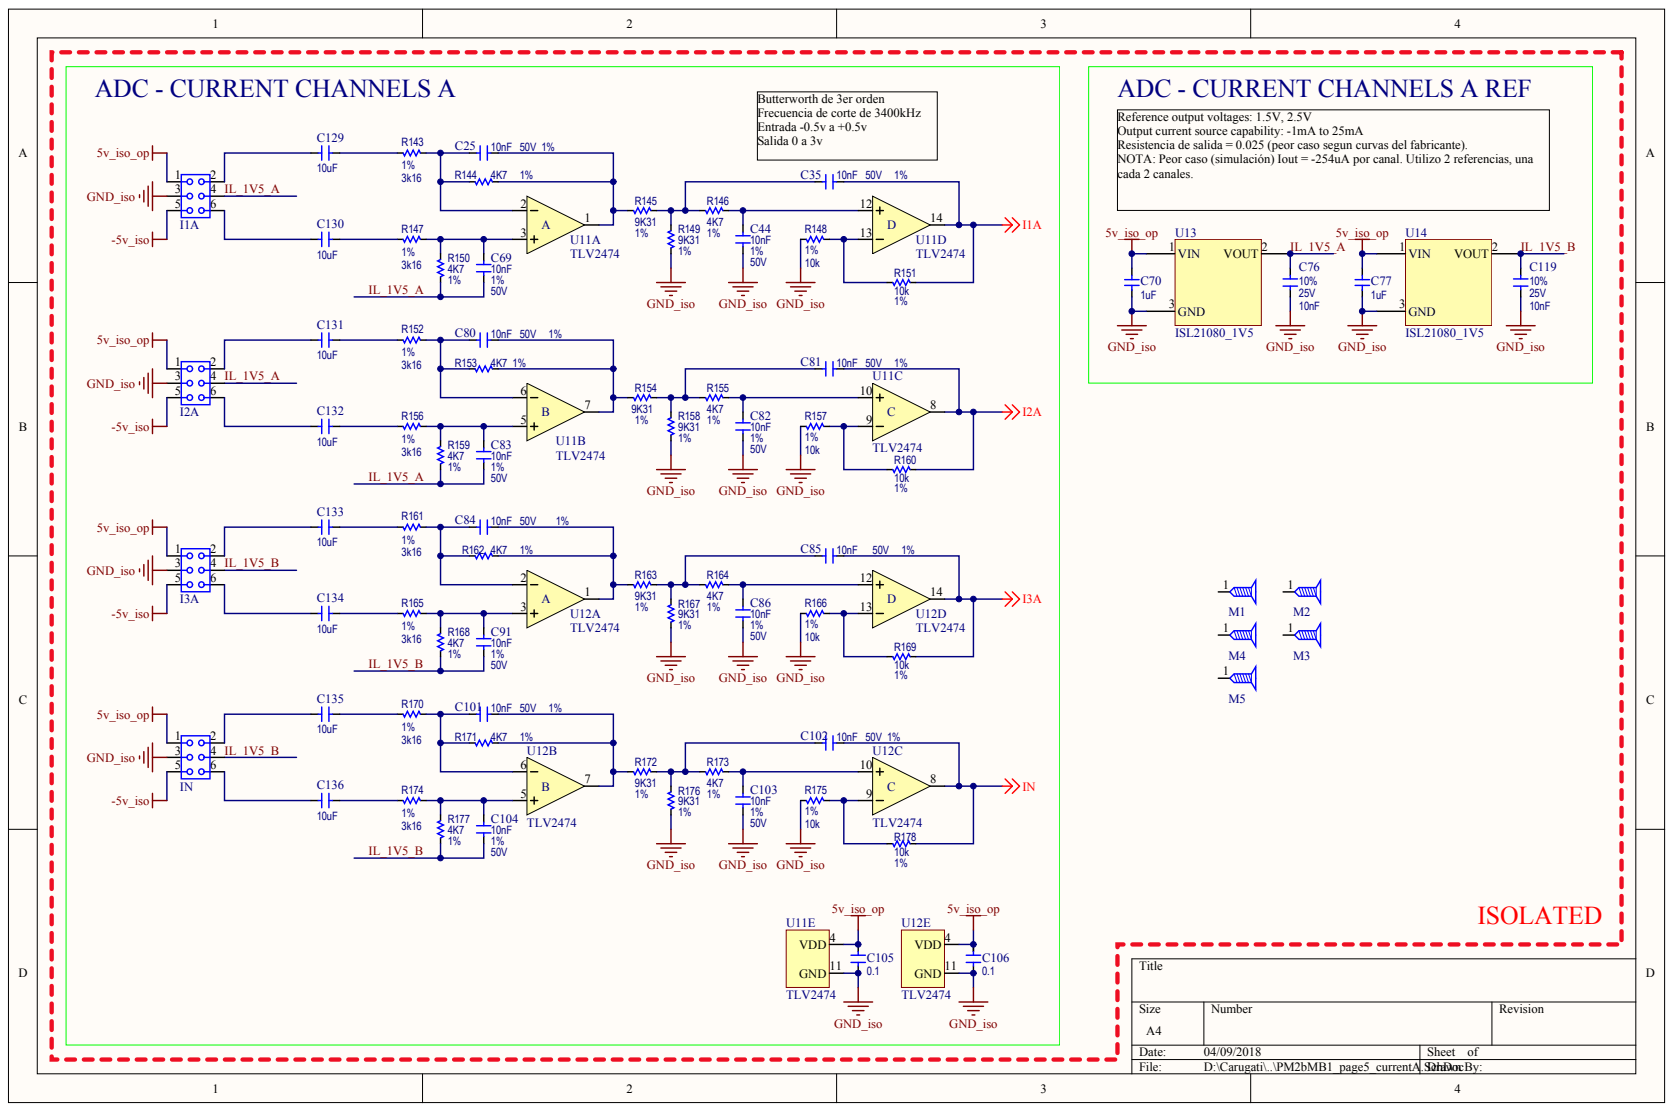
[picture p226: page 1]

ADC - CURRENT CHANNELS A REF

Butterworth de 3er orden
Frecuencia de corte de 3400kHz
Entrada -0.5v a +0.5v
Salida 0 a 3v

Reference output voltages: 1.5V, 2.5V
Output current source capability: -1mA to 25mA
Resistencia de salida = 0.025 (peor caso segun curvas del fabricante).
NOTA: Peor caso (simulación) Iout = -254uA por canal. Utilizo 2 referencias, una
cada 2 canales.
