eloy-cacca/Trabajo-final/trabajo final/filtro antialiasing/diseños pdf/Sensado tensión.pdf

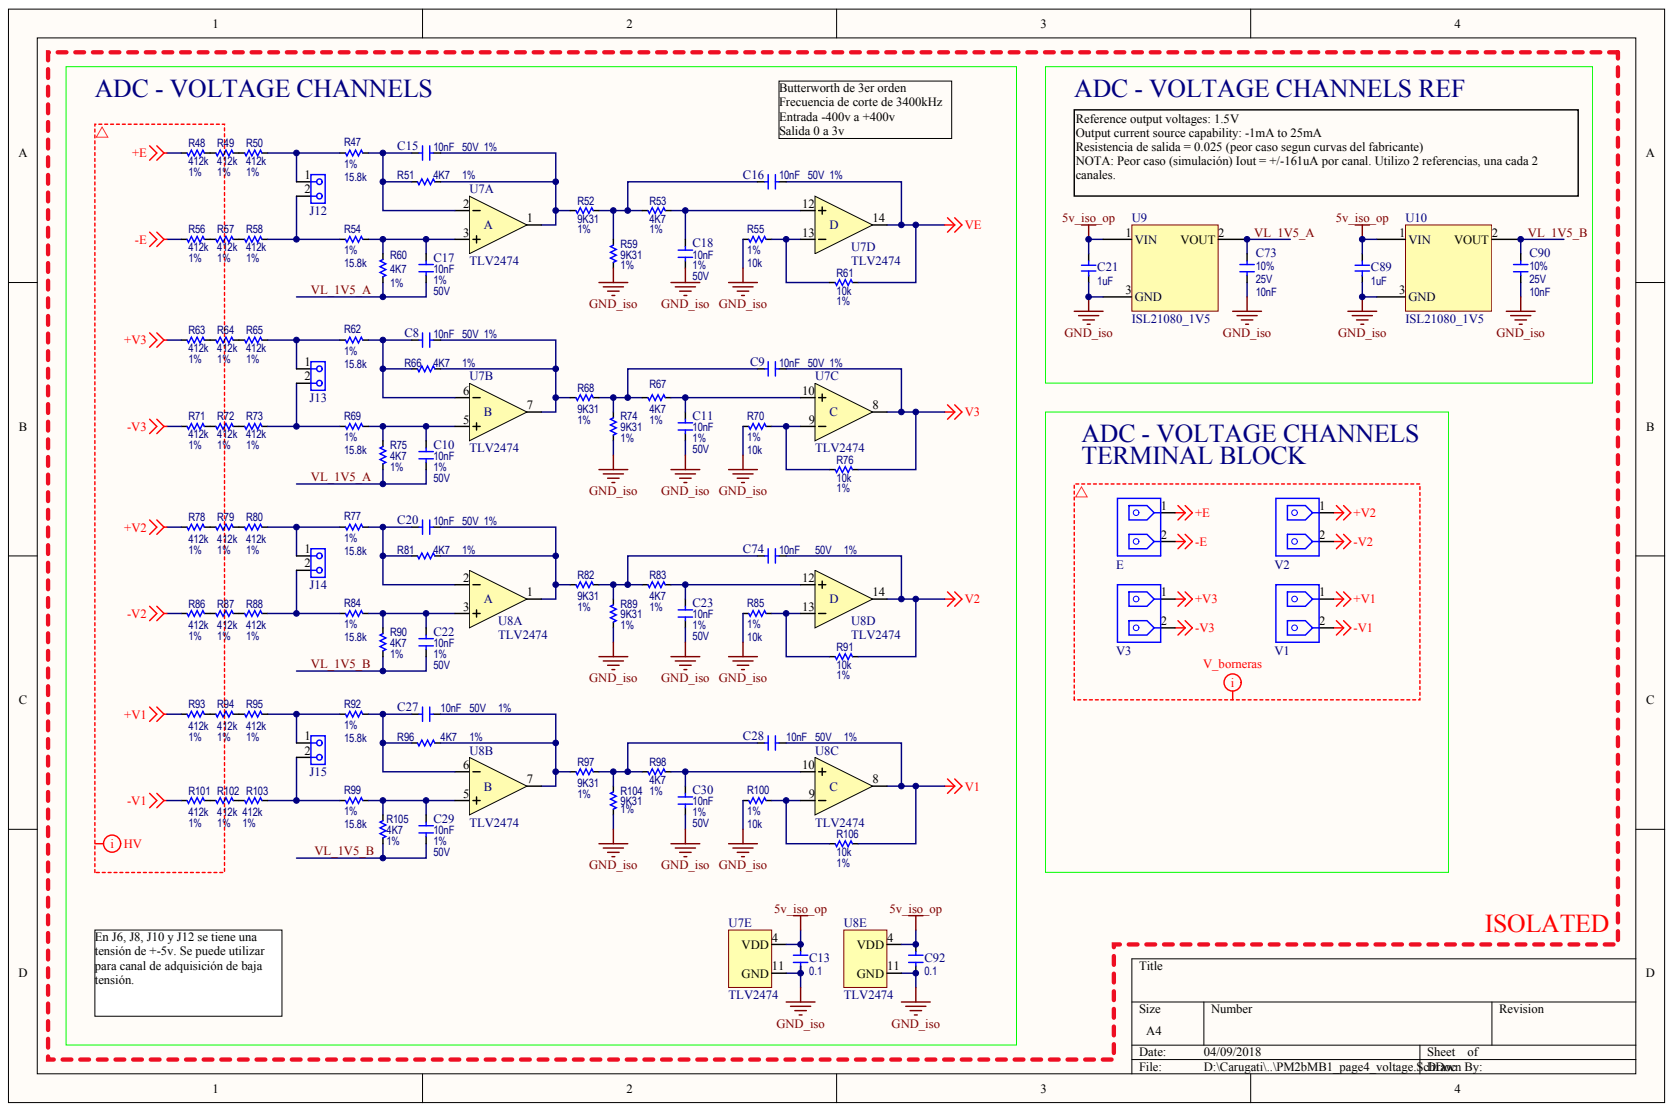
[picture p227: page 1]

ADC - VOLTAGE CHANNELS REF

Butterworth de 3er orden
Frecuencia de corte de 3400kHz
Entrada -400v a +400v

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

VL_1V5_B | 5v_iso_op

En J6, J8, J10 y J12 se tiene una
tensión de +-5v. Se puede utilizar
para canal de adquisición de baja
tensión.
