eloy-cacca/Trabajo-final/trabajo final/tesis aon/tesis/hardware/Output/esquematico.pdf

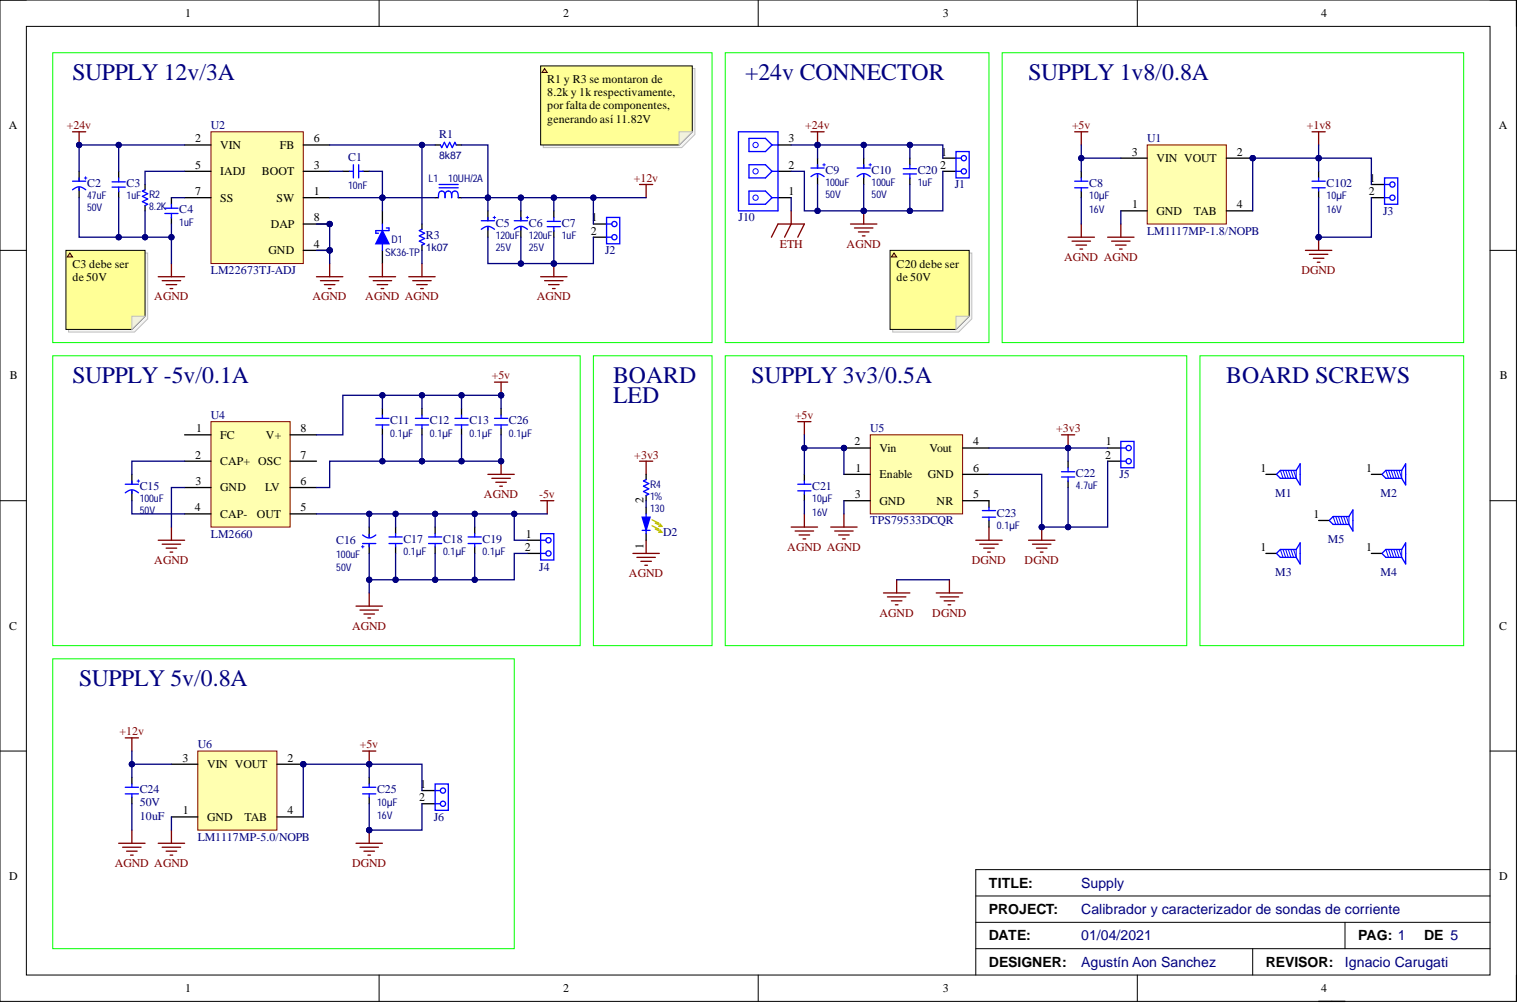
[picture p228: page 1]

R1 y R3 se montaron de
8.2k y 1k respectivamente,
por falta de componentes,
generando así 11.82V

Enable 1 | 2

GND 3

CAP- 4 | -5v 100uF

Calibrador y caracterizador de sondas de corriente

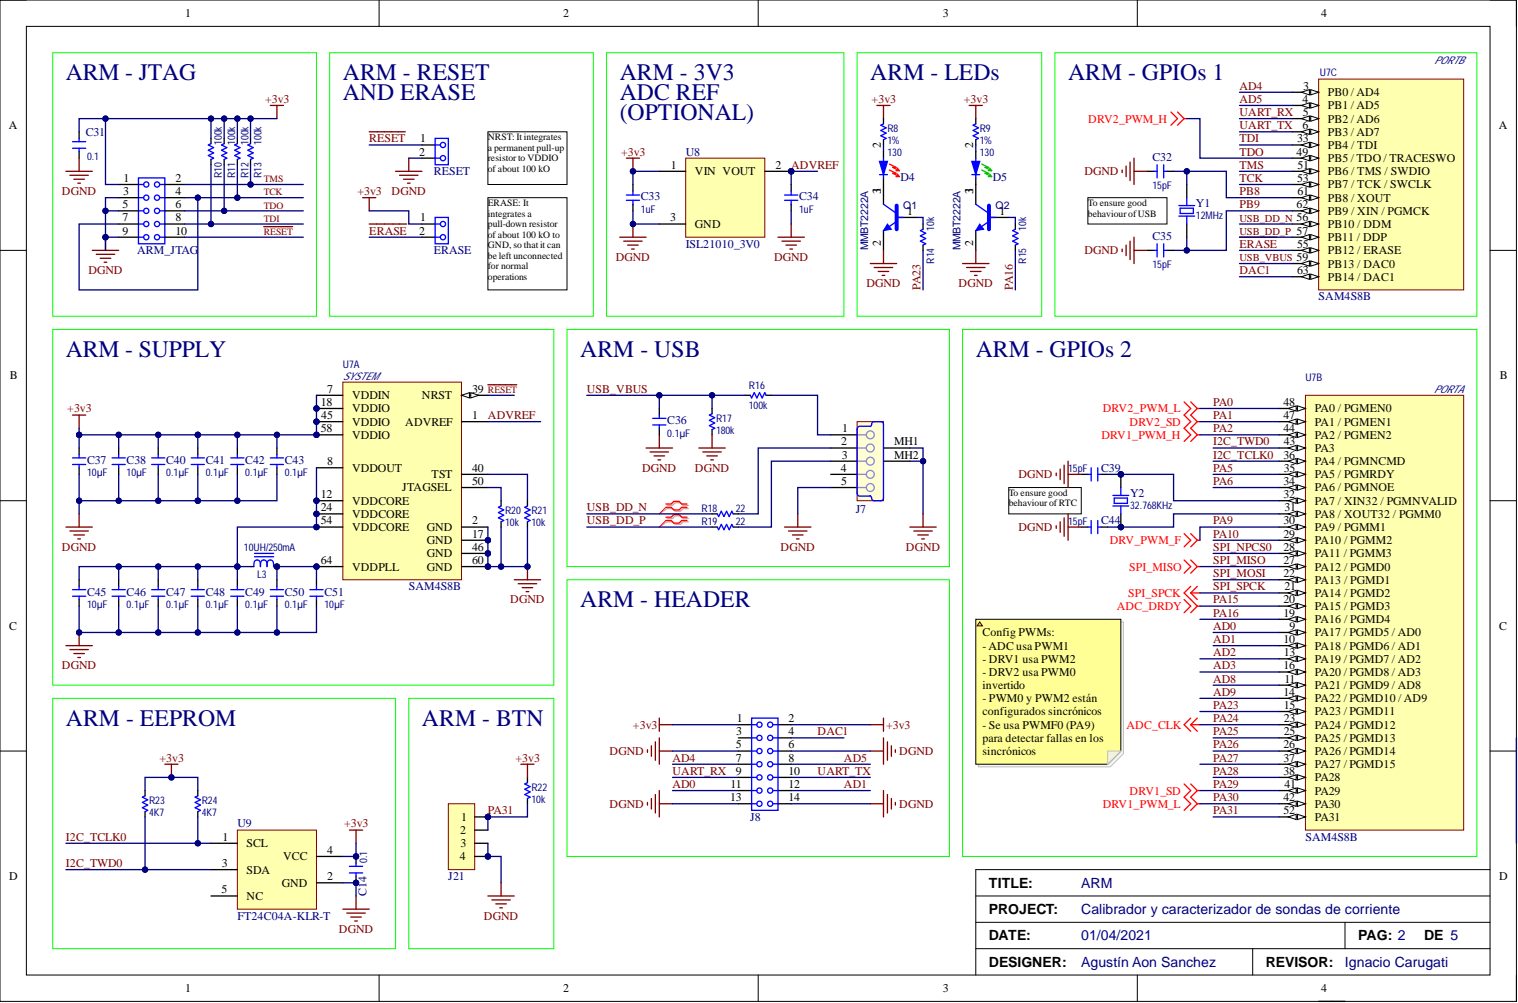
[picture p229: page 2]

ERASE: It
integrates a
pull-down resistor
of about 100 kO to
GND,so that it can
be left unconnected
for normal
operations

Calibrador y caracterizador de sondas de corriente

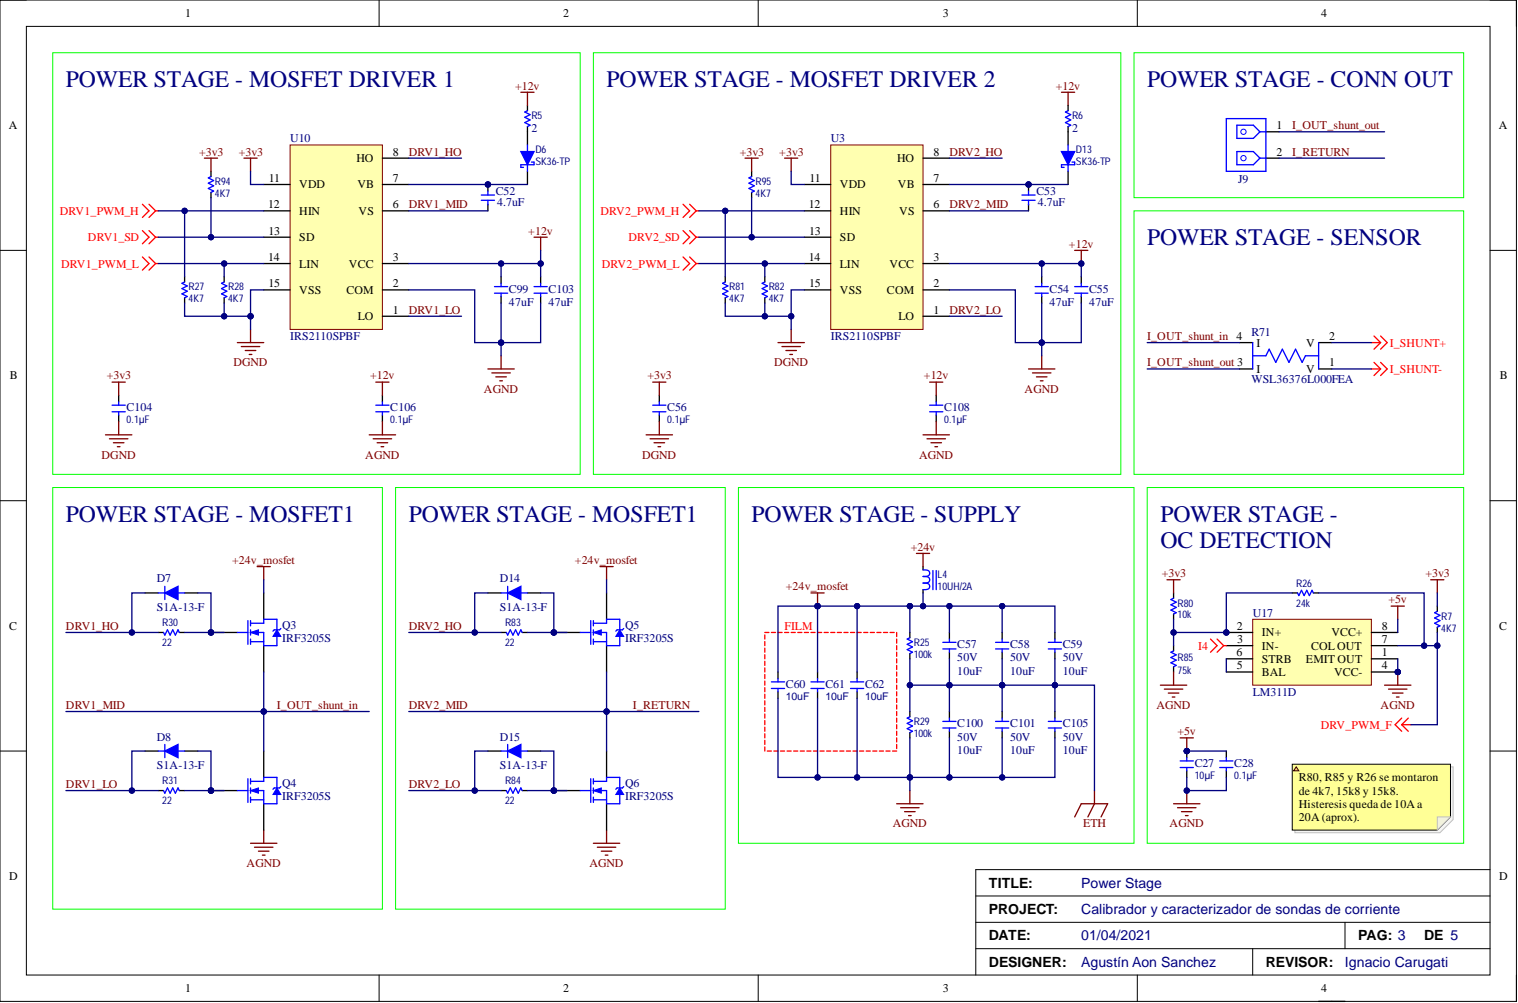
[picture p230: page 3]

POWER STAGE - MOSFET DRIVER 1

POWER STAGE - MOSFET DRIVER 2

POWER STAGE - CONN OUT

Calibrador y caracterizador de sondas de corriente

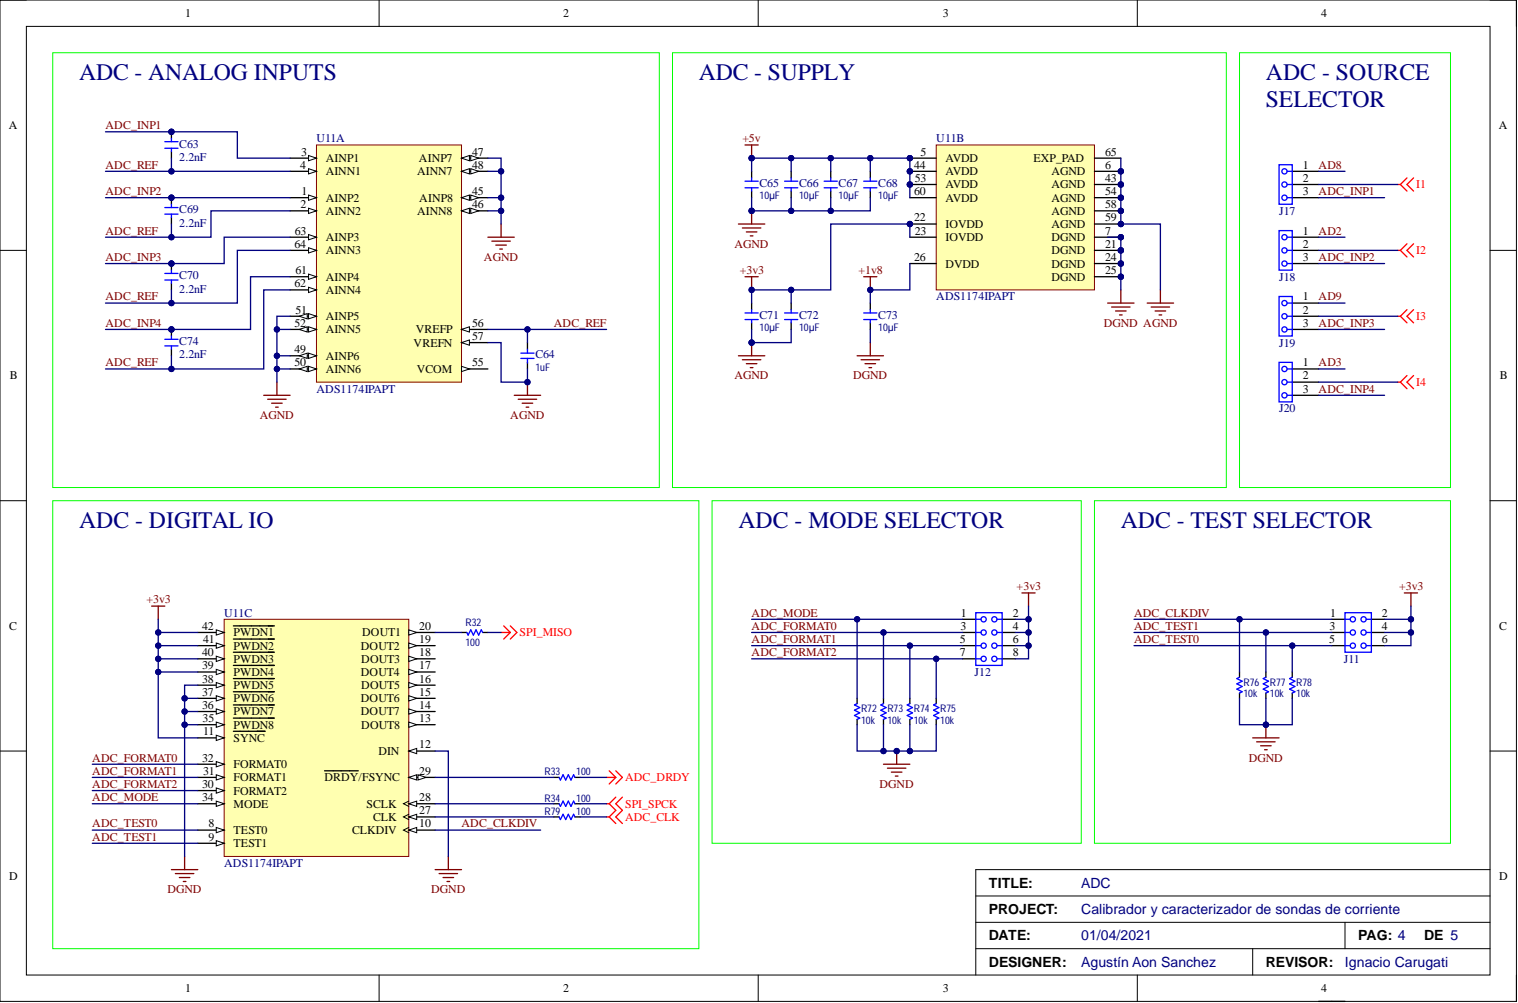
[picture p231: page 4]

3 8 | 1 6
3 7 | 1 5
3 6 | 1 4
3 5 | 1 3
1 1 | 1 2

Calibrador y caracterizador de sondas de cor

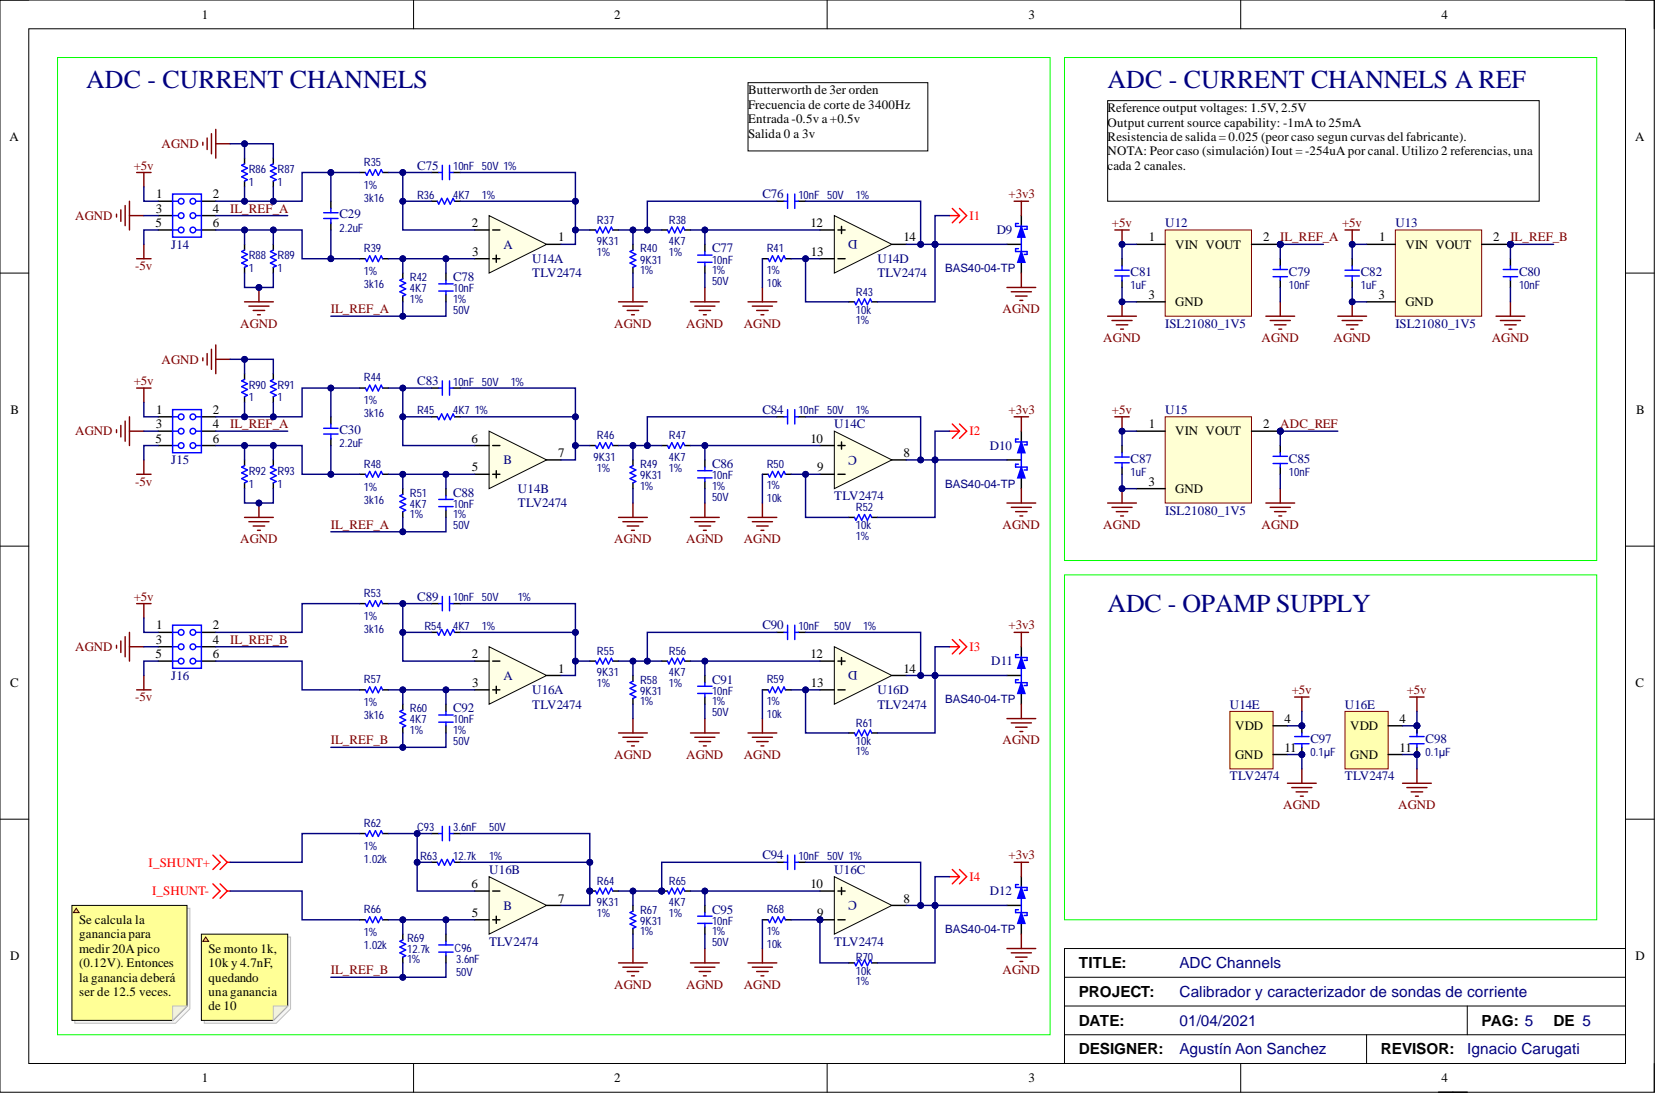
[picture p232: page 5]

Calibrador y caracterizador de sondas de cor
