eloy-cacca/Trabajo-final/Trabajo Final_revMF0106.PDF

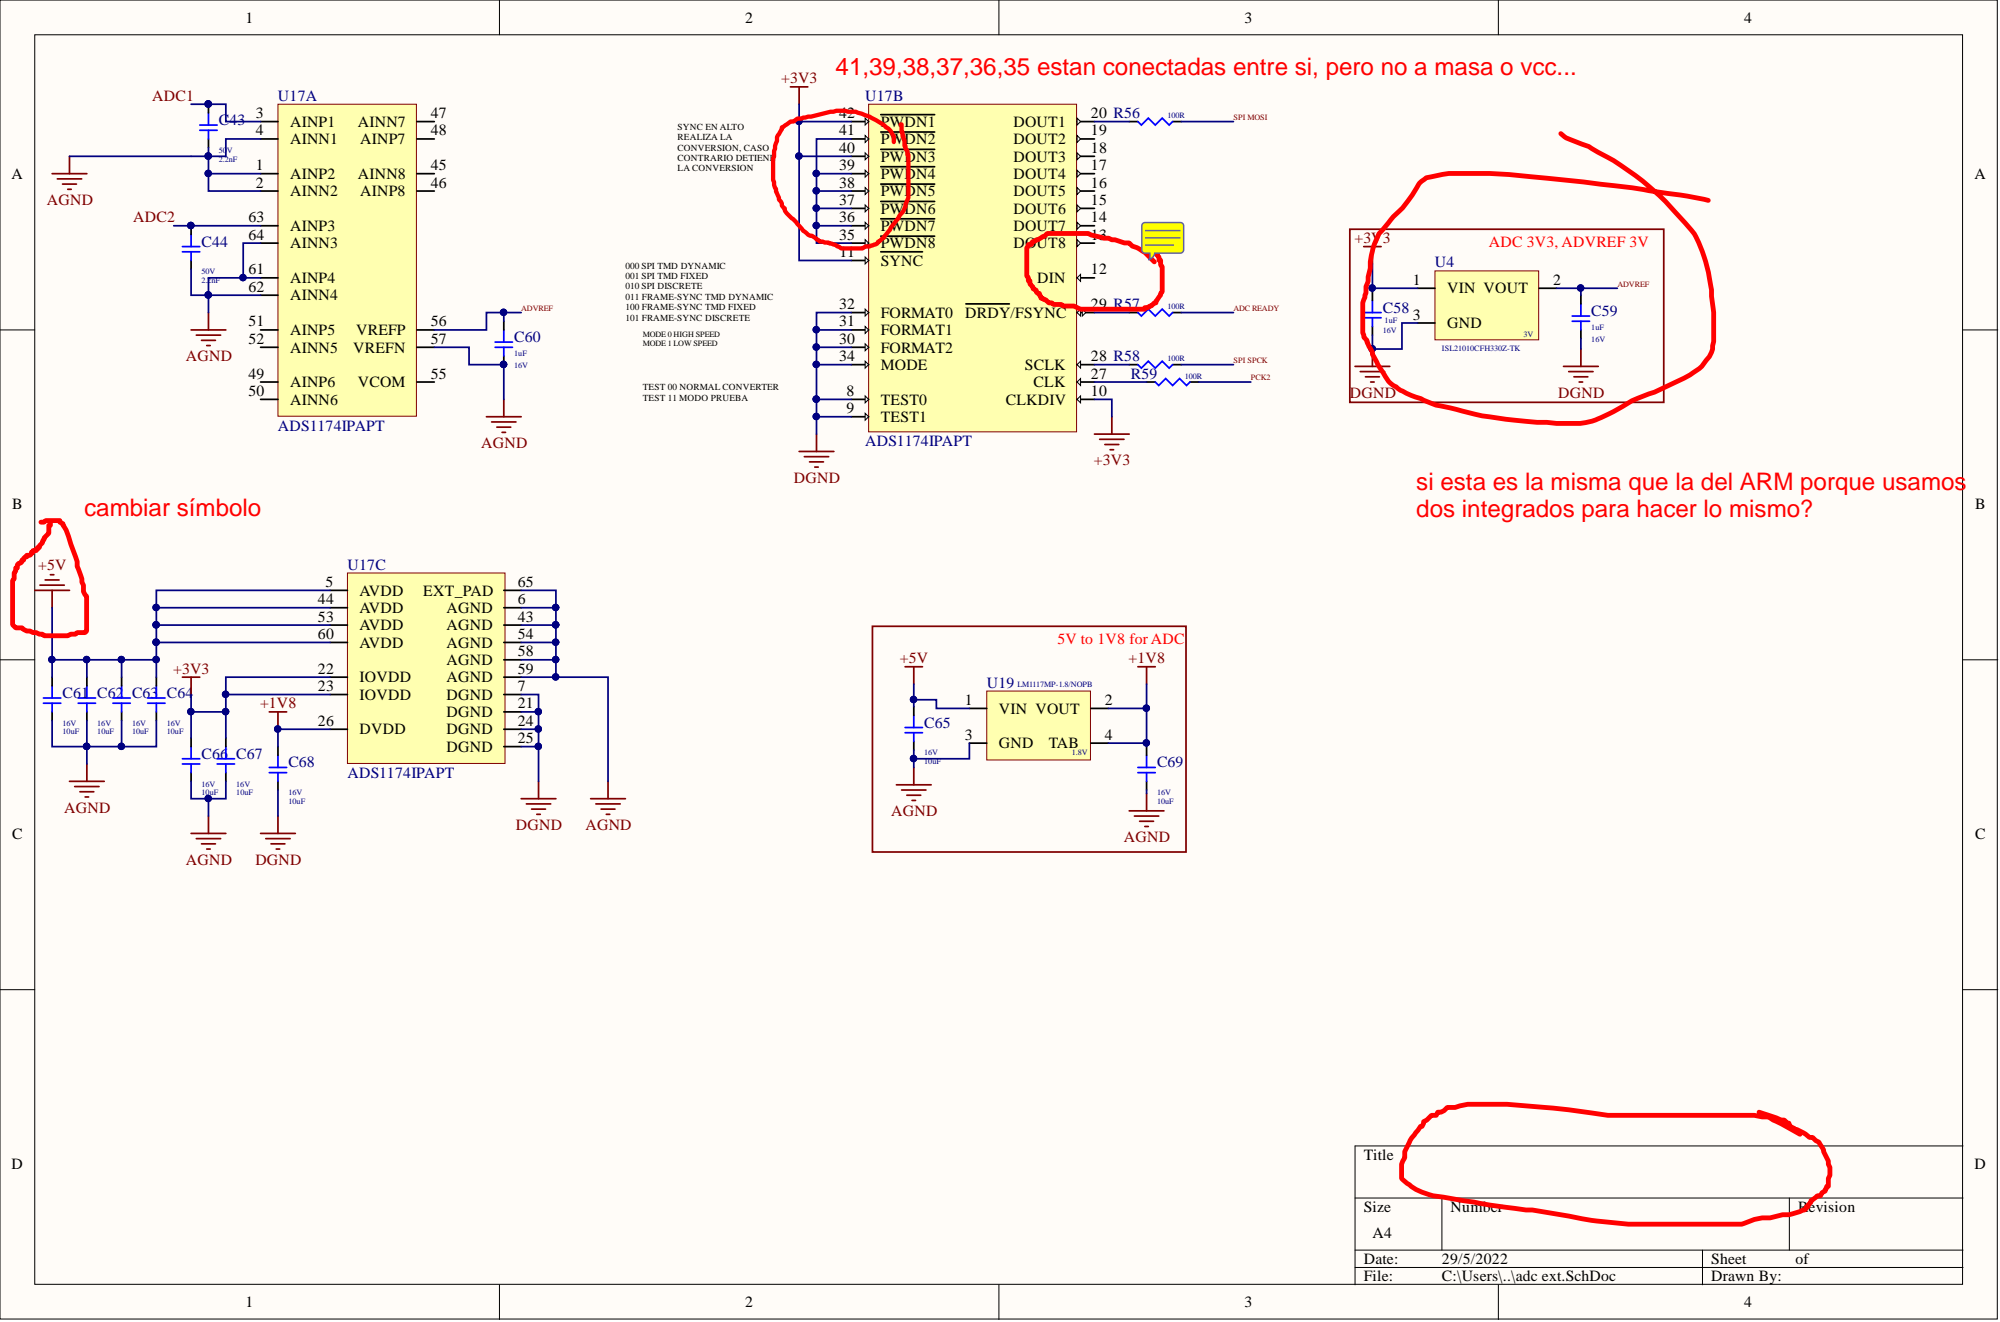
[picture p233: page 1]

4 4 | 6
5 3 | 4 3

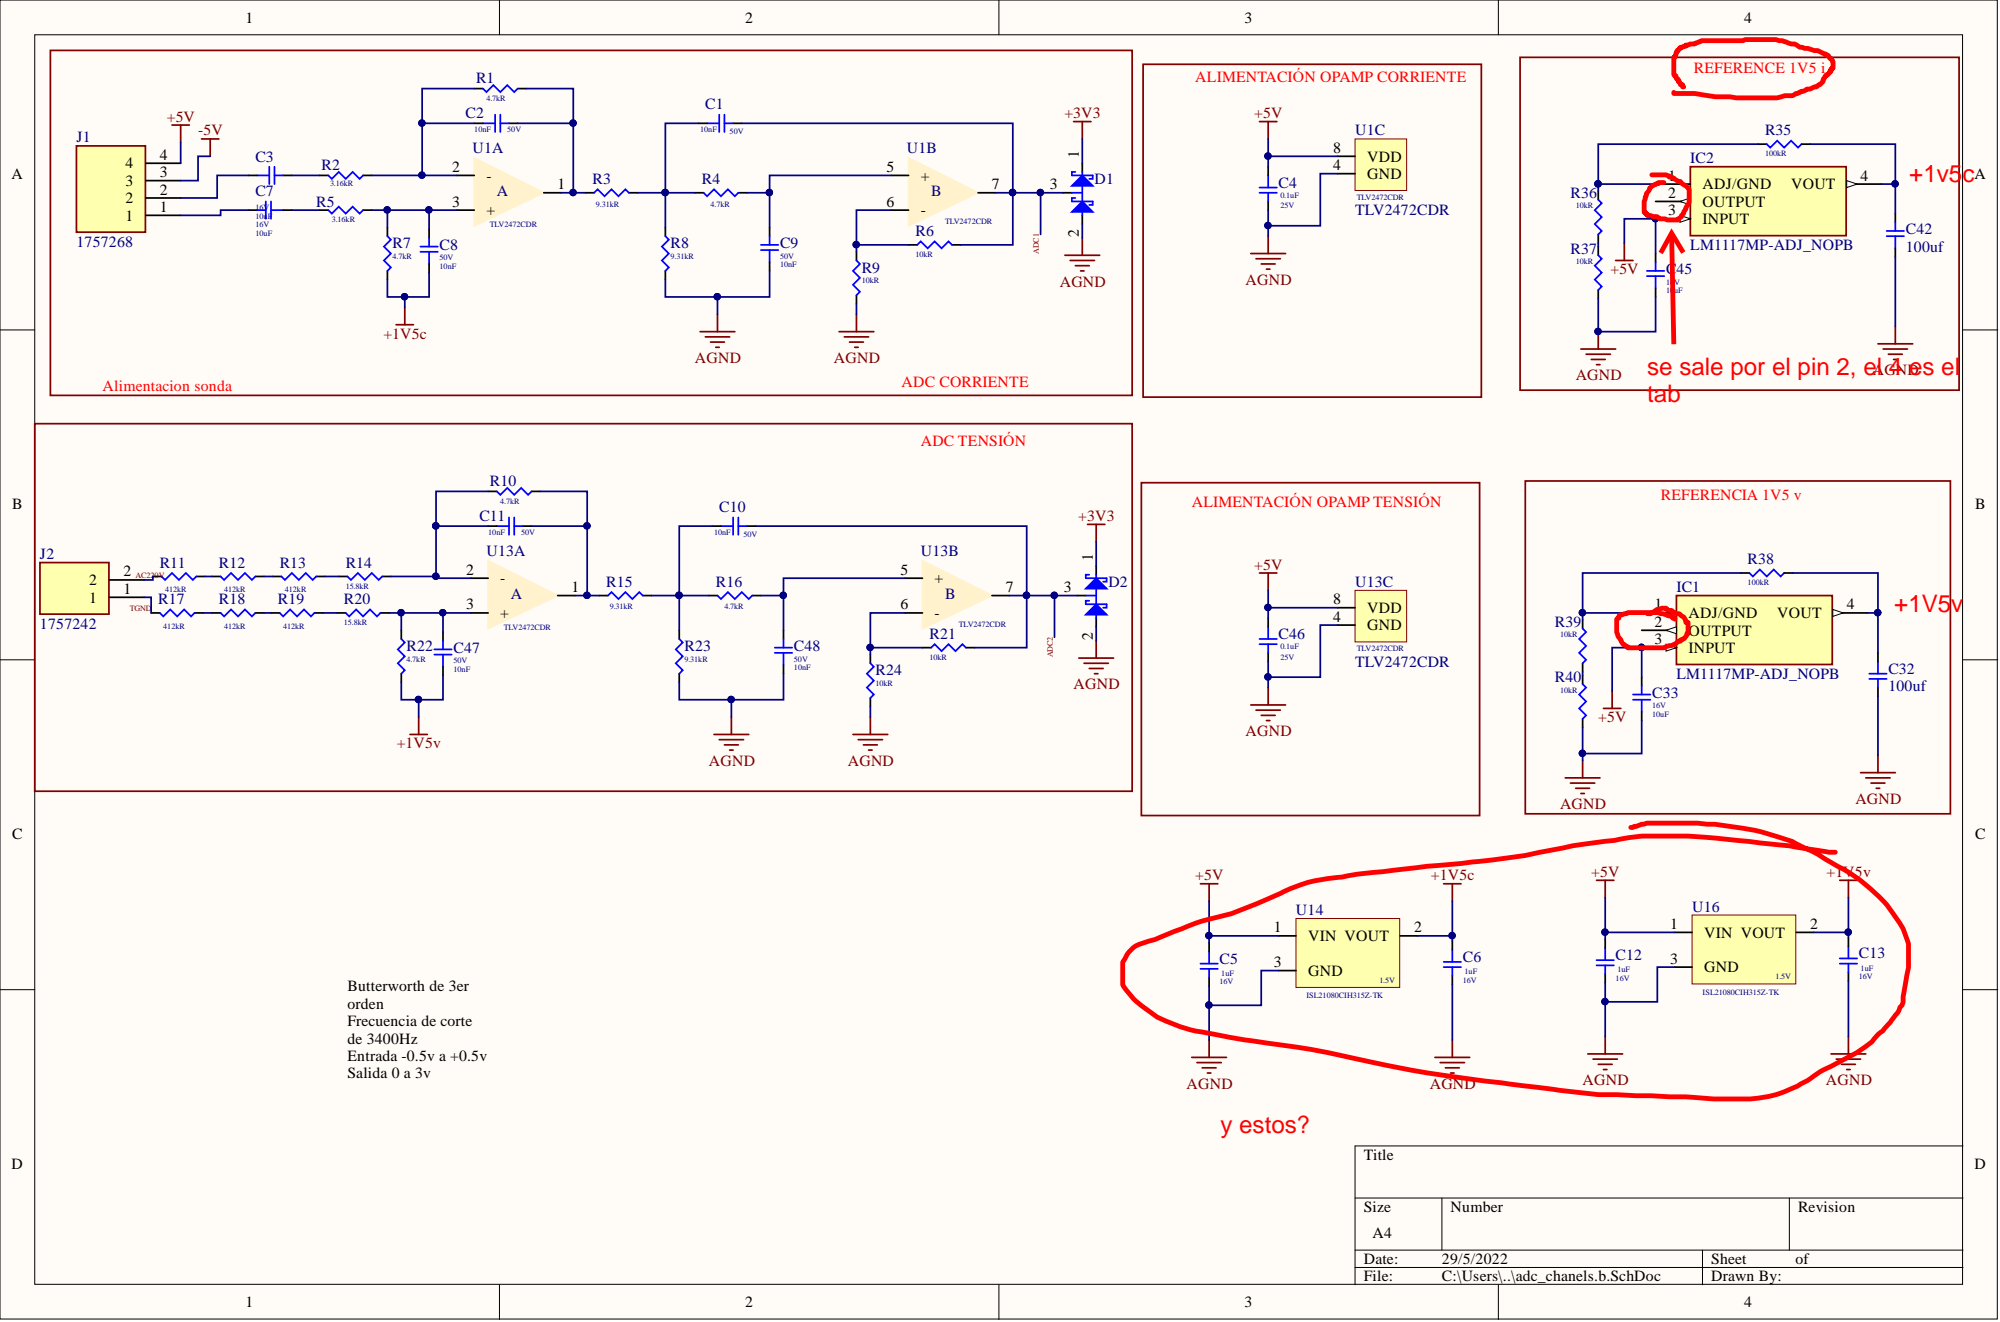
[picture p234: page 2]

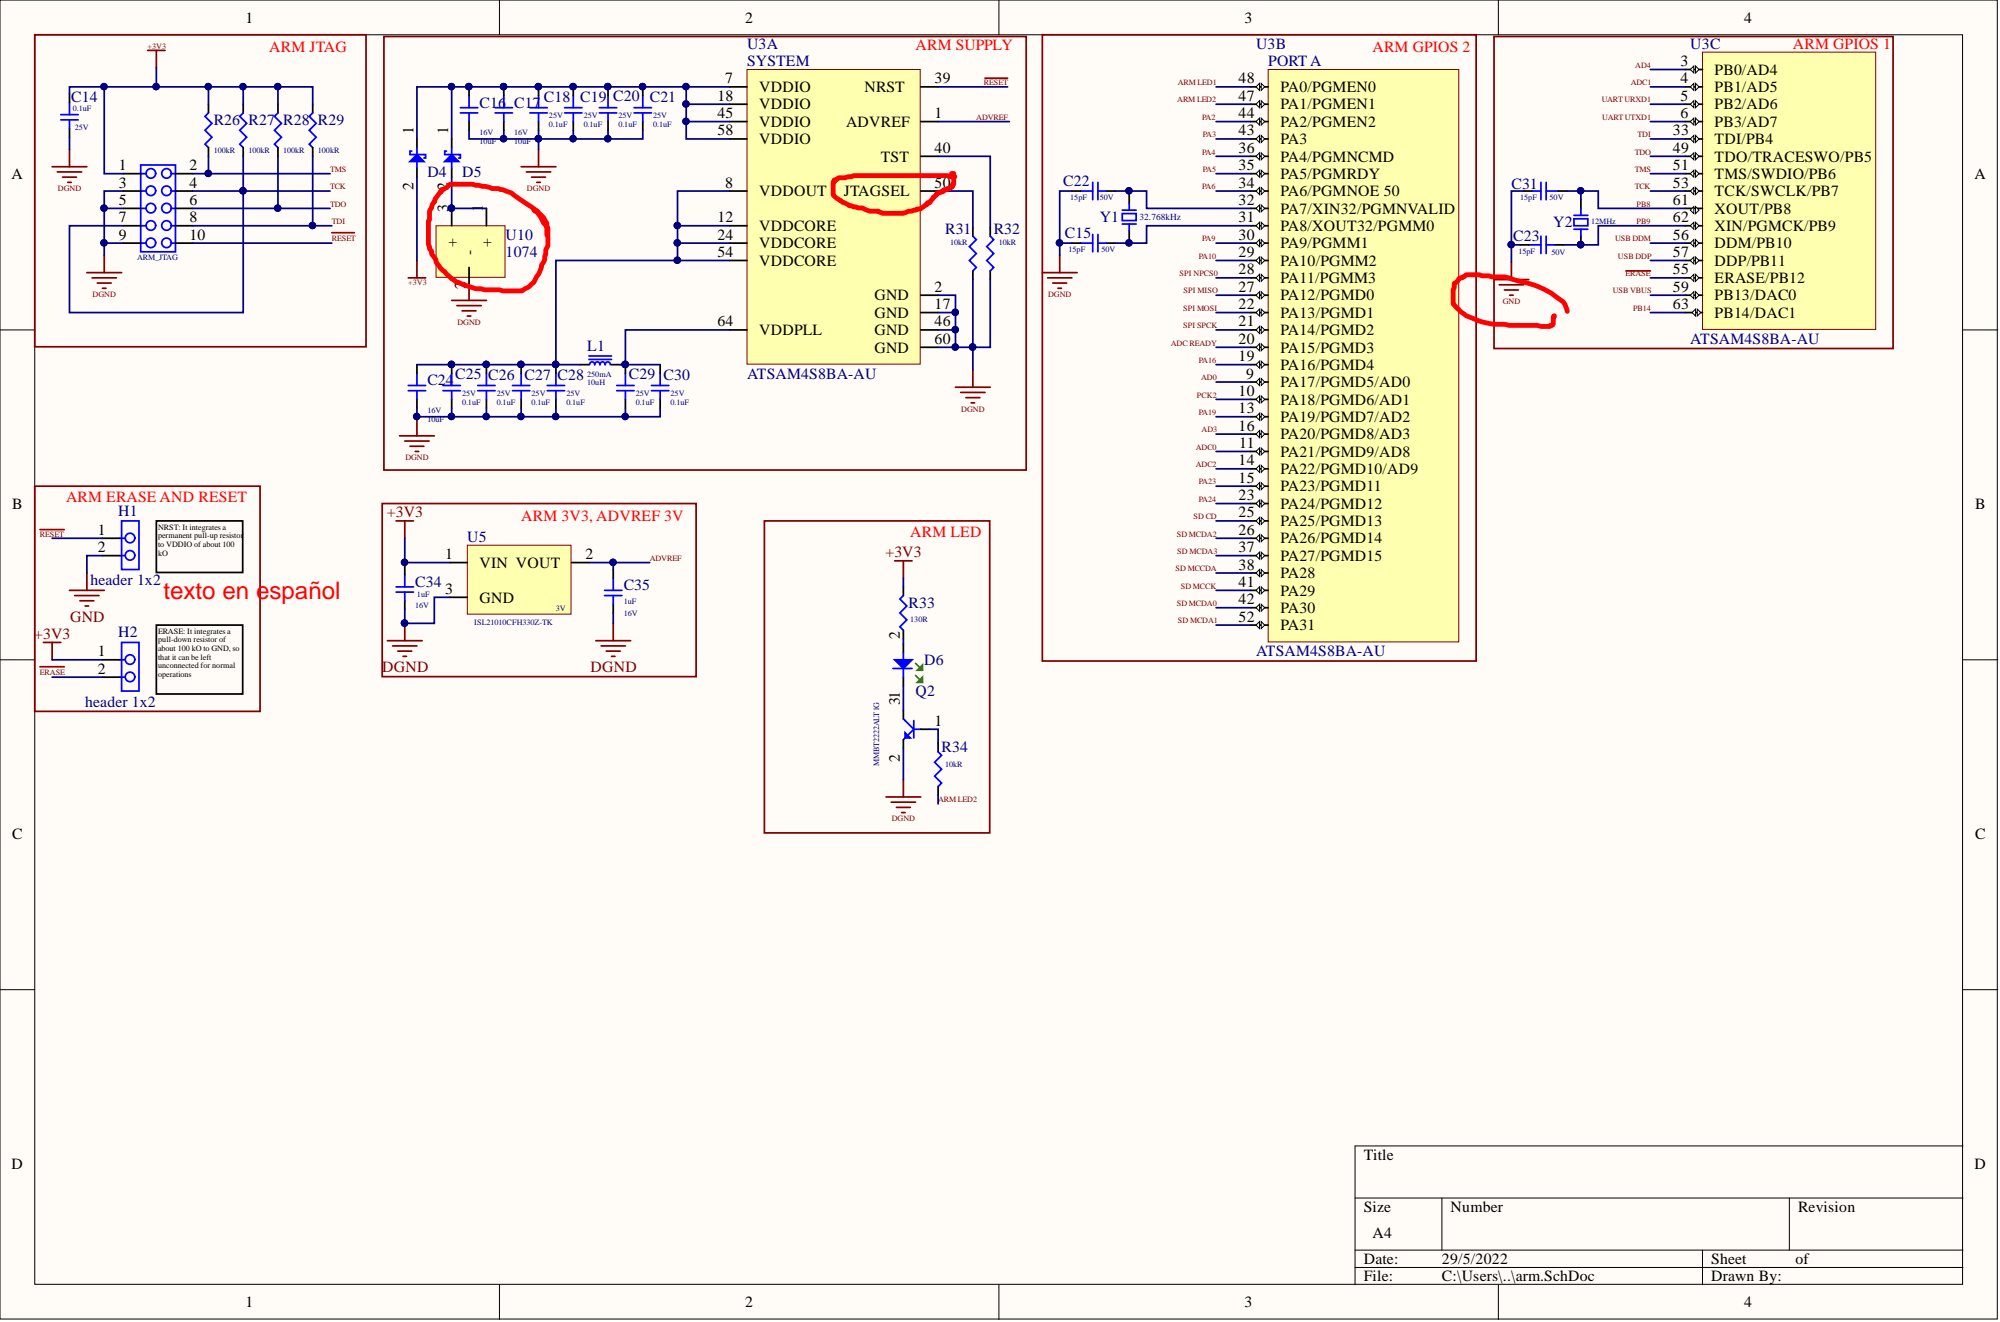
[picture p235: page 3]

UART UTXD1 TMS TCK TDO TDI

1 7
4 6

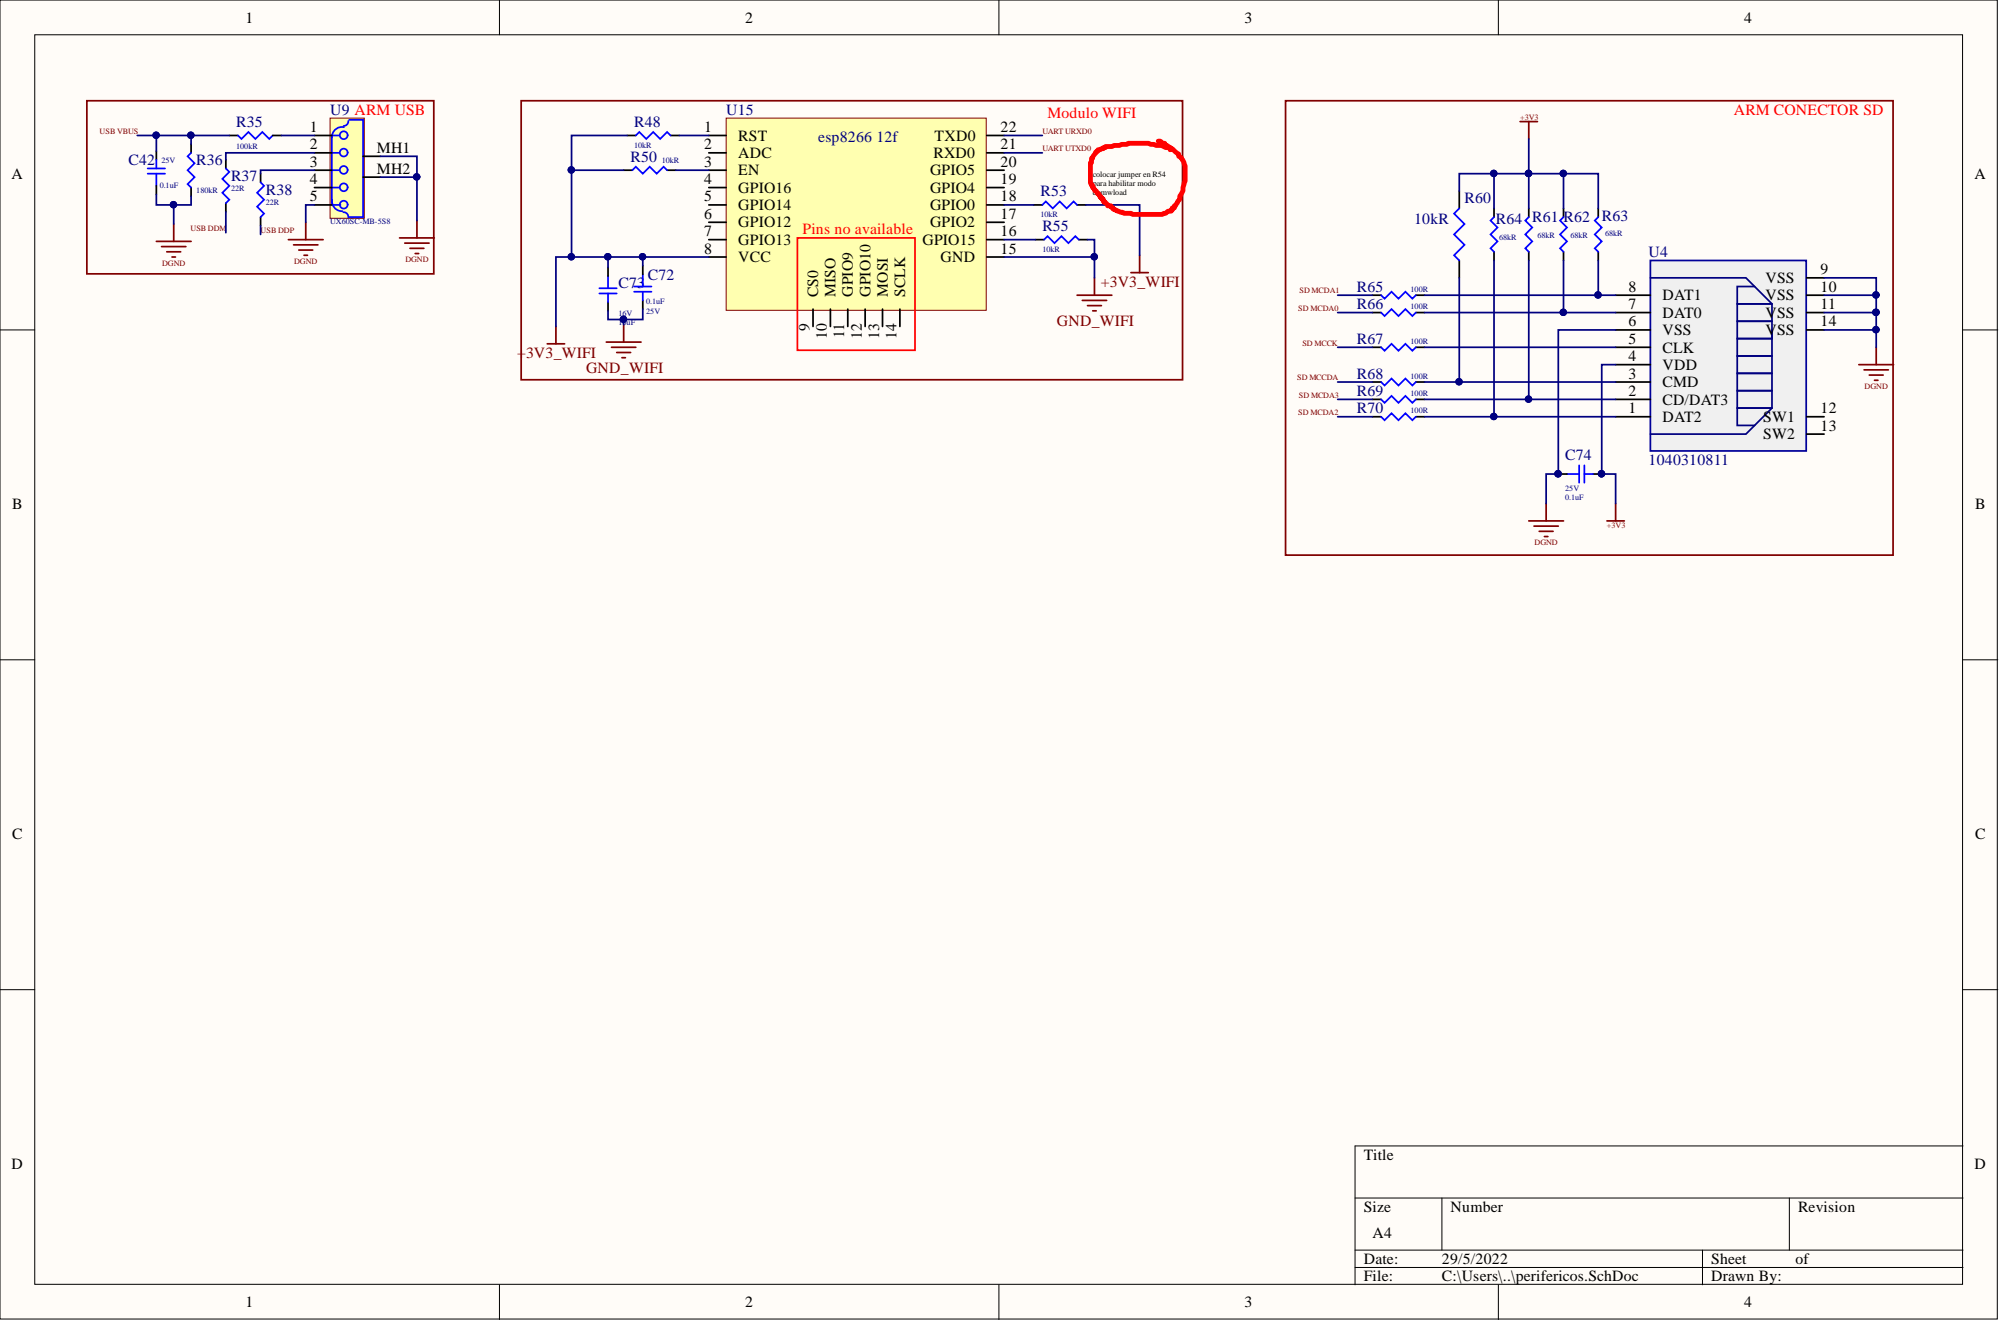
[picture p236: page 4]

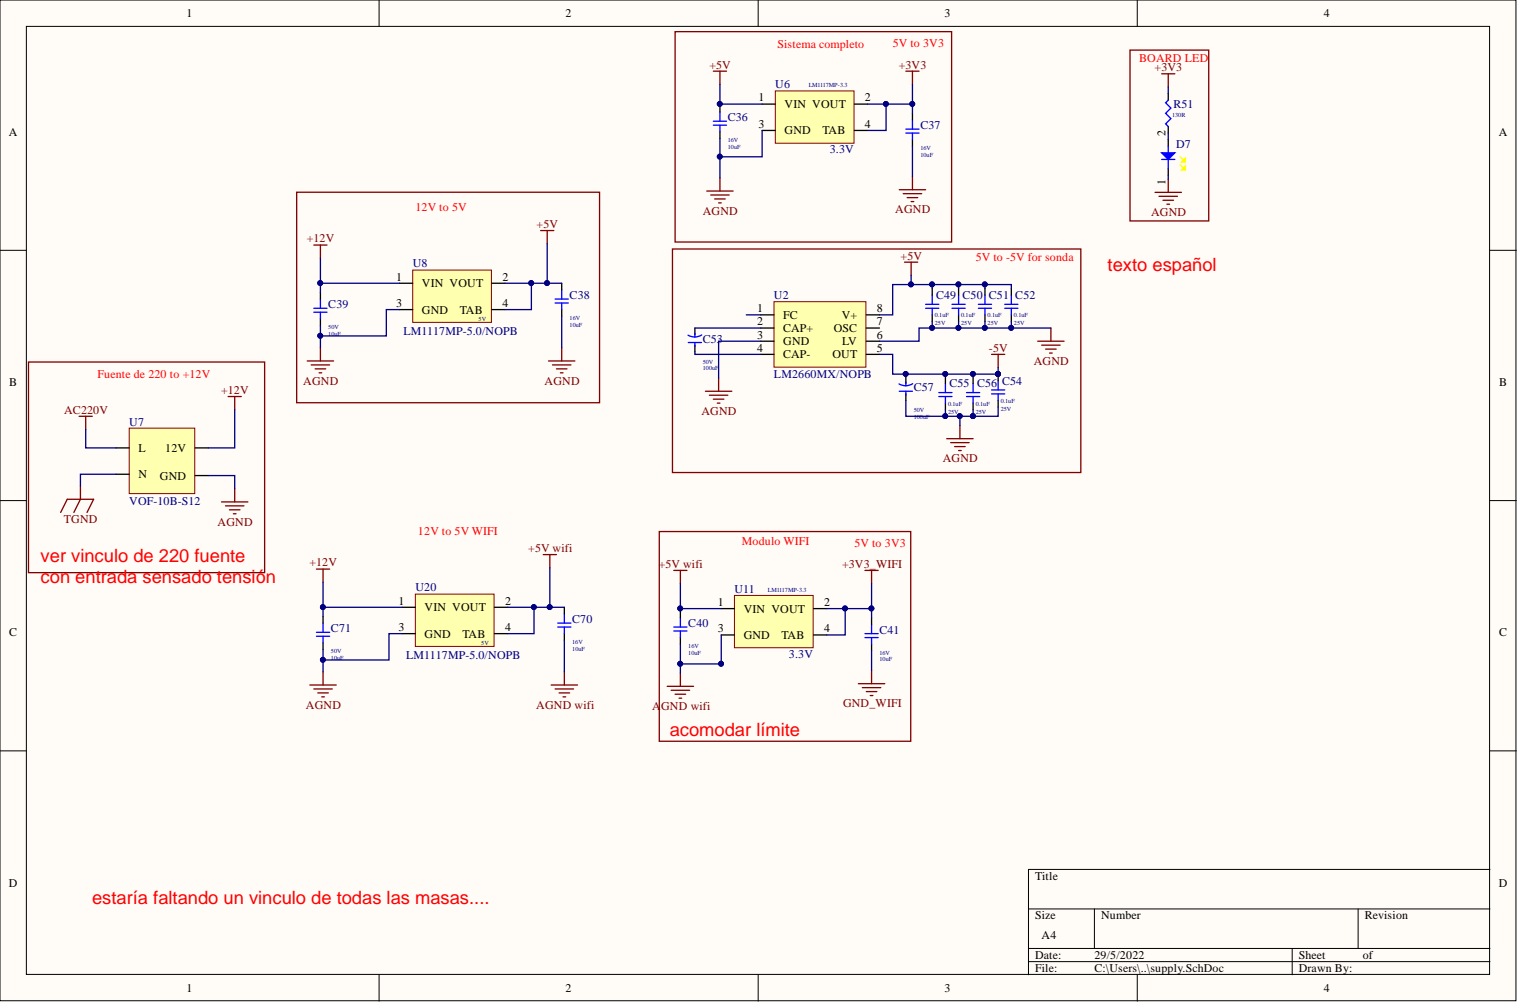
[picture p237: page 5]
