eloy-cacca/Trabajo-final/Trabajo Final_revPD_MF.PDF

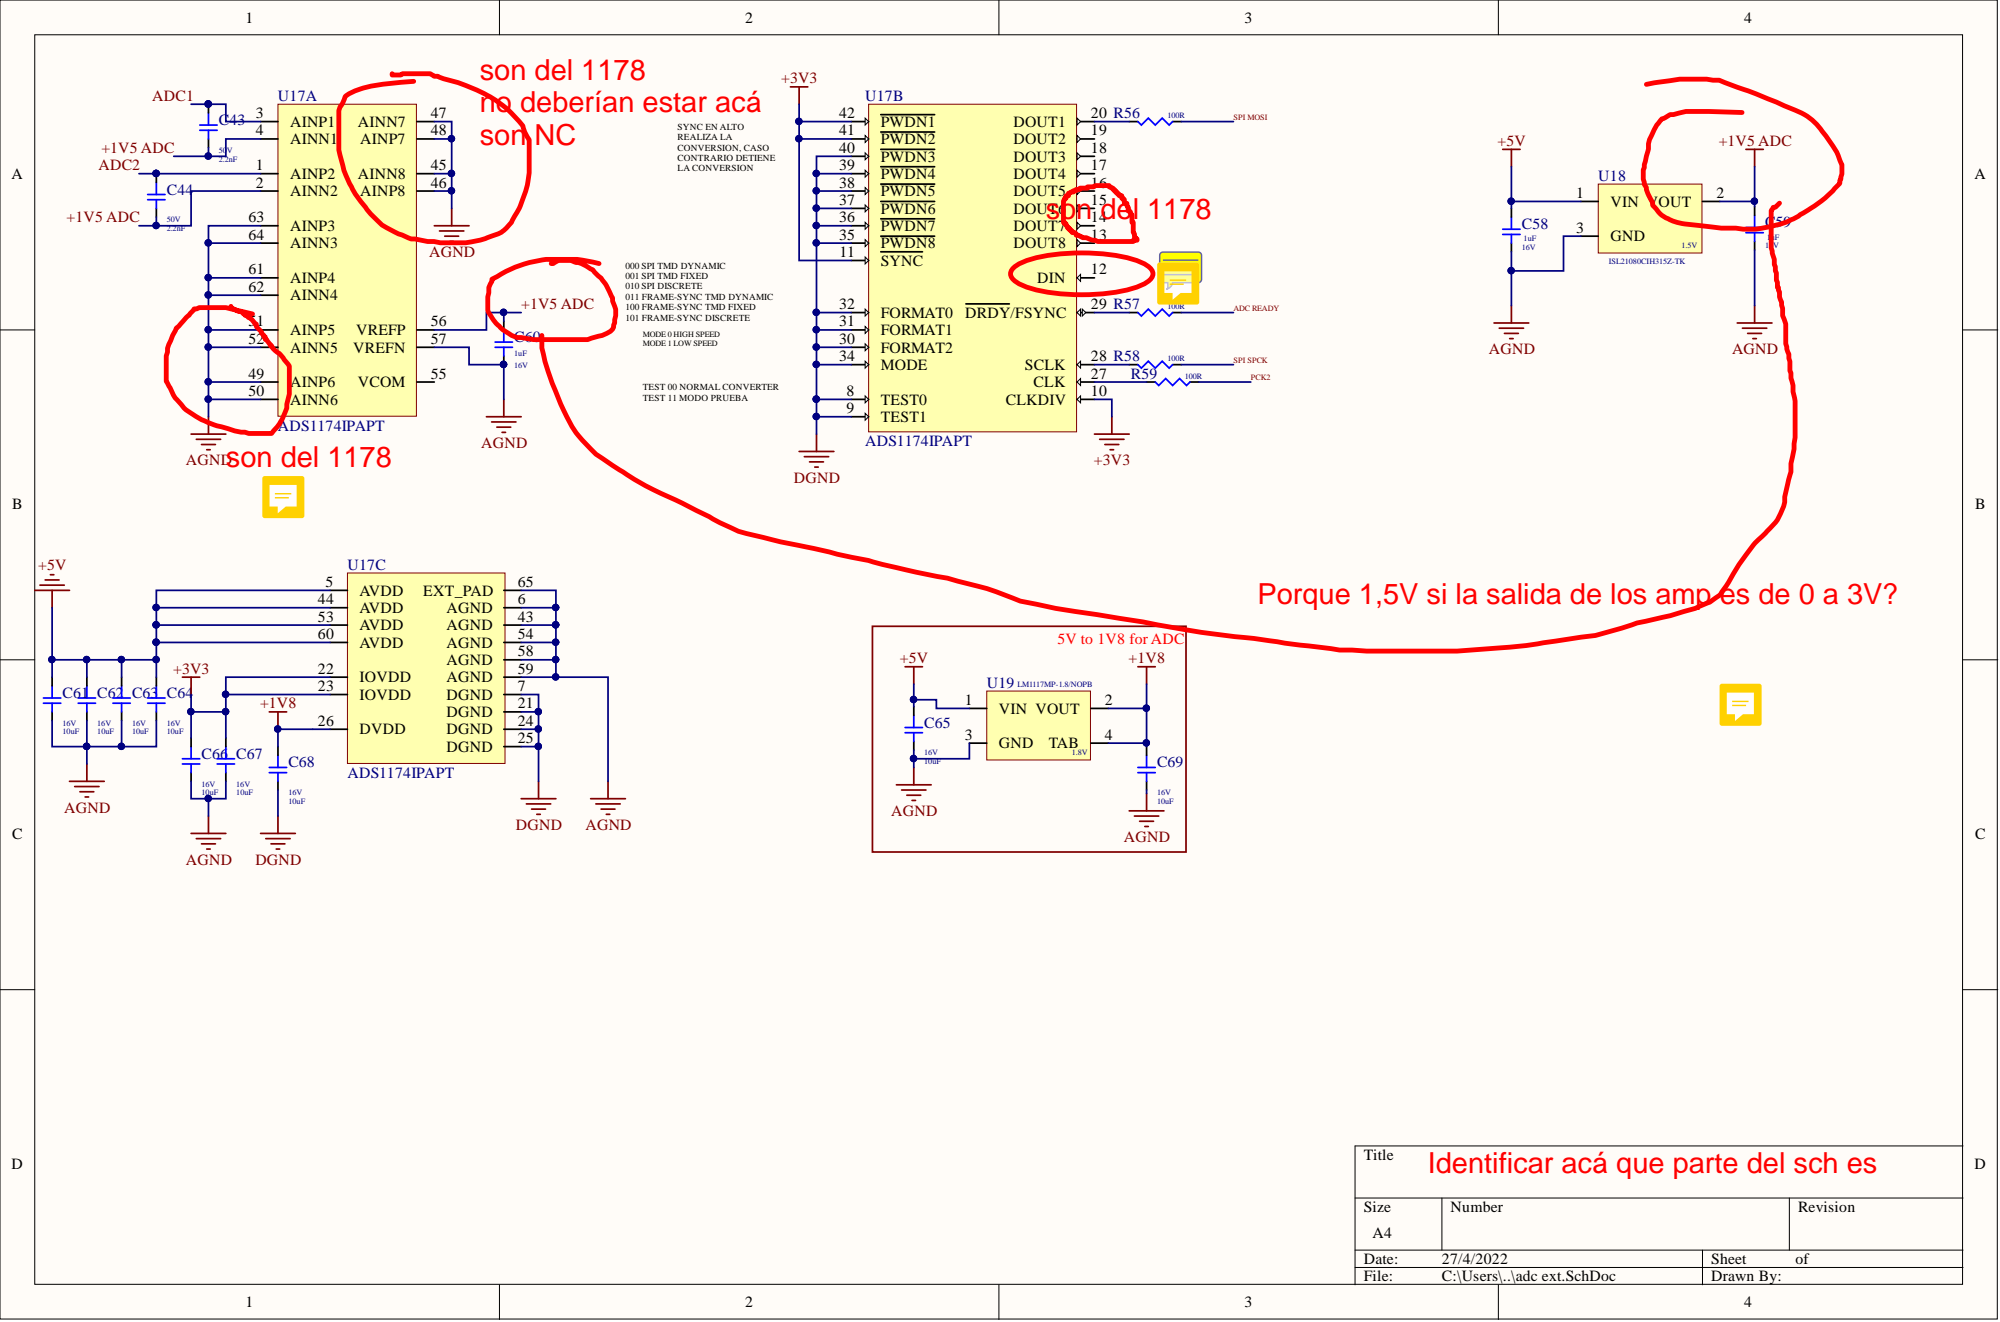
[picture p238: page 1]

4 4 | 6
5 3 | 4 3

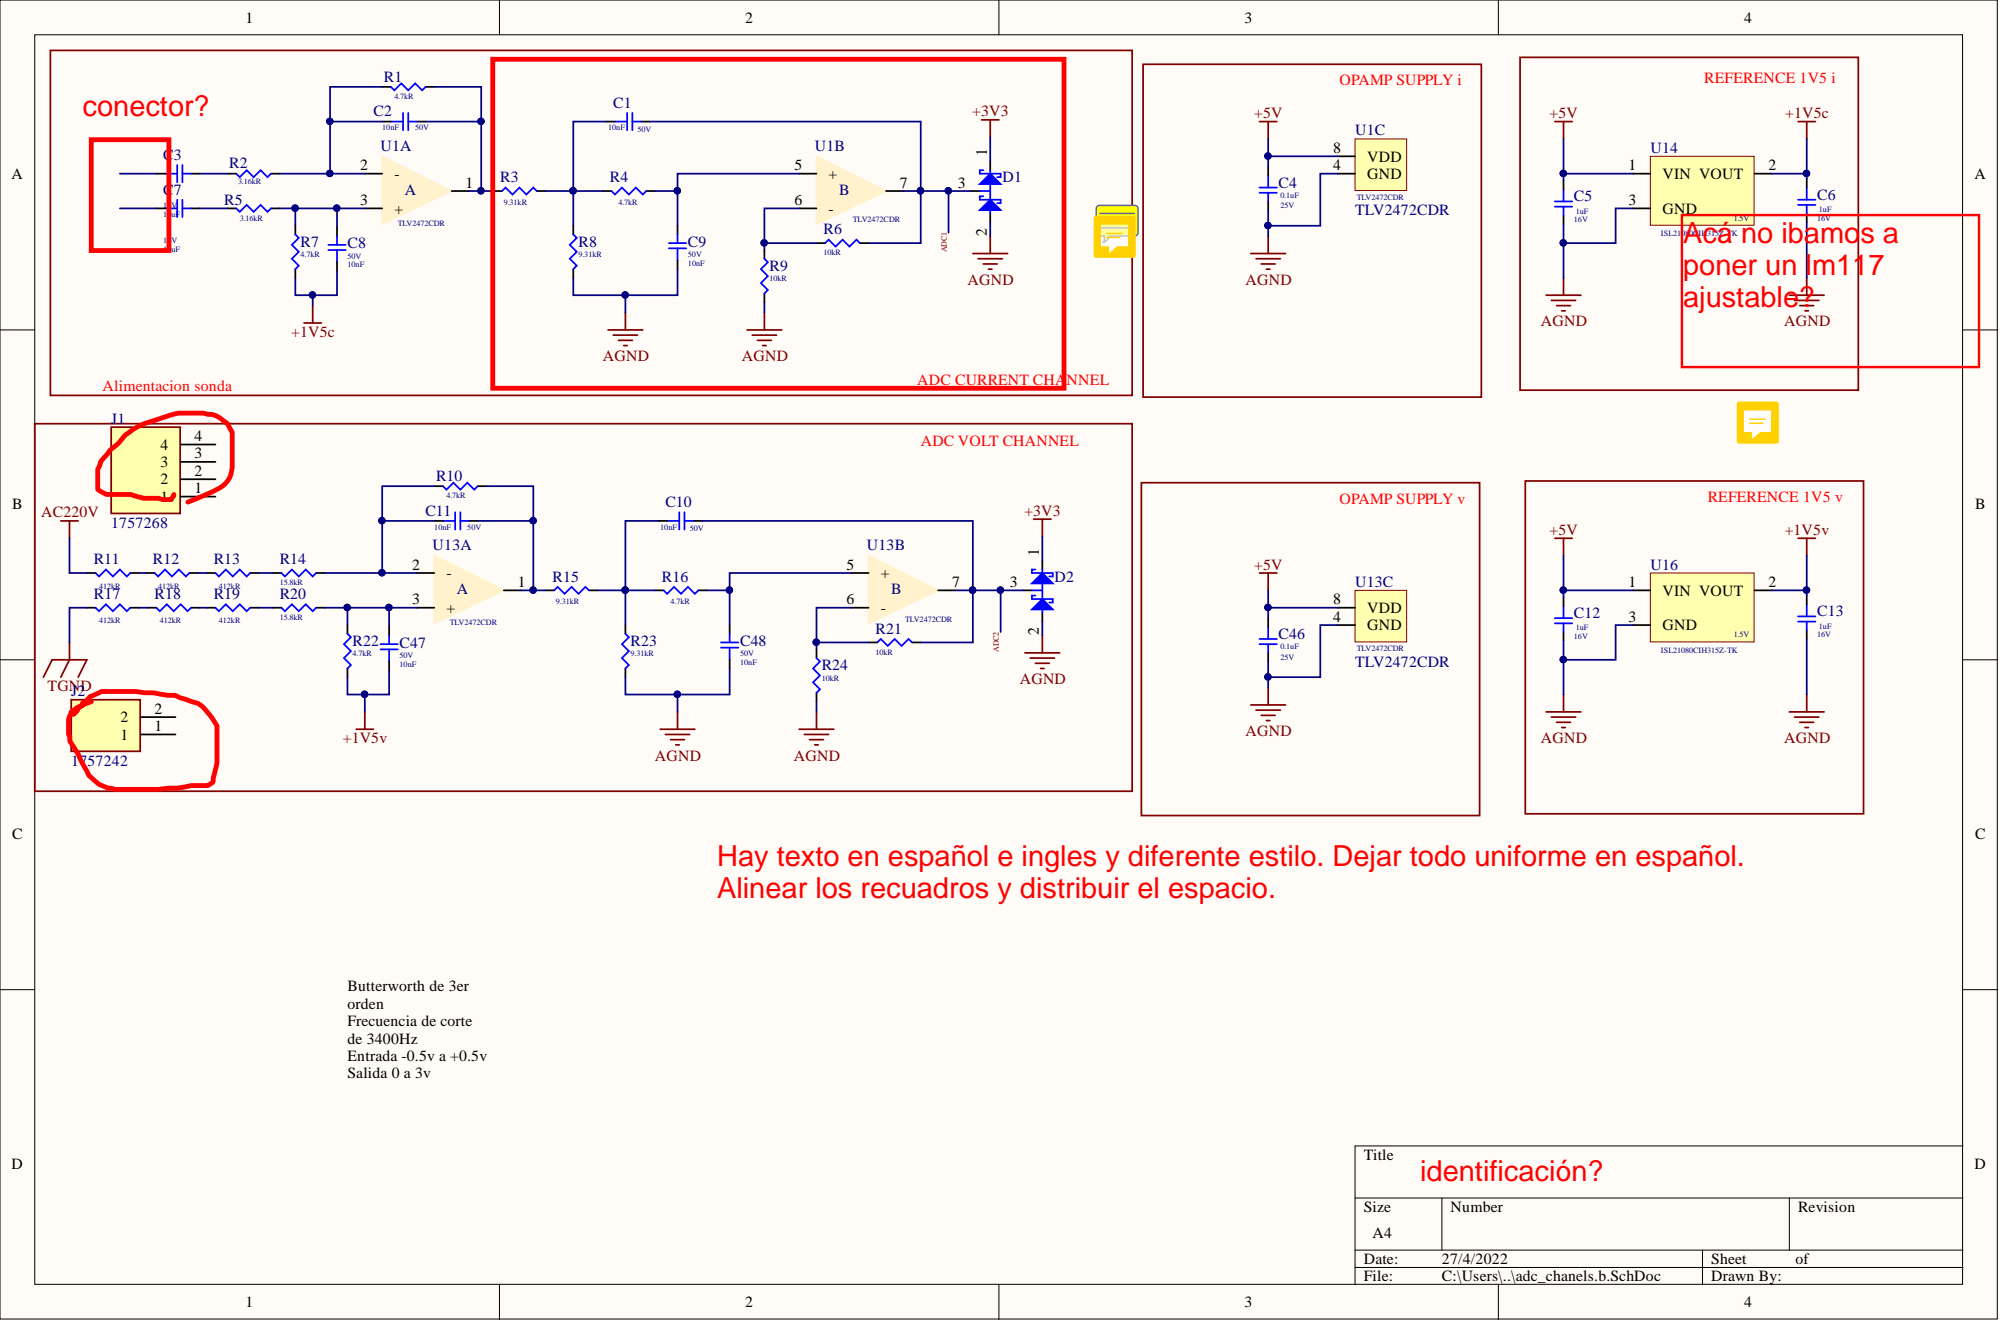
[picture p239: page 2]

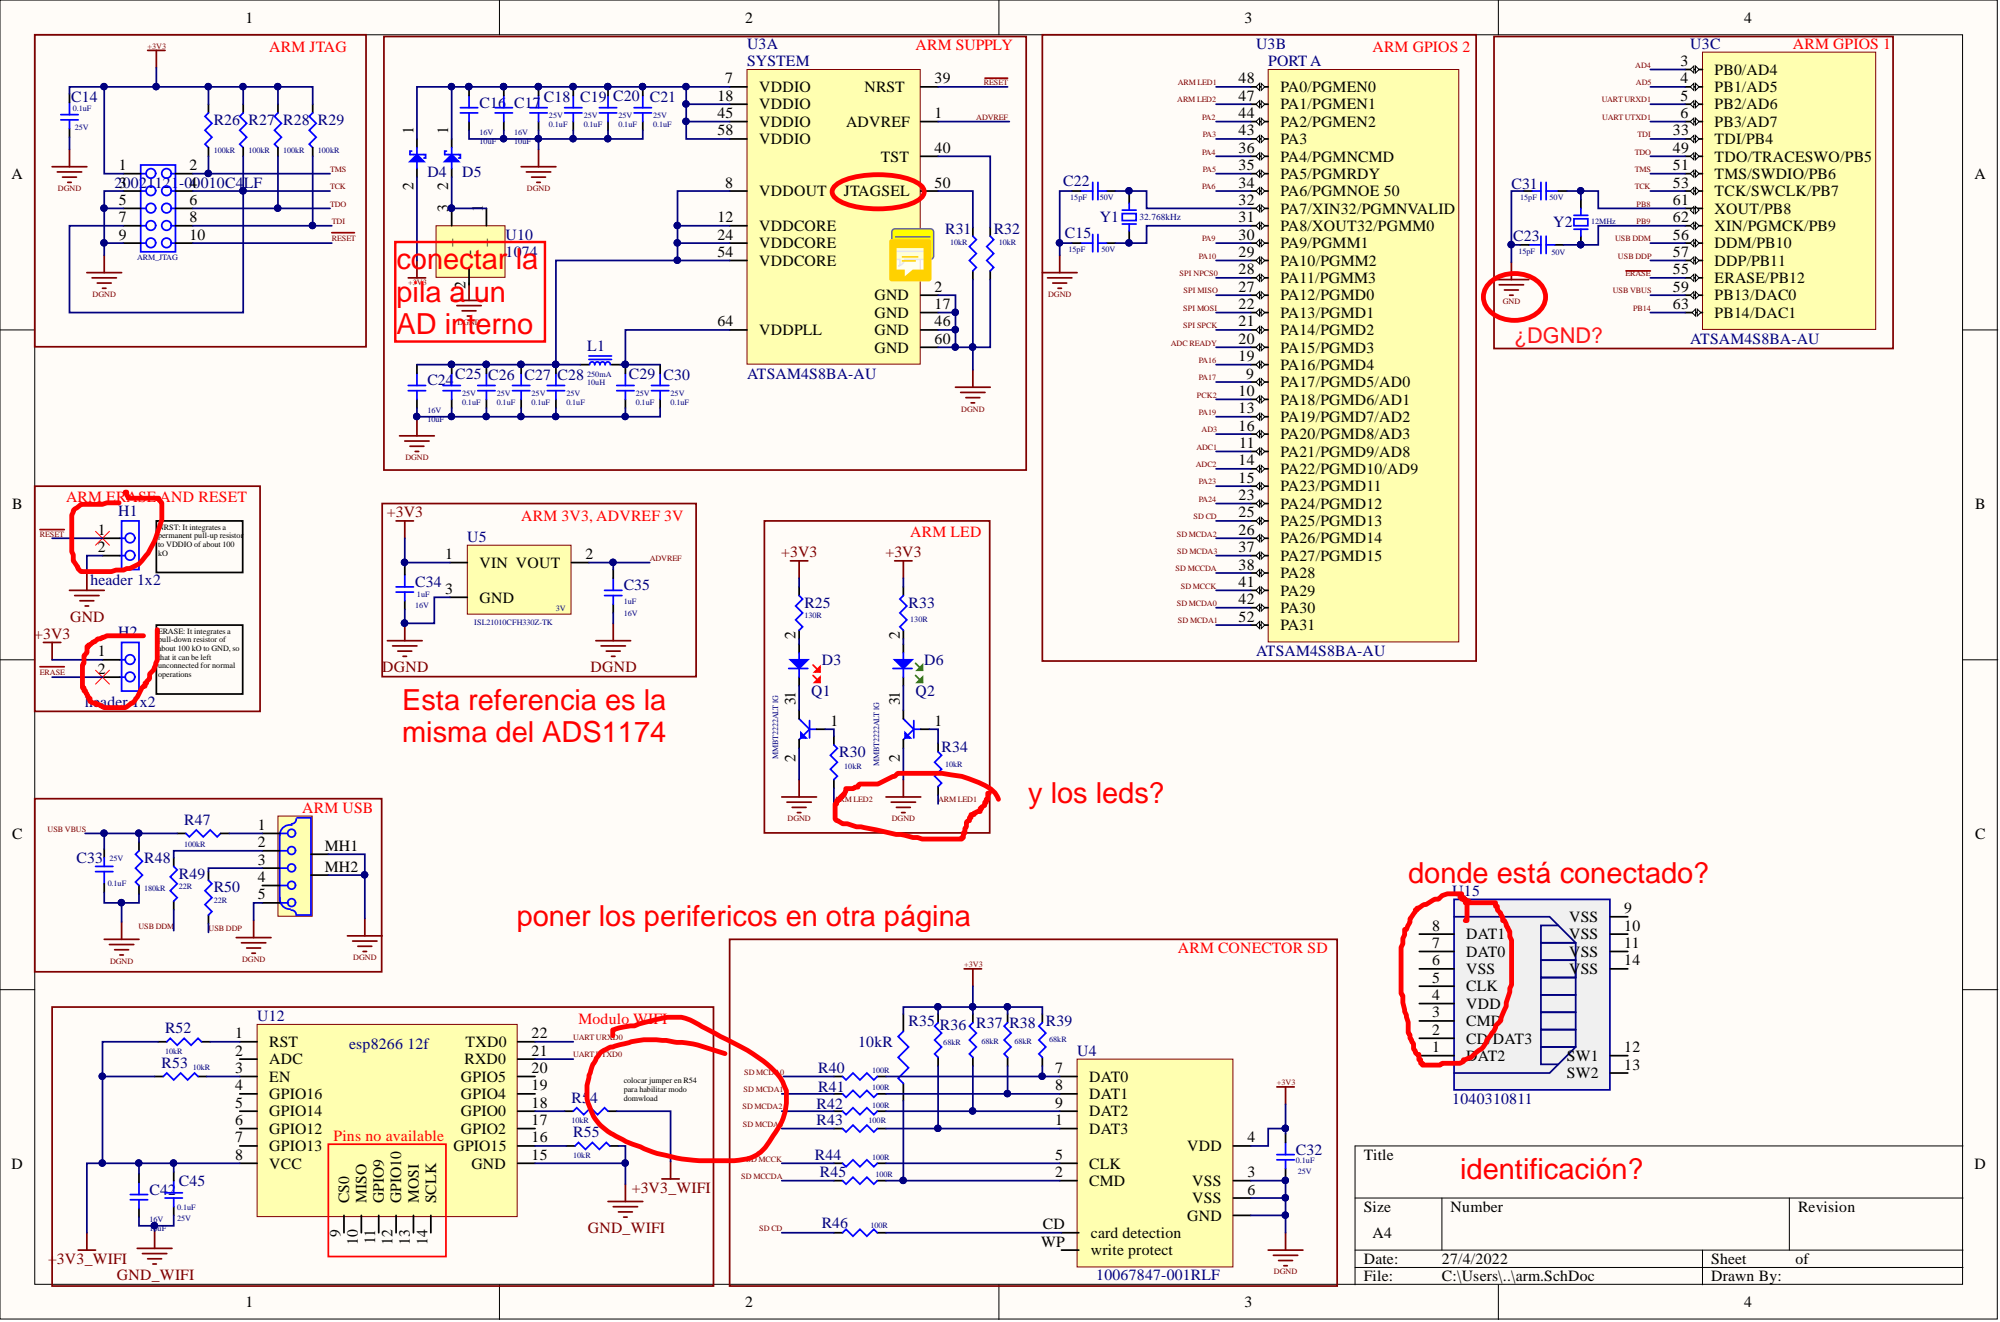
[picture p240: page 3]

ARM ERASE AND RESET

NRST: It integrates a
permanent pull-up resistor
to VDDIO of about 100

pull-down resistor of
about 100 kO to GND, so
that it can be left
unconnected for normal
operations

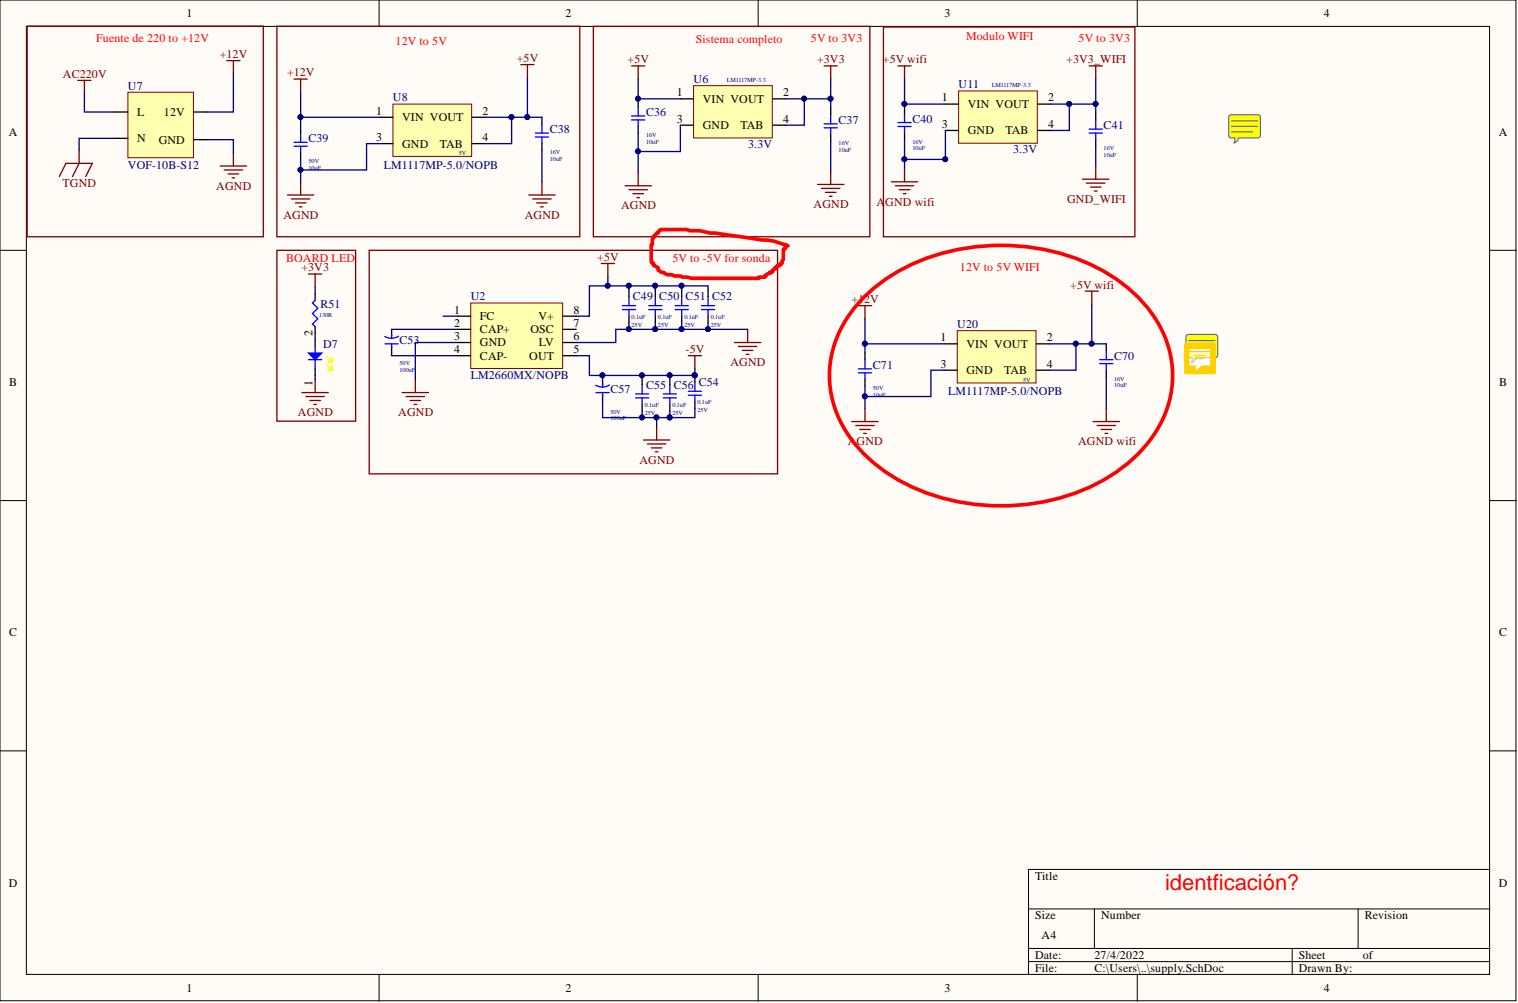
[picture p241: page 4]
