eloy-cacca/Trabajo-final/curso altium/Trabajo Final/Project Outputs for Trabajo Final/Job1.PDF

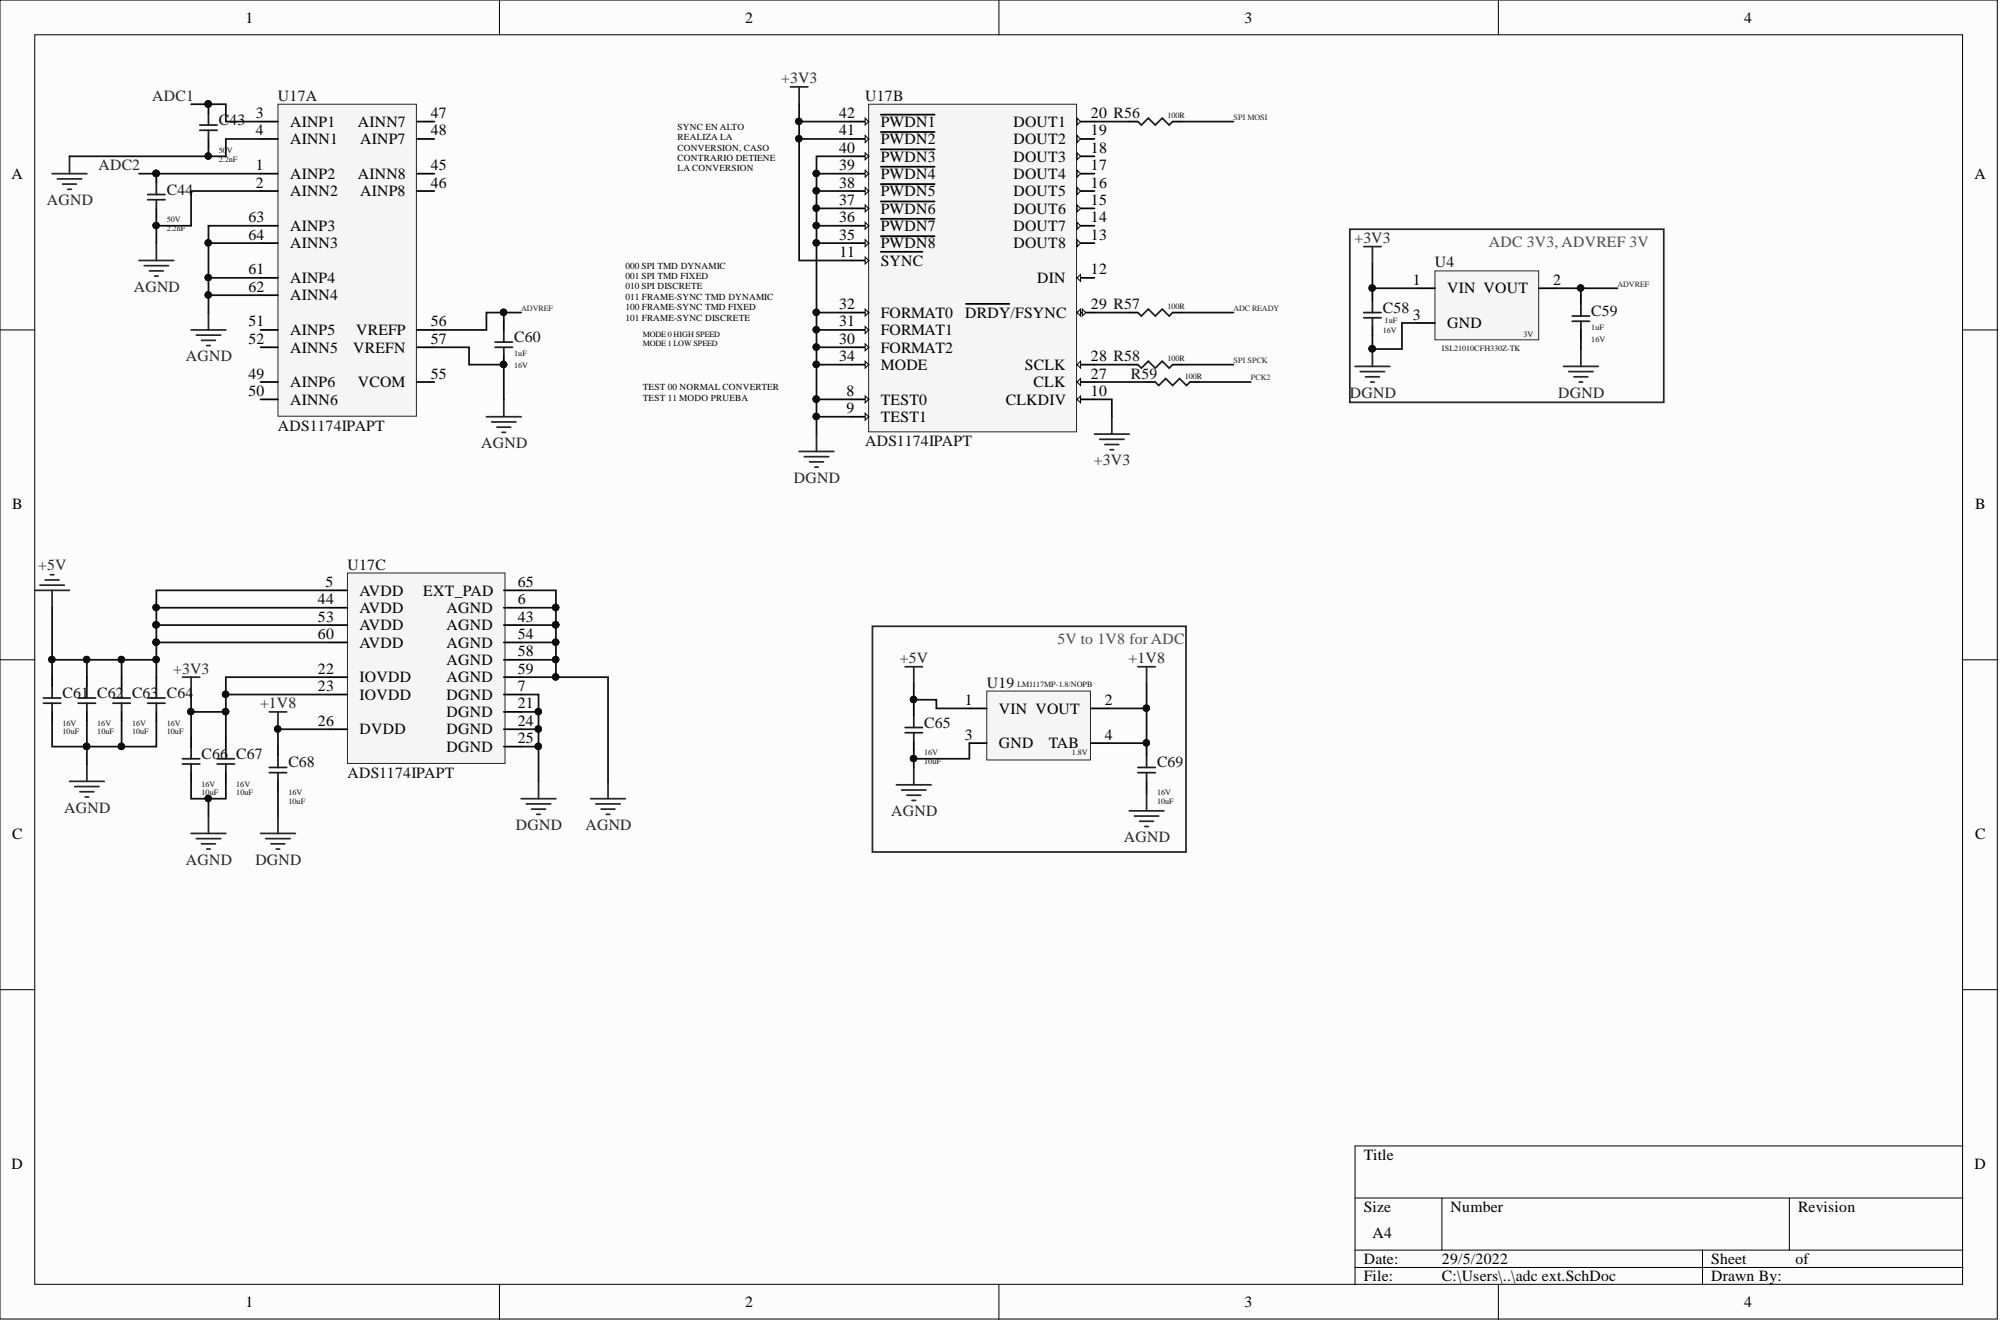
[picture p242: page 1]

4 4 | 6
5 3 | 4 3

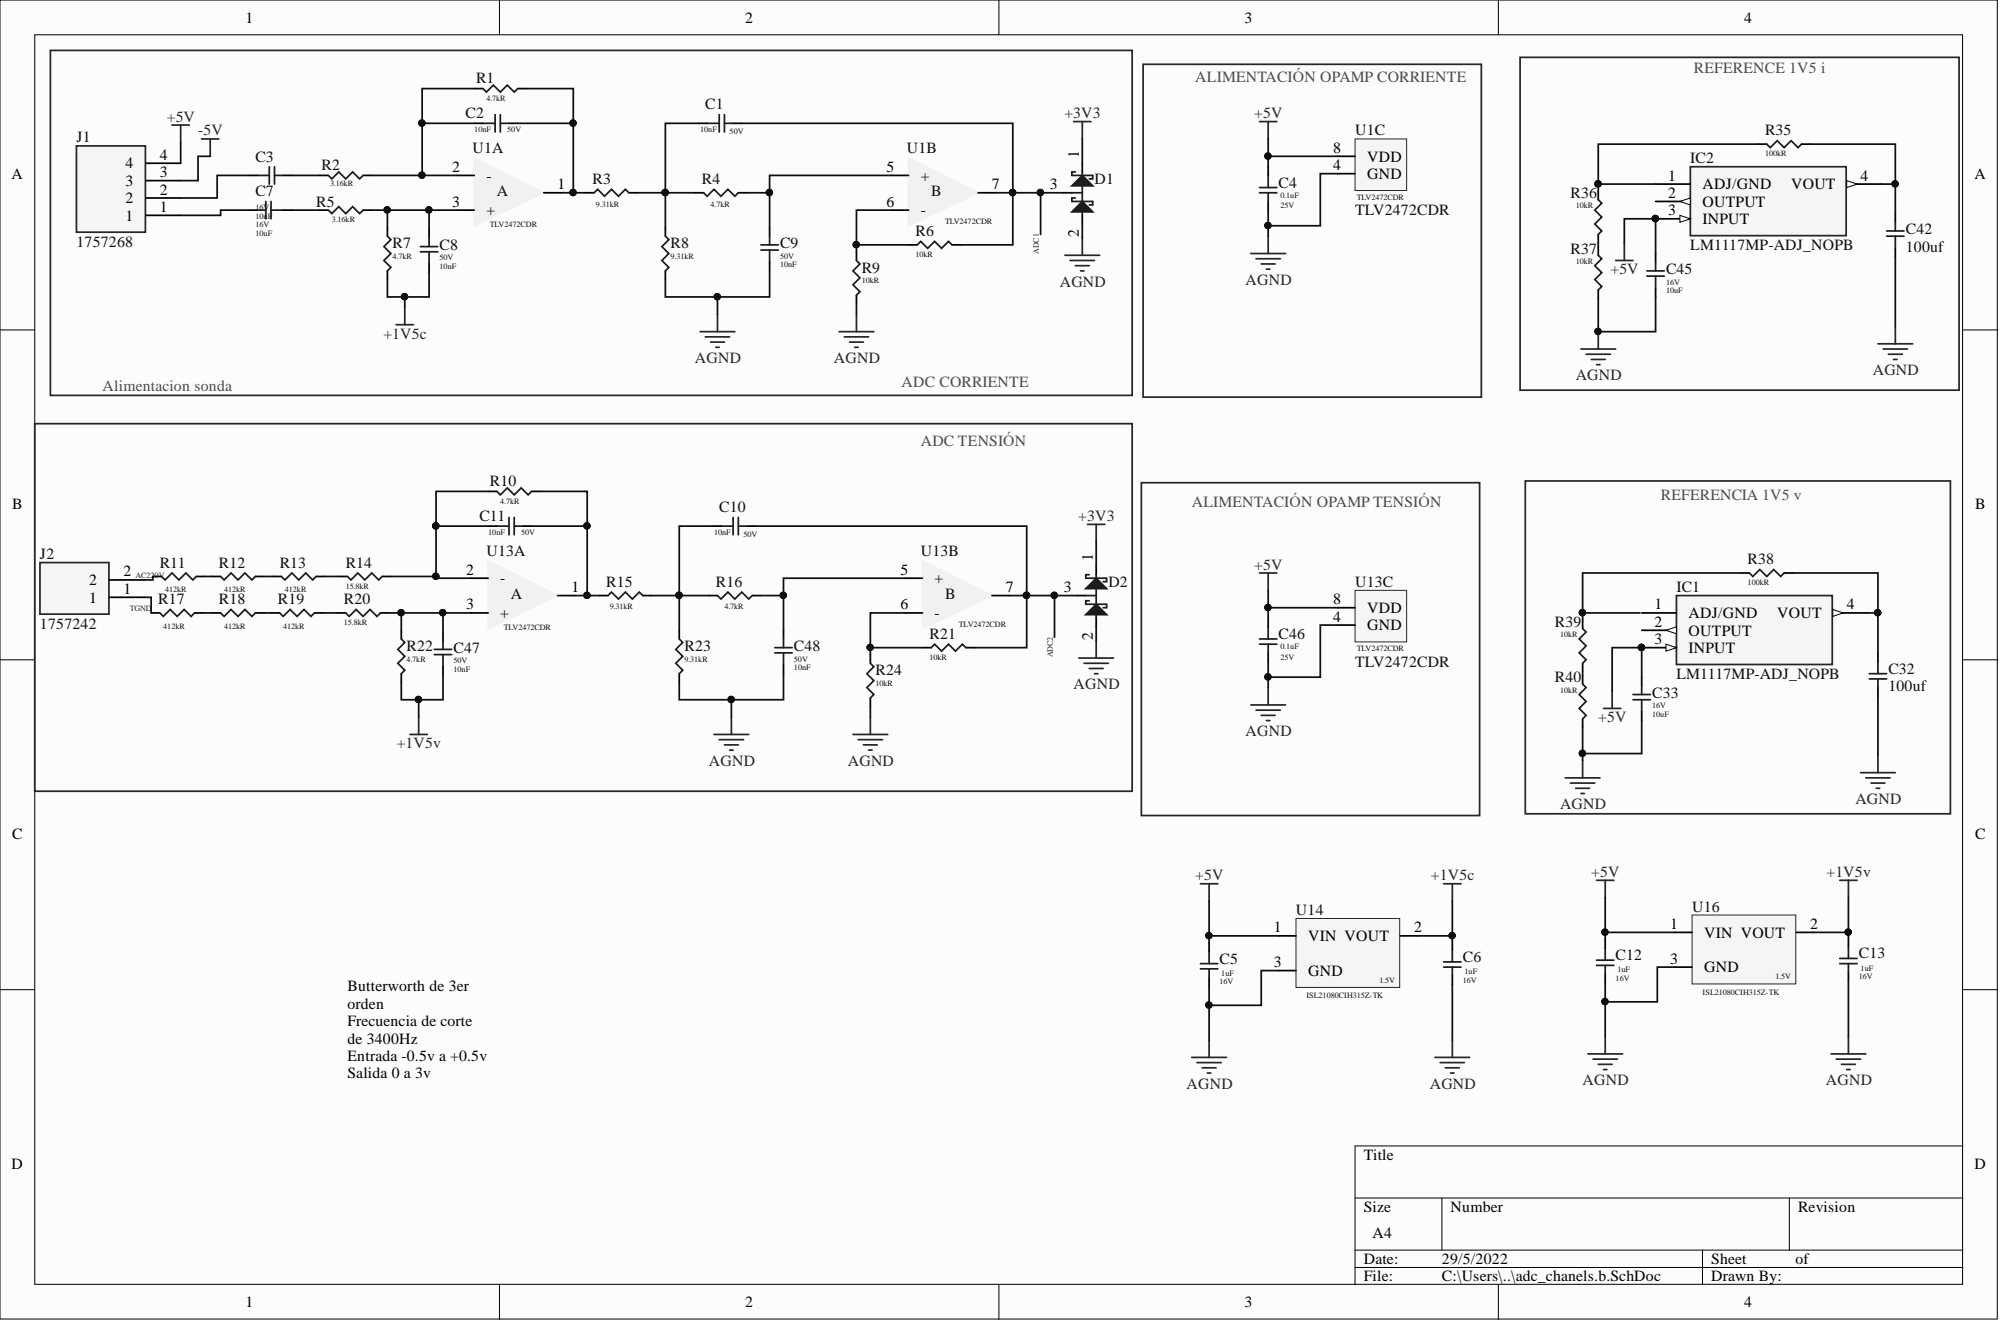
[picture p243: page 2]

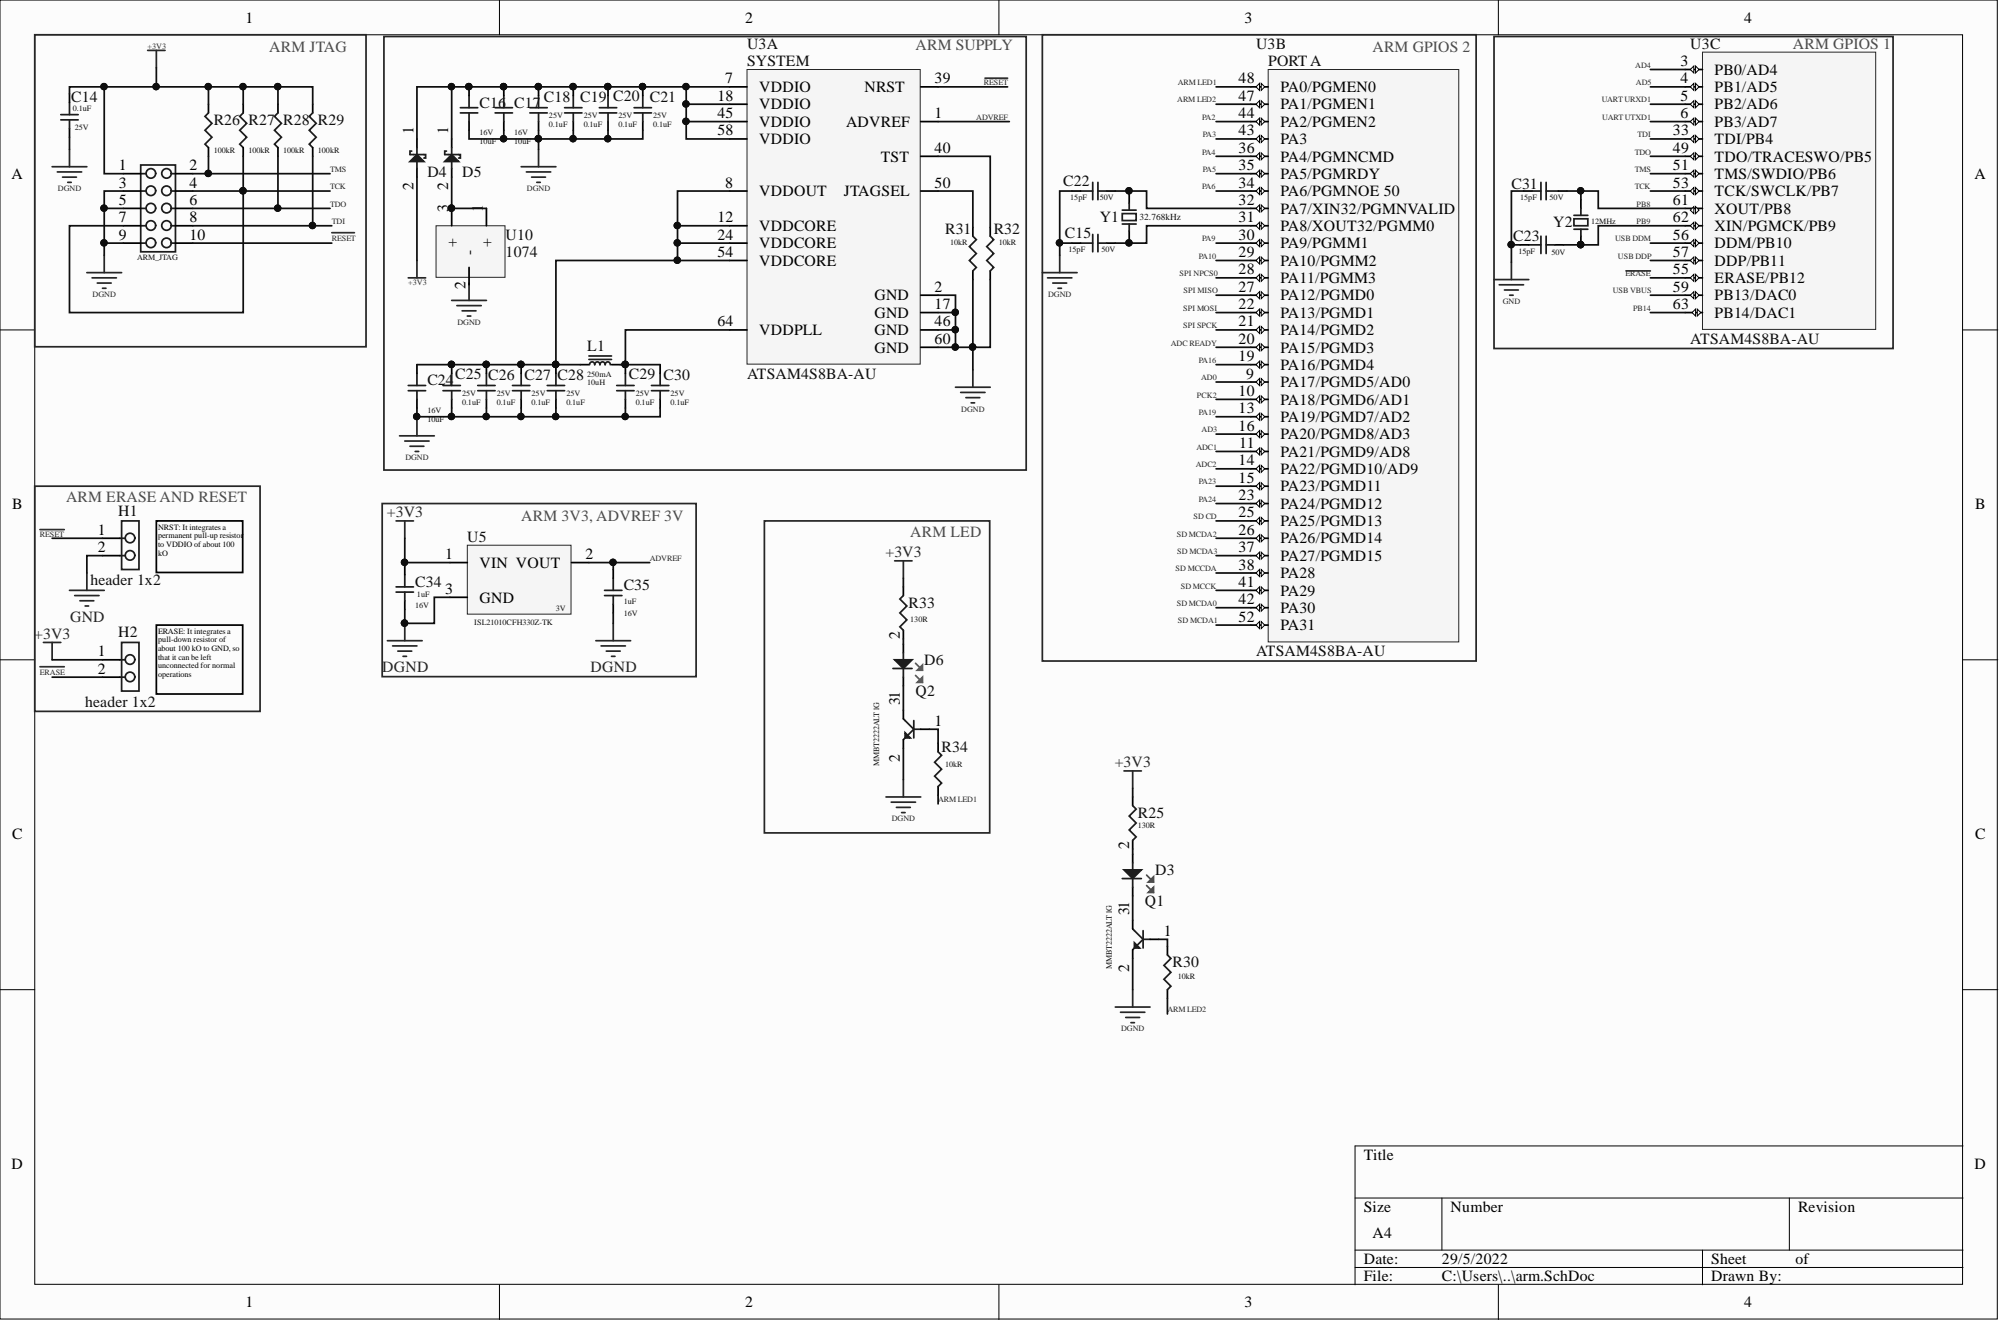
[picture p244: page 3]

UART UTXD1 TMS TCK TDO TDI

1 7
4 6

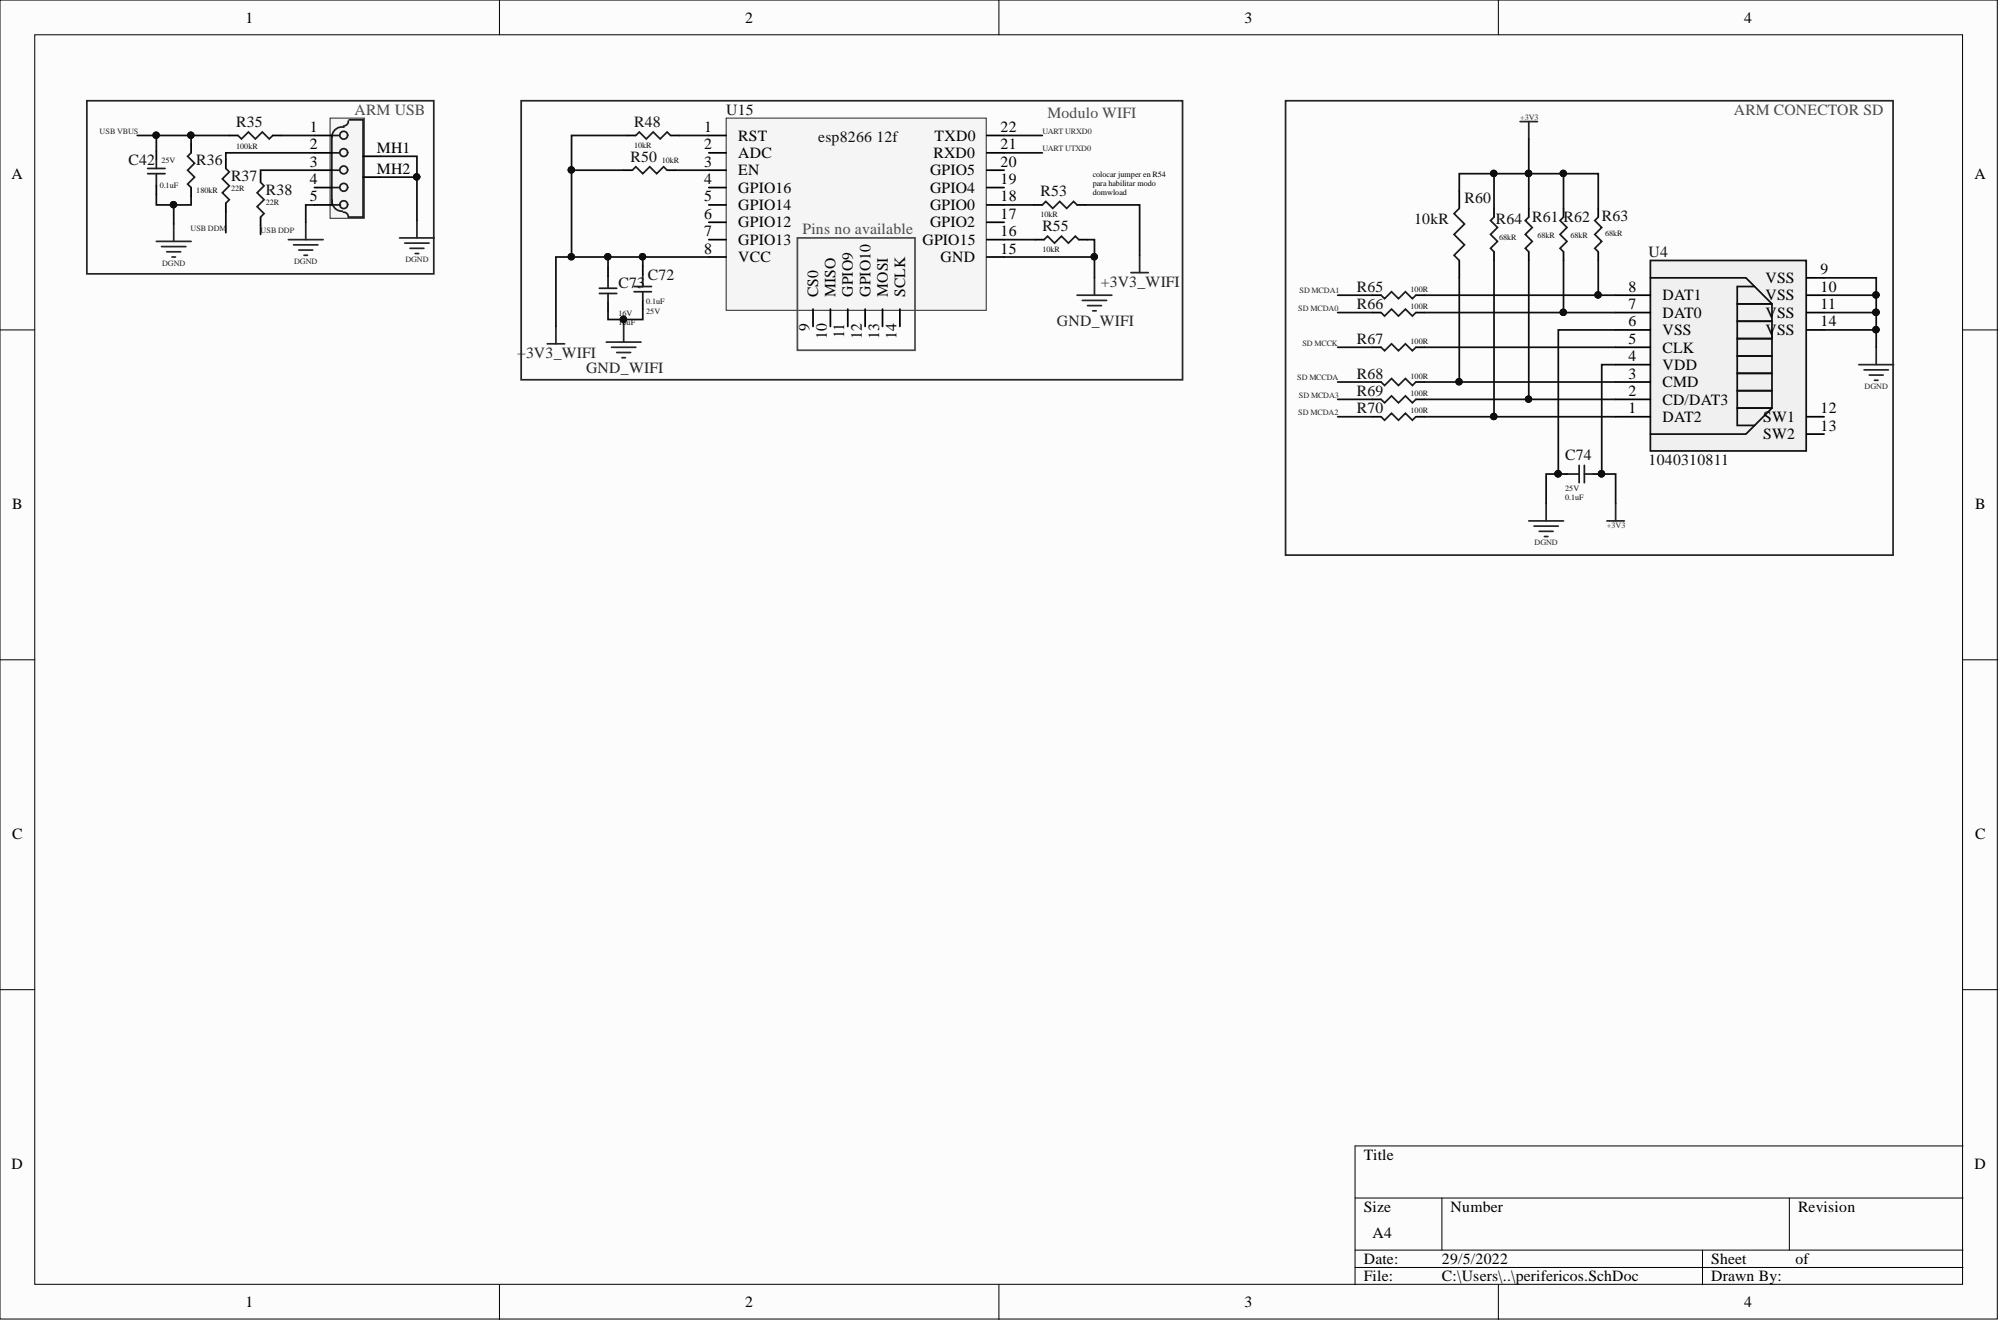
[picture p245: page 4]

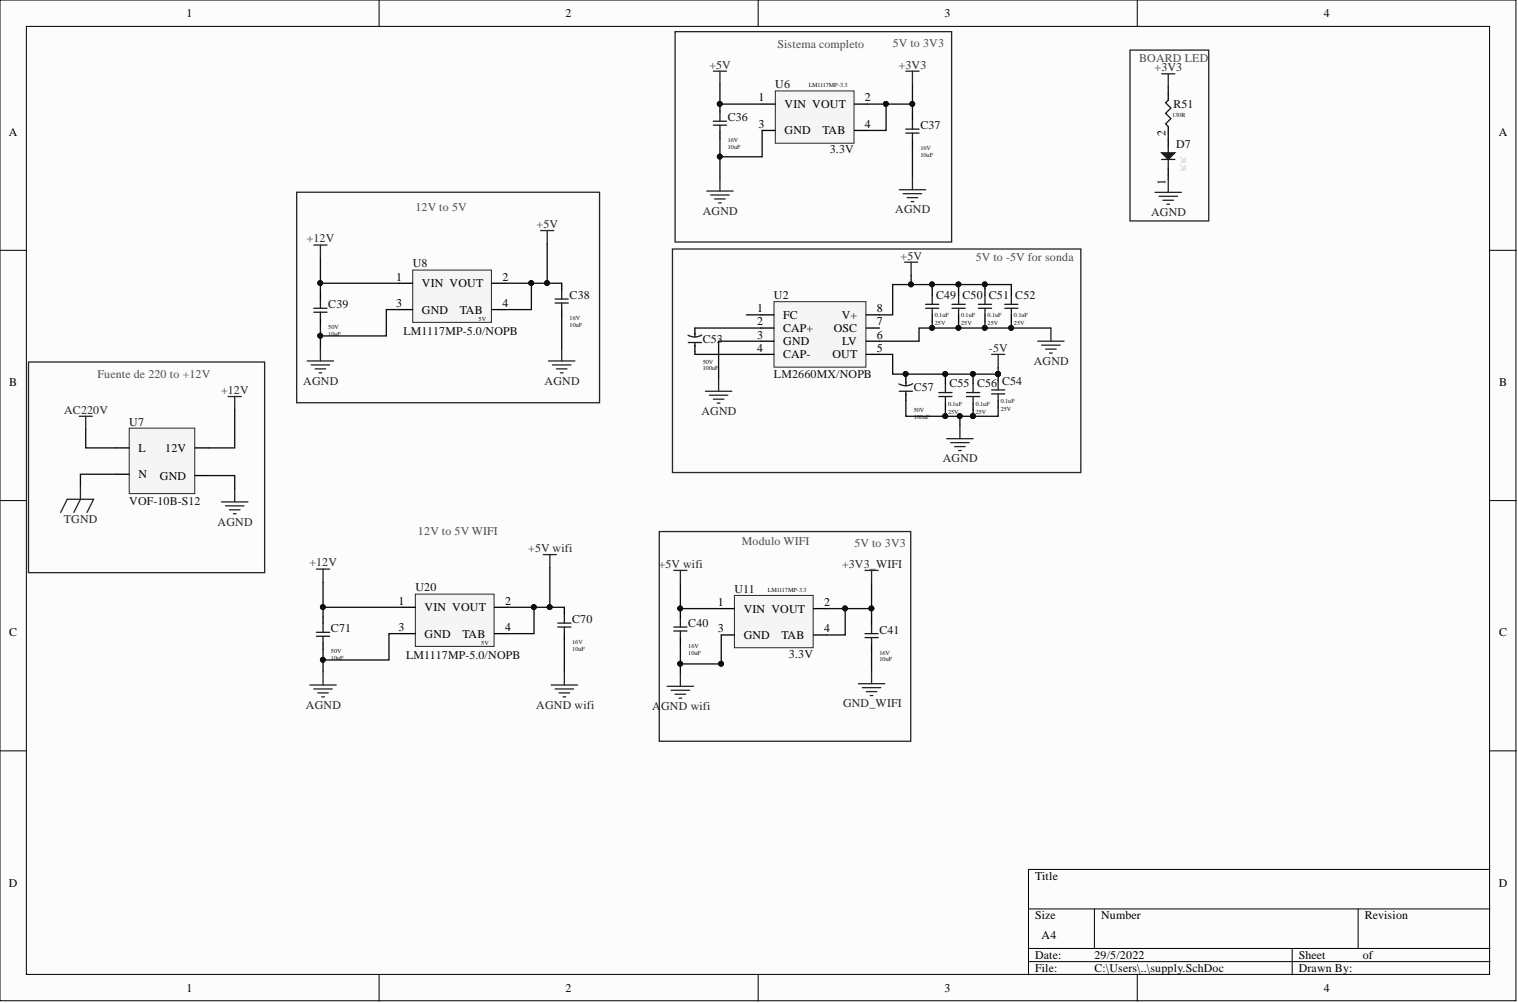
[picture p246: page 5]

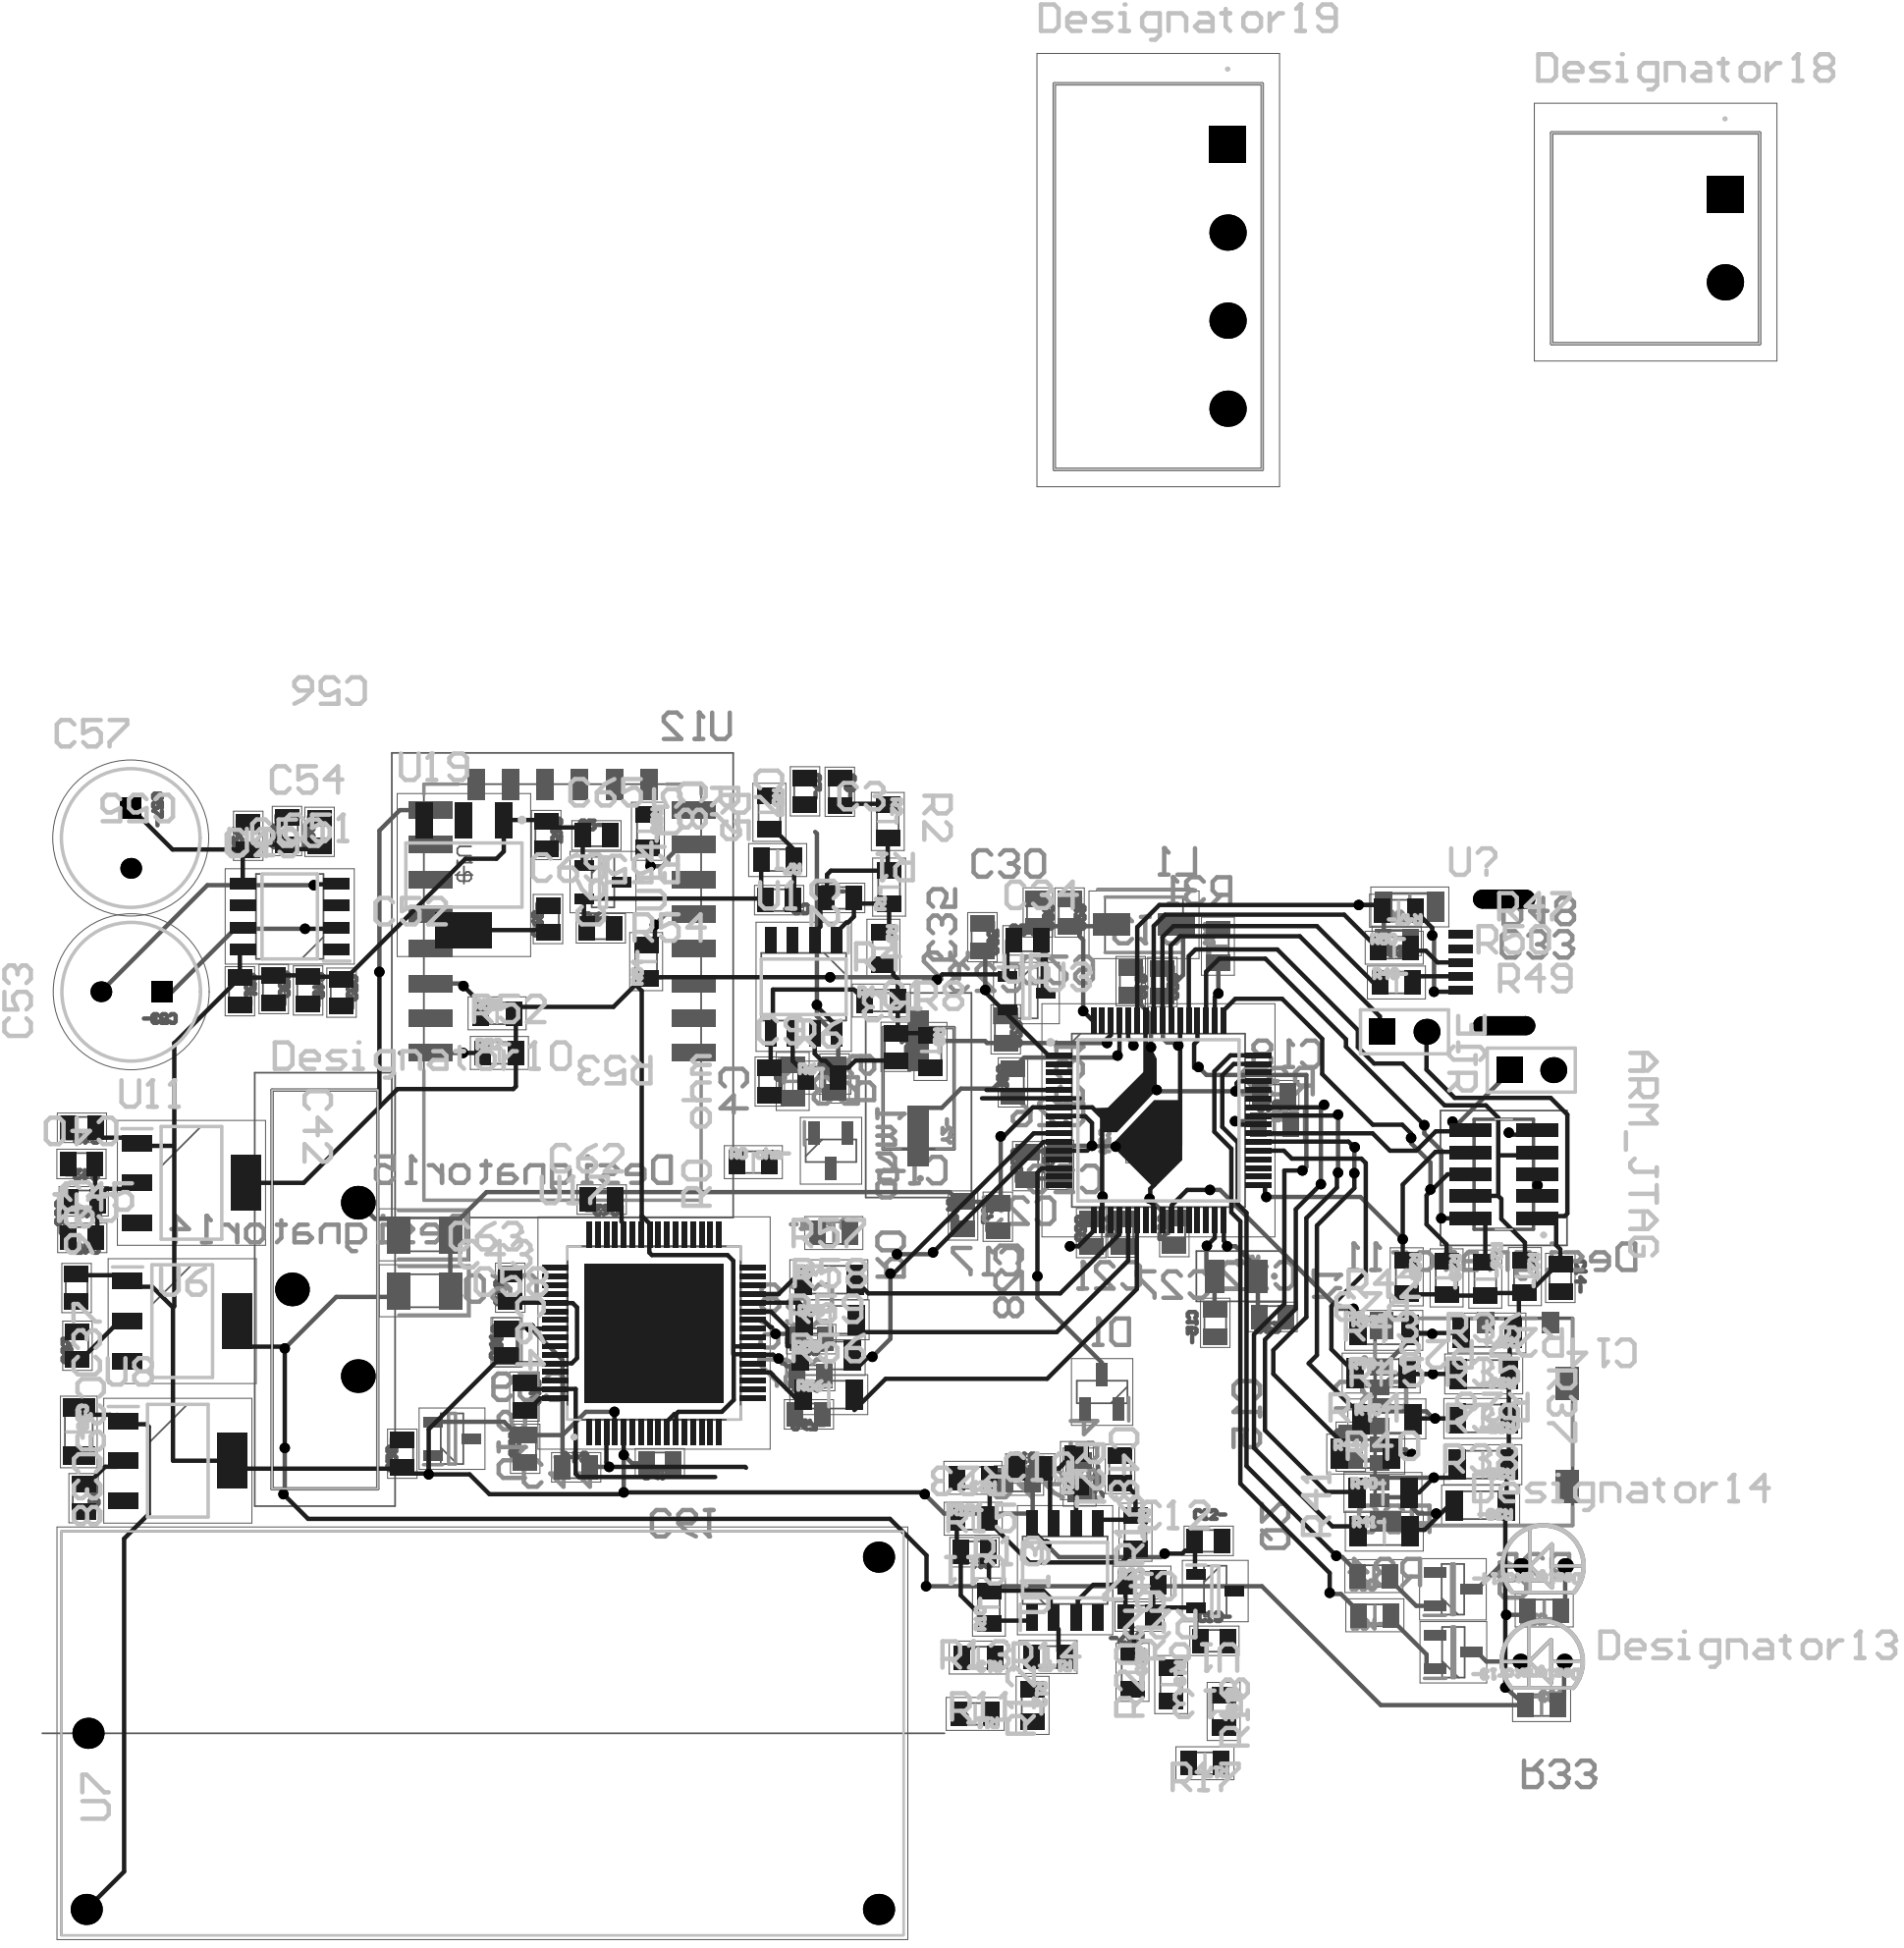
[picture p247: page 6]
