eloy-cacca/Trabajo-final/curso altium/Trabajo Final/Project Outputs for Trabajo Final/PDF/Trabajo Final.PDF

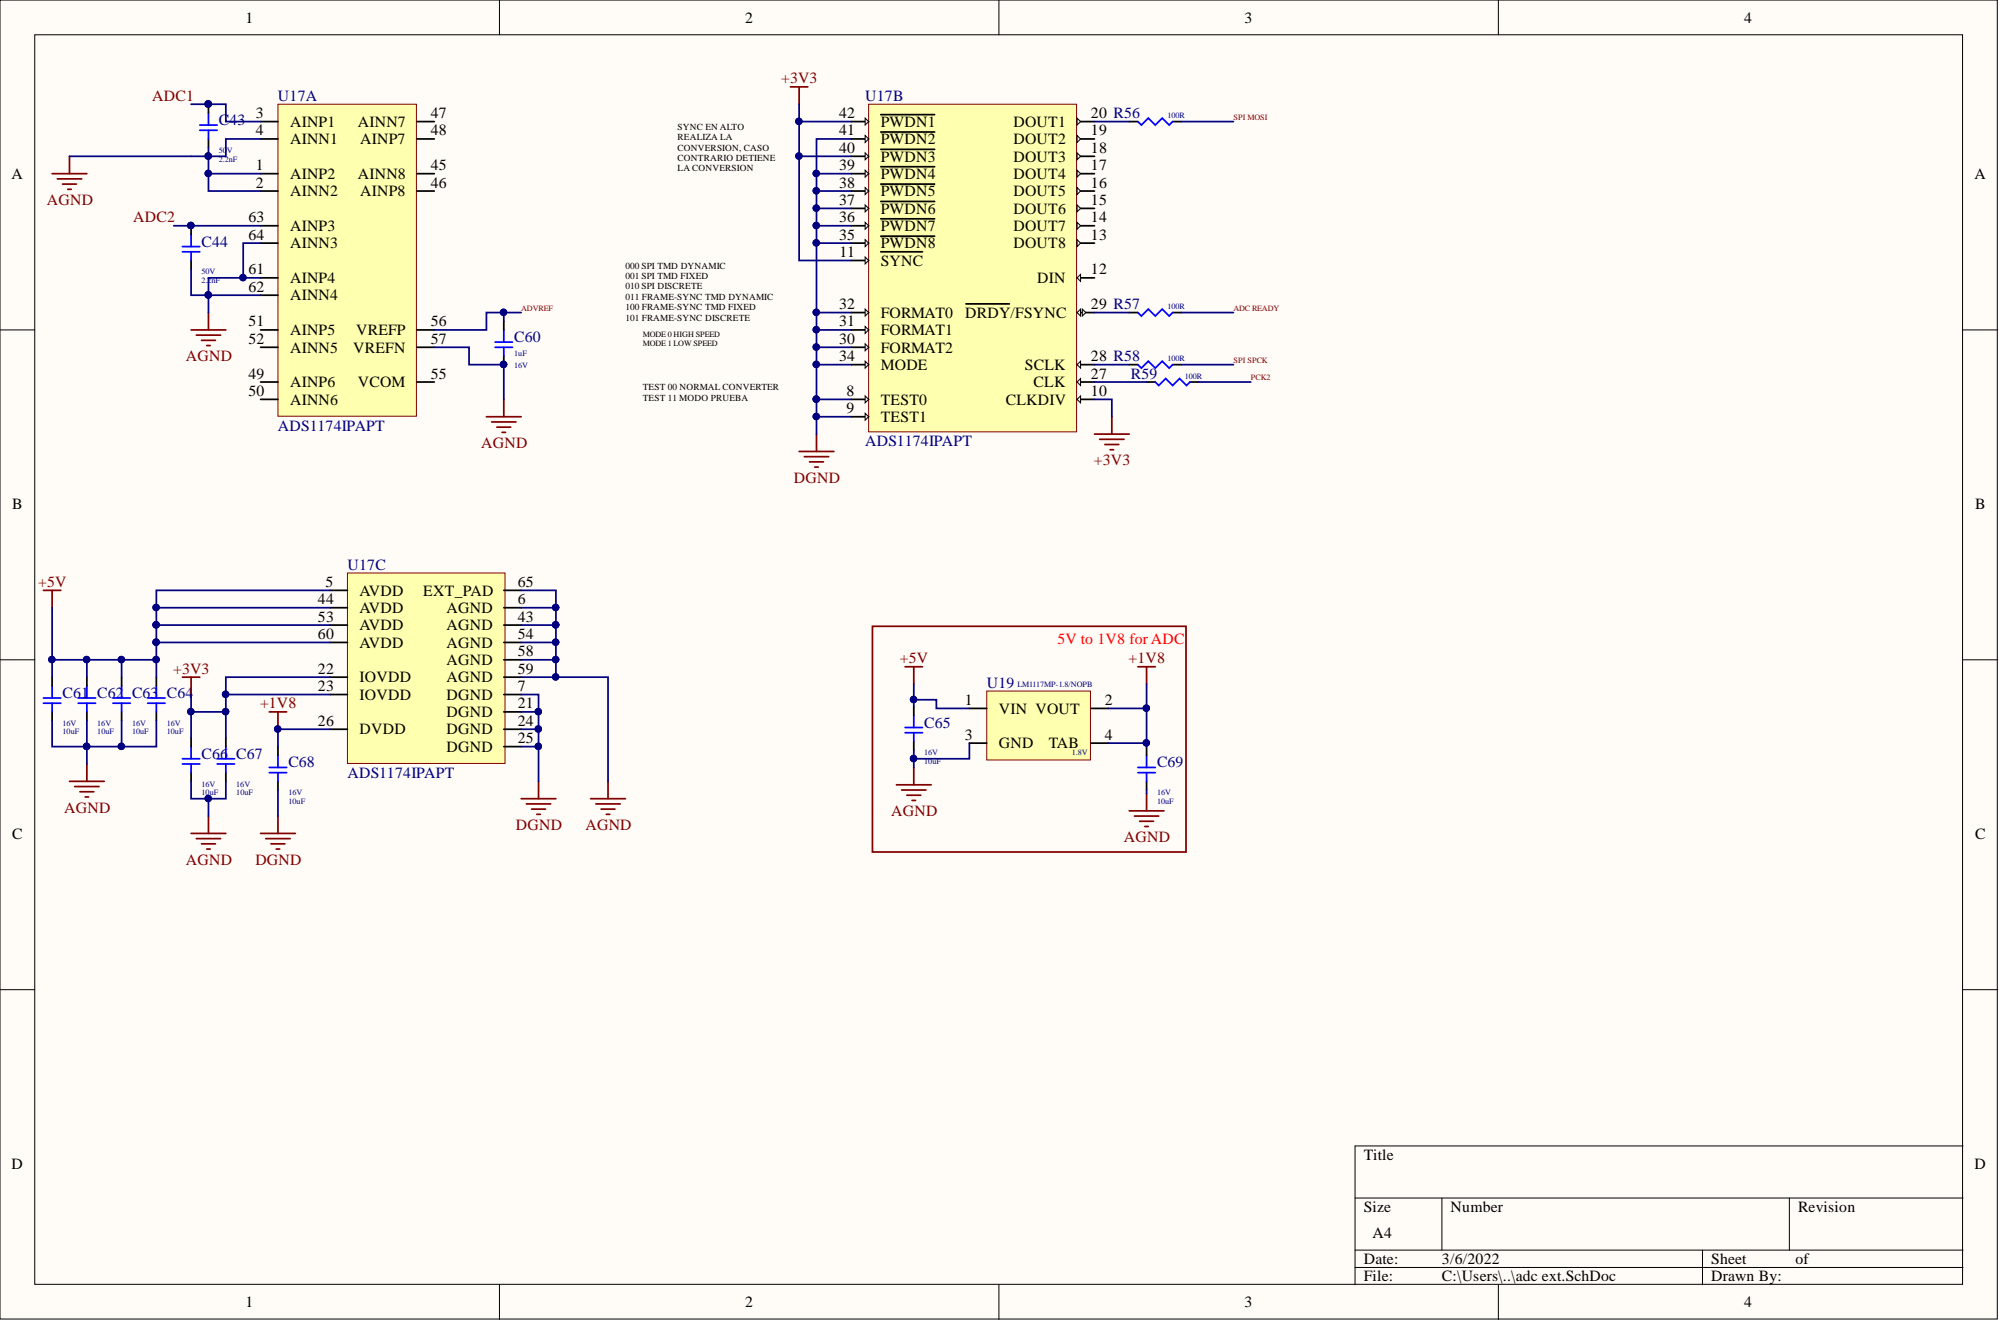
[picture p248: page 1]

PWDN5 38

PWDN7 36
PWDN8 35

AINP4 61

000 SPI TMD DYNAMIC
001 SPI TMD FIXED
010 SPI DISCRETE
011 FRAME-SYNC TMD DYNAMIC
100 FRAME-SYNC TMD FIXED
101 FRAME-SYNC DISCRETE

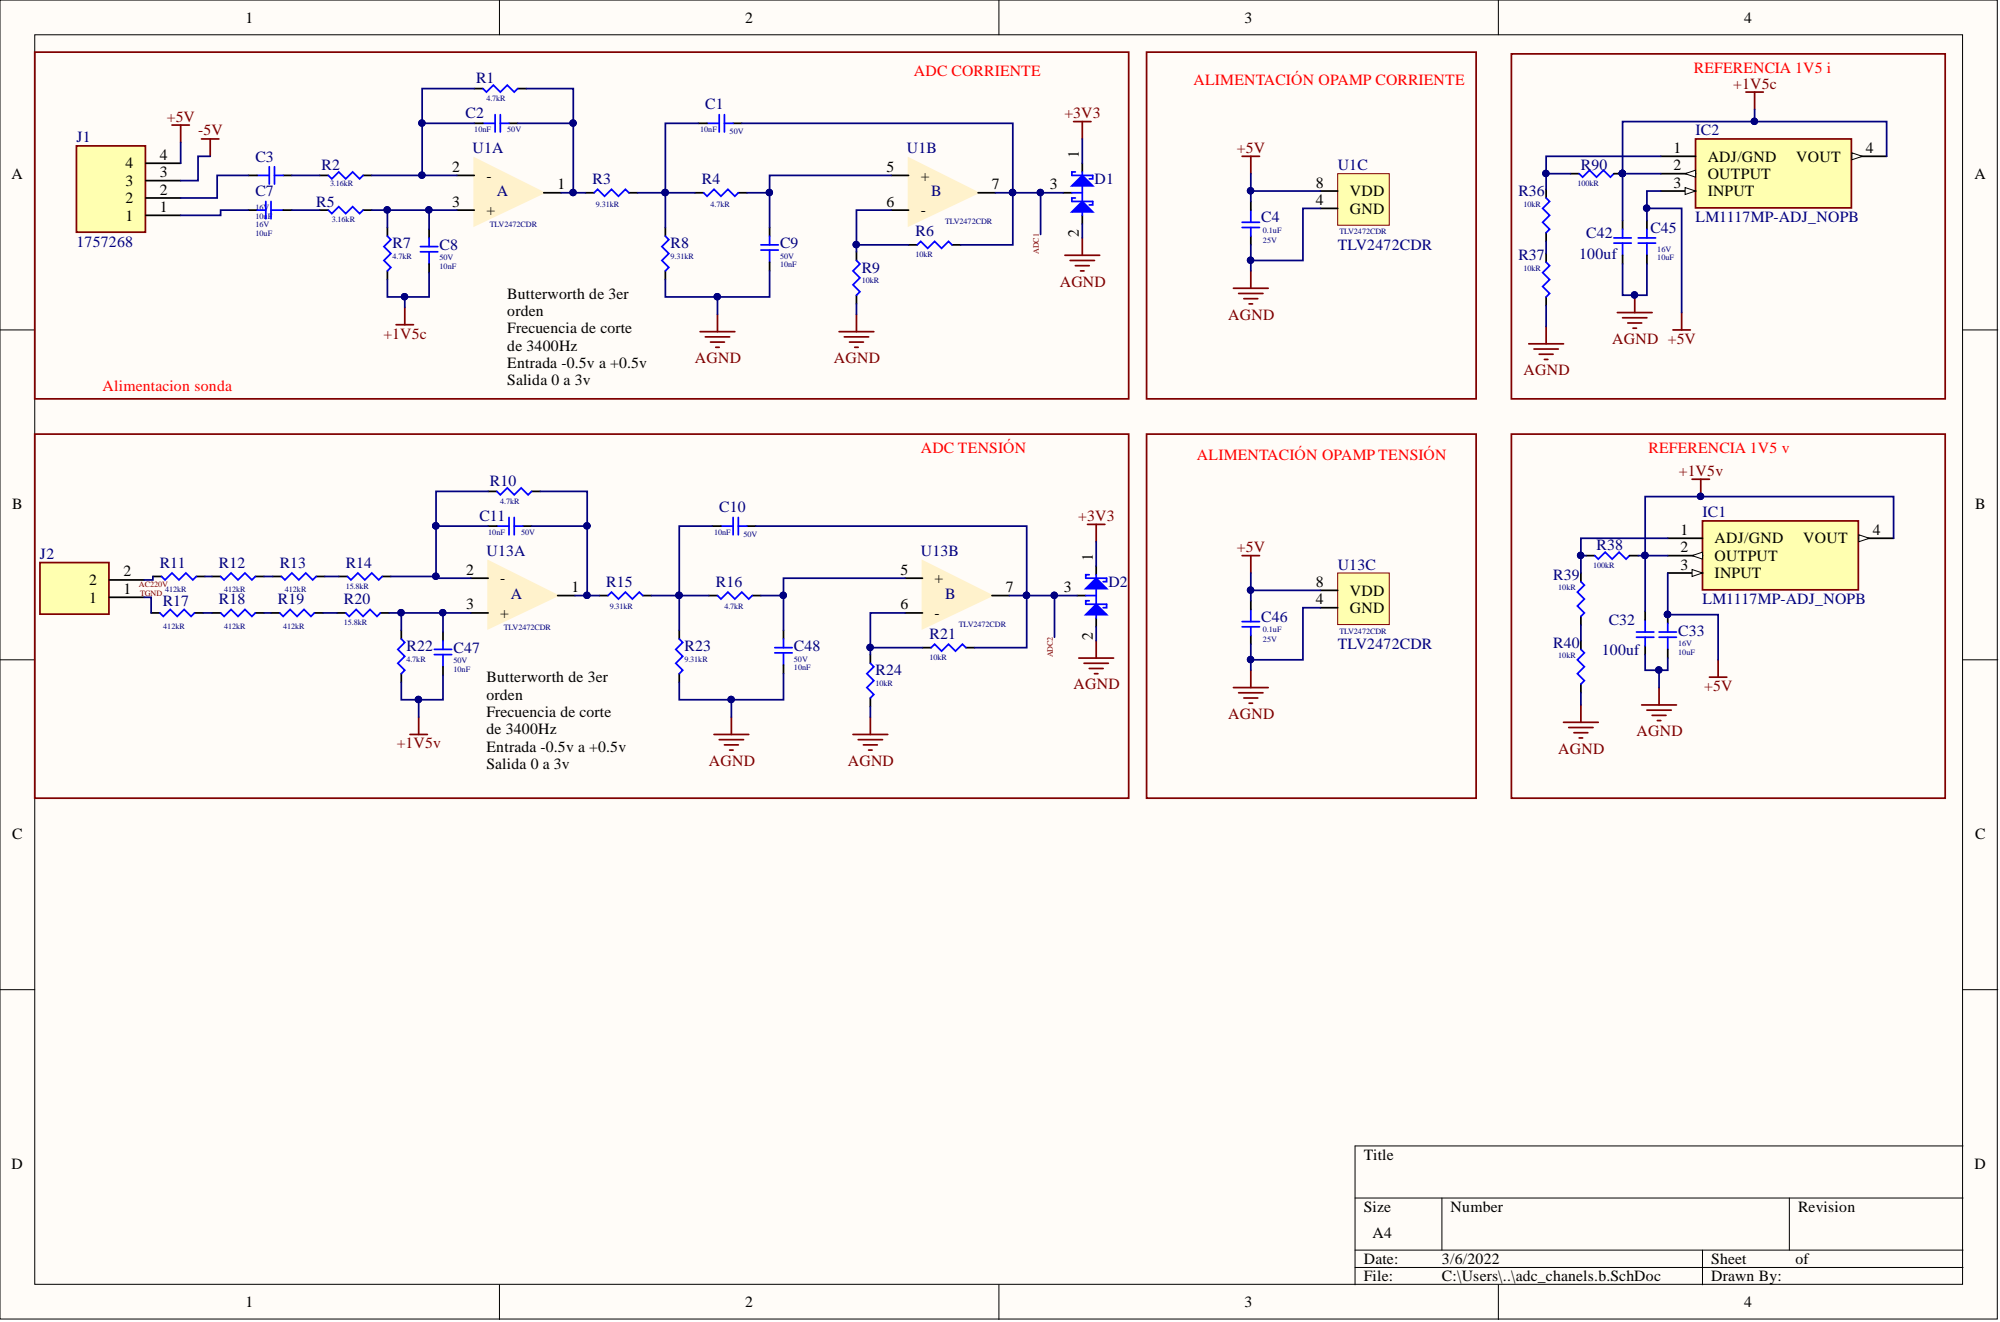
[picture p249: page 2]

ADJ/GND 1

R90 | OUTPUT 2

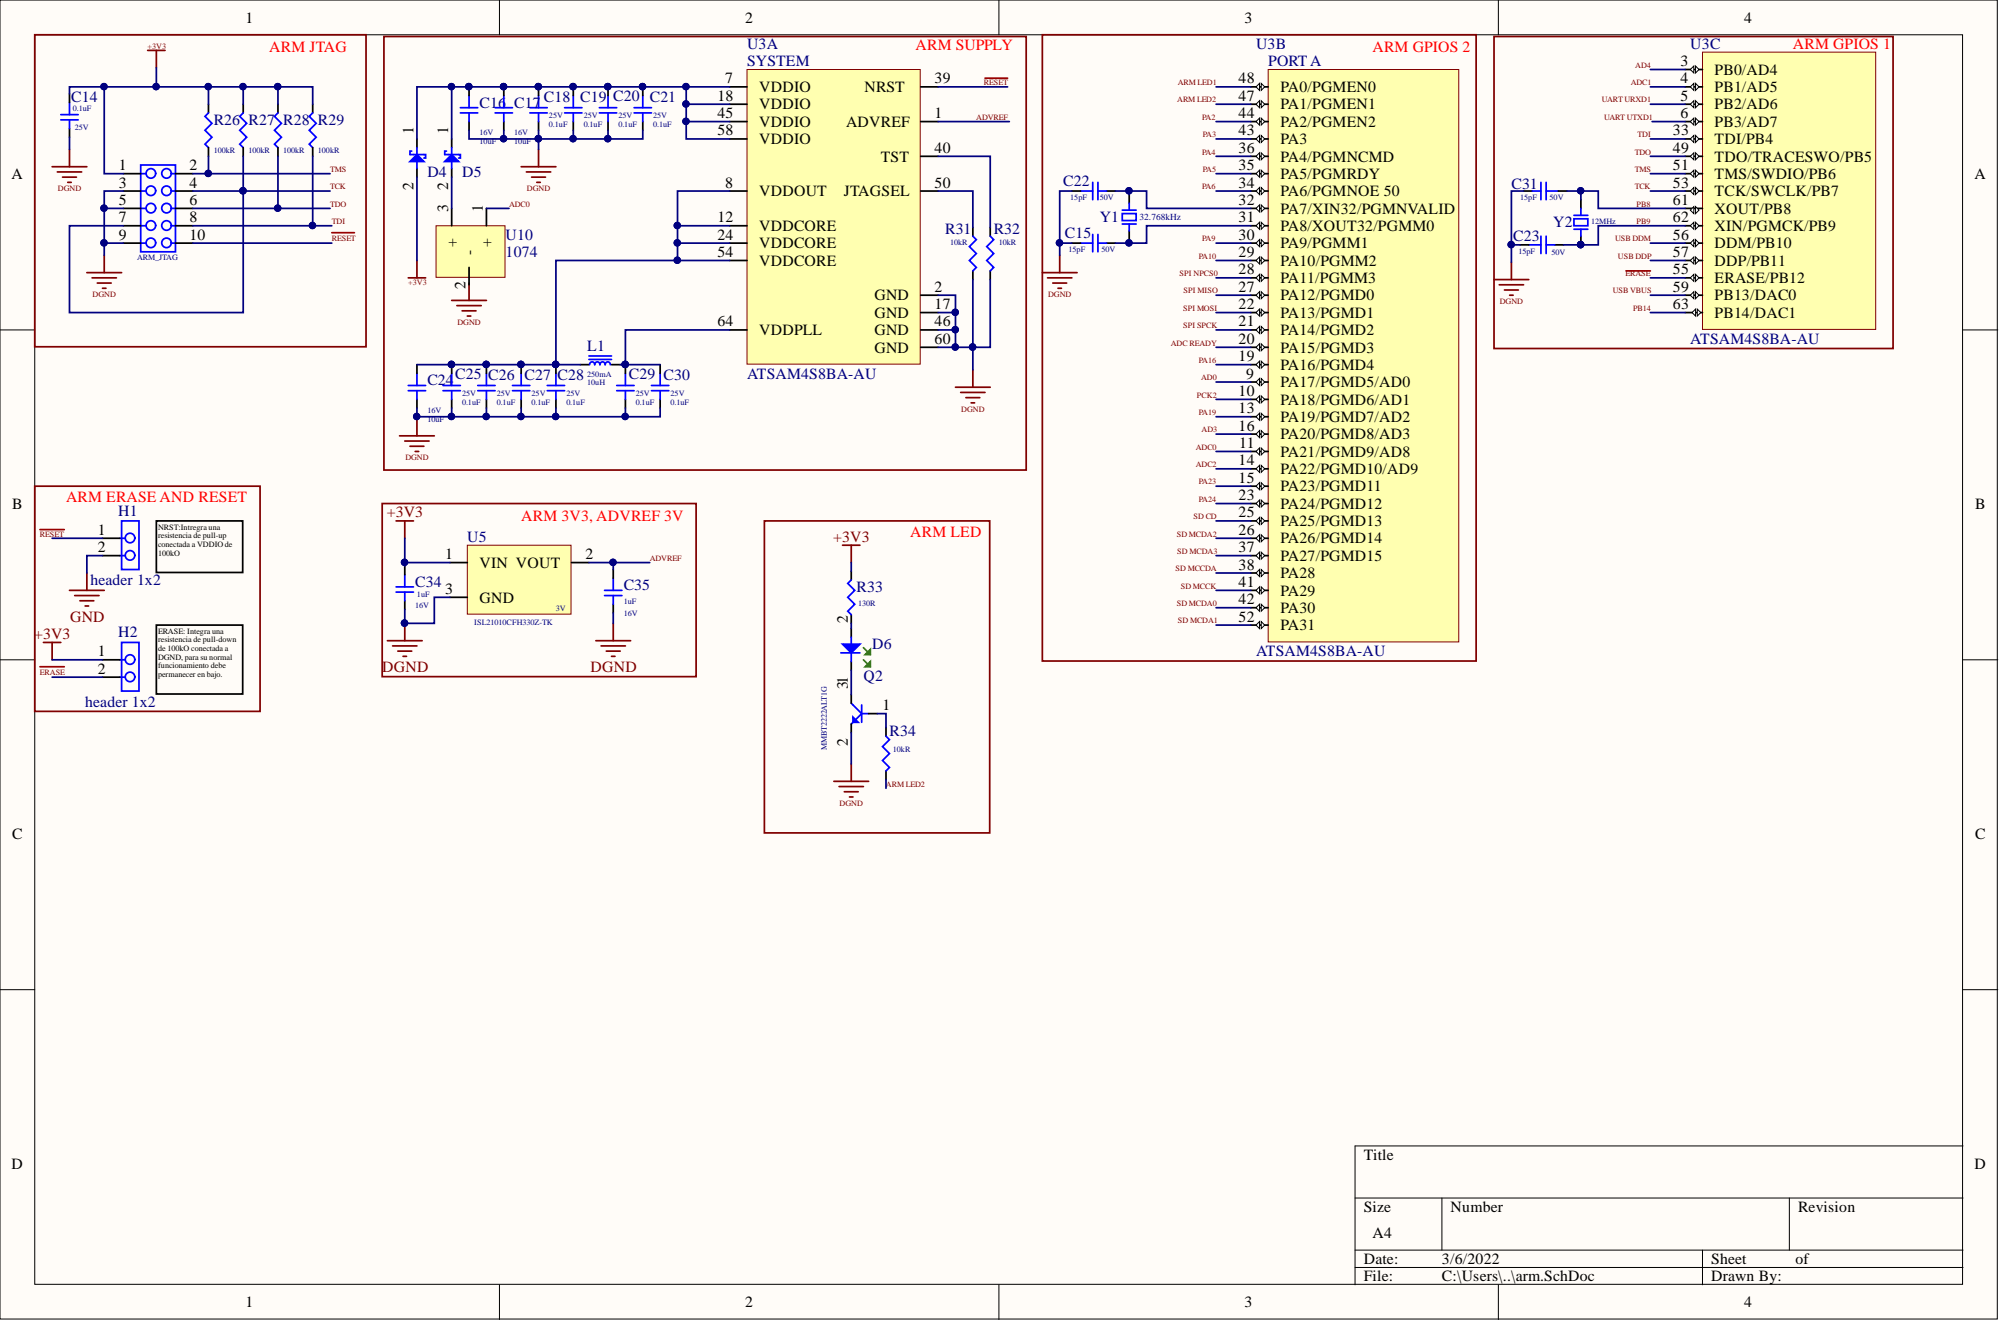
[picture p250: page 3]

UART UTXD1 TMS TCK TDO TDI

1 7
4 6

T:Intr
sistencia de pull-up

sistencia de pull-down

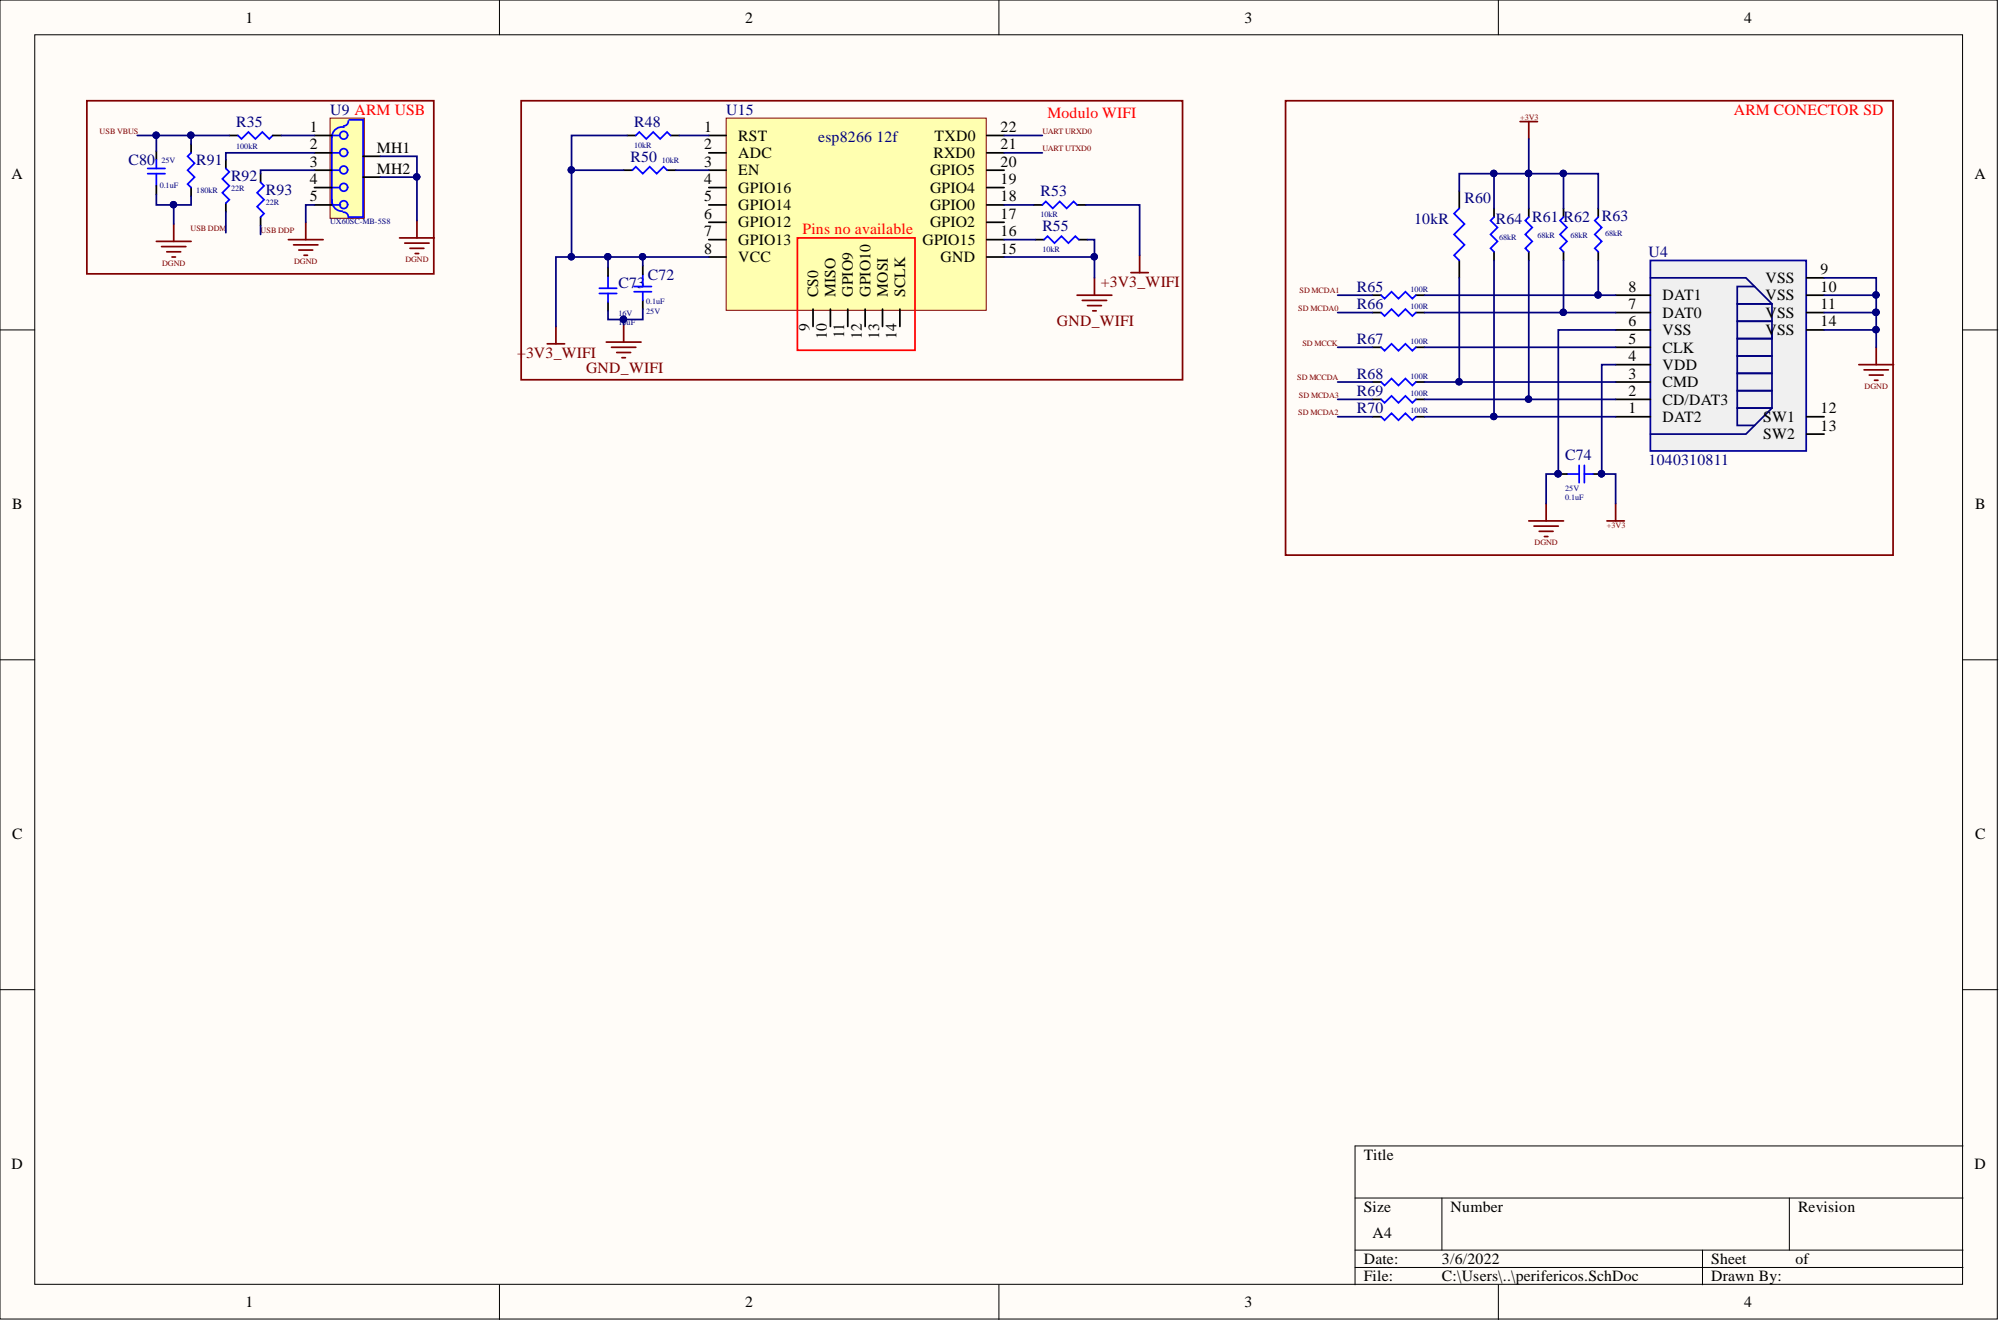
[picture p251: page 4]

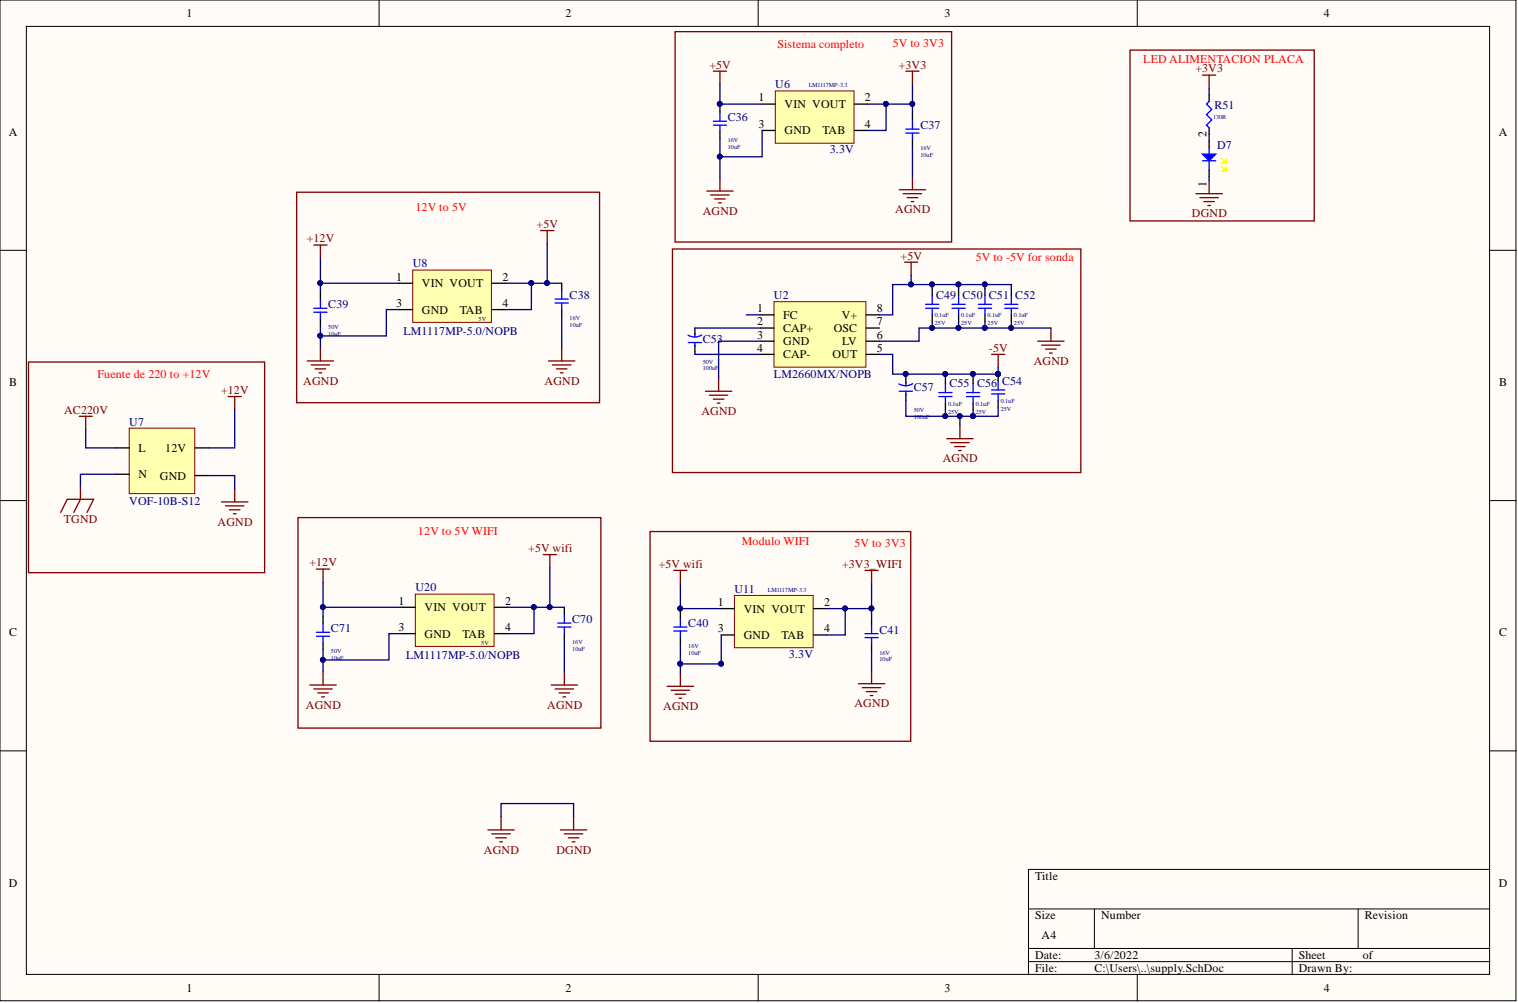
[picture p252: page 5]
