eloy-cacca/Trabajo-final/(list of files, drawings)

Other design files:
curso altium/PCB_Project/led1.SchDoc
curso altium/PCB_Project/led.PcbDoc
curso altium/PCB_Project/led.PcbLib
curso altium/PCB_Project/led.PrjPcb
curso altium/PCB_Project/led.SchDoc
curso altium/PCB_Project/led.SchLib
curso altium/PCB_Project/PCB1.PcbDoc
curso altium/PCB_Project/PCB_Project.PrjPcb
curso altium/PCB_Project_1/led.PcbDoc
curso altium/PCB_Project_1/led.PcbLib
curso altium/PCB_Project_1/led.PrjPcb
curso altium/PCB_Project_1/led.SchDoc
curso altium/PCB_Project_1/led.SchLib
curso altium/PCB_Project_1/PCB_Project_1.PrjPcb
curso altium/Trabajo Final/adc ext.SchDoc
curso altium/Trabajo Final/adc extern.SchDoc
curso altium/Trabajo Final/adc.SchDoc
curso altium/Trabajo Final/adc_chanels.b.SchDoc
curso altium/Trabajo Final/adc_chanels.SchDoc
curso altium/Trabajo Final/arm.SchDoc
curso altium/Trabajo Final/cap.PcbLib
curso altium/Trabajo Final/Cap.SchLib
curso altium/Trabajo Final/conectors.SchLib
curso altium/Trabajo Final/diode.PcbLib
curso altium/Trabajo Final/diode.SchLib
curso altium/Trabajo Final/ic.PcbLib
curso altium/Trabajo Final/ic.SchLib
curso altium/Trabajo Final/inductores.PcbLib
curso altium/Trabajo Final/inductores.SchLib
curso altium/Trabajo Final/nuevo1.SchDoc
curso altium/Trabajo Final/others.PcbLib
curso altium/Trabajo Final/others.SchLib
curso altium/Trabajo Final/PCB1.PcbDoc
curso altium/Trabajo Final/perifericos.SchDoc
curso altium/Trabajo Final/res.PcbLib
curso altium/Trabajo Final/res.SchLib
curso altium/Trabajo Final/Resistor.SchLib
curso altium/Trabajo Final/supply.SchDoc
curso altium/Trabajo Final/Tfinal.PcbDoc
curso altium/Trabajo Final/Tfinal.PcbLib
curso altium/Trabajo Final/Tfinal.SchDoc
curso altium/Trabajo Final/Tfinal.SchLib
curso altium/Trabajo Final/Trabajo Final.PrjPcb
trabajo final/tesis aon/Nueva carpeta/PM2PM1IB1_PCB_RevA_ic_161115_Altium/lib_ic_CAP.SchLib
trabajo final/tesis aon/Nueva carpeta/PM2PM1IB1_PCB_RevA_ic_161115_Altium/lib_ic_CON.SchLib
trabajo final/tesis aon/Nueva carpeta/PM2PM1IB1_PCB_RevA_ic_161115_Altium/lib_ic_DIO.SchLib
trabajo final/tesis aon/Nueva carpeta/PM2PM1IB1_PCB_RevA_ic_161115_Altium/lib_ic_FOOTPRINTS.PcbLib
trabajo final/tesis aon/Nueva carpeta/PM2PM1IB1_PCB_RevA_ic_161115_Altium/lib_ic_IC.SchLib
trabajo final/tesis aon/Nueva carpeta/PM2PM1IB1_PCB_RevA_ic_161115_Altium/lib_ic_MAG.SchLib
trabajo final/tesis aon/Nueva carpeta/PM2PM1IB1_PCB_RevA_ic_161115_Altium/lib_ic_MSC.SchLib
trabajo final/tesis aon/Nueva carpeta/PM2PM1IB1_PCB_RevA_ic_161115_Altium/lib_ic_RES.SchLib
trabajo final/tesis aon/Nueva carpeta/PM2PM1IB1_PCB_RevA_ic_161115_Altium/PMV2_IBV1_Altium.PcbDoc
trabajo final/tesis aon/Nueva carpeta/PM2PM1IB1_PCB_RevA_ic_161115_Altium/PMV2_IBV1_Altium.PrjPCB
trabajo final/tesis aon/Nueva carpeta/PM2PM1IB1_PCB_RevA_ic_161115_Altium/PMV2_IBV1_Altium_page01.SchDoc
trabajo final/tesis aon/Nueva carpeta/PM2PM1MB1_PCB_RevA_ic_161017_Altium/pqm_v2/pqm_v2.PrjPCB
trabajo final/tesis aon/Nueva carpeta/PM2PM1MB1_PCB_RevA_ic_161017_Altium/pqm_v2/pqm_v2_copia01.PcbDoc
trabajo final/tesis aon/Nueva carpeta/PM2PM1MB1_PCB_RevA_ic_161017_Altium/pqm_v2/pqm_v2_copia02.PcbDoc
trabajo final/tesis aon/Nueva carpeta/PM2PM1MB1_PCB_RevA_ic_161017_Altium/pqm_v2/pqm_v2_lib_cap.SchLib
trabajo final/tesis aon/Nueva carpeta/PM2PM1MB1_PCB_RevA_ic_161017_Altium/pqm_v2/pqm_v2_lib_connectors.SchLib
trabajo final/tesis aon/Nueva carpeta/PM2PM1MB1_PCB_RevA_ic_161017_Altium/pqm_v2/pqm_v2_lib_diodos.SchLib
trabajo final/tesis aon/Nueva carpeta/PM2PM1MB1_PCB_RevA_ic_161017_Altium/pqm_v2/pqm_v2_lib_footprints.PcbLib
trabajo final/tesis aon/Nueva carpeta/PM2PM1MB1_PCB_RevA_ic_161017_Altium/pqm_v2/pqm_v2_lib_ic.SchLib
trabajo final/tesis aon/Nueva carpeta/PM2PM1MB1_PCB_RevA_ic_161017_Altium/pqm_v2/pqm_v2_lib_mag.SchLib
trabajo final/tesis aon/Nueva carpeta/PM2PM1MB1_PCB_RevA_ic_161017_Altium/pqm_v2/pqm_v2_lib_res.SchLib
trabajo final/tesis aon/Nueva carpeta/PM2PM1MB1_PCB_RevA_ic_161017_Altium/pqm_v2/pqm_v2_page1.SchDoc
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
