eloy-cacca/Trabajo-final/trabajo final/tesis aon/Nueva carpeta/PM2_FW_ARMA_02_01_ic_180518/src/comm/comm.c

// $Header
/// @file			comm.c
/// @brief  		Communication file.
/// @details
/// @author 		Ignacio Carugati
/// @version   		1.0
/// @date      		27 October 2016
/// @details
/// @copyright
///

/// @addtogroup comm
/// @{

/**************************** INCLUDES ***************************************/

// Specific includes
#include "comm.h"

// Local includes
#include "app_layer.h"
#include "../utils/byte_string_operations.h"
#include "../apps/sdcard.h"
#include "../apps/unit_config.h"
#include "../apis/dsp_api.h"
#include "../apps/system.h"
/*

#include "../mod/control.h"

#include "../apis/fw_api.h"
#include "../apis/rtc_api.h"
#include "../apis/unit_config_api.h"
#include "../apis/control_api.h"

#include "../apps/rtc.h"*/

/**************************** MACROS *****************************************/

#define MSG_START_BYTE      ((uint8_t)(0x3C))
#define MSG_TIMEOUT         ( 0x000007FF )

/**************************** ENUMS, STRUCTS *********************************/

/**************************** FUNCTION PROTOTYPES ****************************/

void comm_preprocess_RX_msg( msg_t * msg_ptr );
void comm_process_RX_msg( msg_t * msg_ptr );
void uart_send_packet(Uart *uart_ptr, uint8_t *tx_packet, uint16_t tx_len);

/**************************** LOCAL VARIABLES ********************************/

// Sci variables
msg_t UART_RPI_msg;
msg_t UART_DSP_msg;

// output
uint8_t packet_out[MSG_LENGHT_MAX_SIZE];
bool    packet_out_busy = 0;

// Counter used for TX pending communication
uint16_t comm_TX_counter;

// Counter used for request DSP comm flags
uint16_t comm_DSP_counter;

/**************************** GLOBAL VARIABLES *******************************/

/**************************** LOCAL FUNCTIONS ********************************/


/// @brief Generic UART pre-process incoming message
/// @details This functions is called by Rx interrupt when a byte is received.
///          Byte is added to buffer and counter of received data is updated.
/// @param[in] msg_ptr Pointer to msg_t
void comm_preprocess_RX_msg( msg_t * msg_ptr ) {

	// Check if a byte was received
	if ( uart_is_rx_ready(msg_ptr->uart_ptr) ) {

		// save new byte
		uart_read(msg_ptr->uart_ptr, &msg_ptr->packet_in[msg_ptr->rx_counter] );

		// increment the rx counter and
		msg_ptr->rx_counter++;

		// reset timeout counter
		msg_ptr->timeout_counter = 0;

	}

}


/// @brief Generic UART process incoming message
/// @details This functions is called in background and check if a message is complete.
/// @param[in] msg_ptr Pointer to UART structure
void comm_process_RX_msg( msg_t * msg_ptr ) {

	// If error occurs, start over.
    if ( uart_get_status(msg_ptr->uart_ptr) == (UART_SR_OVRE | UART_SR_FRAME | UART_SR_PARE) ) {

    	memset( msg_ptr->packet_in , 0 , MSG_LENGHT_MAX_SIZE ); // Reset buffer
        msg_ptr->rx_counter = 0;                                // Reset rx index
        msg_ptr->timeout_counter = 0;                           // Reset timeout counter
        uart_reset_status(msg_ptr->uart_ptr);					// Clear error since it will block receiving
																// TODO: this is e problem for other uC.

    }

    // Increment timeout counter
    msg_ptr->timeout_counter++;

    // Reset counters if timeout occurs
    if (msg_ptr->timeout_counter == MSG_TIMEOUT) {
    	msg_ptr->timeout_counter = 0;
    	msg_ptr->rx_counter = 0;
    }

   	// Check proper start byte
   	if (msg_ptr->rx_counter > 0) {
   		if (msg_ptr->packet_in[msg_h_start] != MSG_START_BYTE)
   			msg_ptr->rx_counter = 0; // reset buffer
   	}

   	// Check proper project id
   	if (msg_ptr->rx_counter > 1) {
       	if (!(msg_ptr->packet_in[msg_h_proj_id] == SETTINGS_PROJECT_ID) )
       		msg_ptr->rx_counter = 0; // reset buffer
   	}

   	// Check proper source id
   	if (msg_ptr->rx_counter > 2) {
       	if (!( (msg_ptr->packet_in[msg_h_src_id] == SETTINGS_OTHERS_ID) ||
       		   (msg_ptr->packet_in[msg_h_src_id] == SETTINGS_DSP_ID) ||
               (msg_ptr->packet_in[msg_h_src_id] == SETTINGS_RPI_ID) ))
       		msg_ptr->rx_counter = 0; // reset buffer
   	}

   	// Check proper destination id
   	if (msg_ptr->rx_counter > 3) {
		    //	{
			//		#include "../apps/system.h"
			//		led_green_on();
		   	//	}		   
       	if (!( (msg_ptr->packet_in[msg_h_des_id] == SETTINGS_ARM_ID) ||
       		   (msg_ptr->packet_in[msg_h_des_id] == SETTINGS_RPI_ID) ||
			   (msg_ptr->packet_in[msg_h_des_id] == SETTINGS_DSP_ID)))
       		msg_ptr->rx_counter = 0; // reset buffer
   	}

   	// if the packet is complete, check CRC and packet out is not busy, decode message and reset buffer
   	if (  (msg_ptr->rx_counter >= MSG_LENGHT_HEADER) &&
   		  ((msg_ptr->packet_in[msg_h_payload_len] + MSG_LENGHT_HEADER) == msg_ptr->rx_counter) &&
          (!packet_out_busy ) &&
   		  (!calculate_checksum( msg_ptr->packet_in , (uint16_t) msg_ptr->rx_counter)) ) {
       		decode_incoming_comms_packet( msg_ptr );
       	msg_ptr->rx_counter = 0; // reset buffer
   	}

}

void uart_send_packet(Uart *uart_ptr, uint8_t *tx_packet, uint16_t tx_len) {
	
	while (tx_len--) {

		// wait for sci FIFO transmit data register to have space
        while ( !uart_is_tx_empty(uart_ptr) );

		uart_write( uart_ptr , *tx_packet++ );
	
	}
	
}

/**************************** GLOBAL FUNCTIONS *******************************/

/// @brief Communication initialization routine.
void comm_init(void) {

	// TX buffer
	memset( (void *)&packet_out , 0 , MSG_LENGHT_MAX_SIZE );

	// UART DB15 variable initialization
	memset( (void *)&UART_RPI_msg , 0 , sizeof(UART_RPI_msg) );
	UART_RPI_msg.uart_ptr = UART_RPI;

	// UART DSP variable initialization
	memset( (void *)&UART_DSP_msg , 0 , sizeof(UART_DSP_msg) );
	UART_DSP_msg.uart_ptr = UART_DSP;
	
	// init counters
	comm_TX_counter = 0;
	comm_DSP_counter = 0;

}
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
