eloy-cacca/Trabajo-final/(commit log)

2021-11-13 Primera entrega Tp final
    [022232021.stp, 022292021.stp, 0805LED-GREEN.step, 0805LED-YELLOW.step, 0805LED-red.step, Aon_Plan-de-pruebas_v1.xlsx, Aon_Plan-de-pruebas_v2.xlsx, CAPC370195_120N_KEM.step]
2021-11-22 nueva version 22/11
    [Trabajo Final.PrjPcb, adc_chanels.SchDoc, diode.SchLib, ic.SchLib, nuevo1.SchDoc, res.SchLib]
2021-11-22 nueva version a 22/11
    [ic.SchLib]
2021-11-22 version 22/11 cambios circuito arm
    [Trabajo Final.PrjPcb, adc_chanels.b.SchDoc, arm.SchDoc, conectors.SchLib, diode.SchLib, inductores.SchLib, nuevo1.SchDoc, res.SchLib]
2021-11-22 version 22/11 final
    [adc_chanels.b.SchDoc, arm.SchDoc, diode.SchLib, inductores.SchLib, others.SchLib, res.SchLib]
2021-11-24 reversion componentes
    [Trabajo Final.PrjPcb, adc_chanels.b.SchDoc, arm.SchDoc, ic.SchLib, lista componentes 23_11.xls, res.SchLib]
2021-11-30 Version con PCB
    [Cap.SchLib, Tfinal.PcbDoc, adc_chanels.b.SchDoc, arm.SchDoc, cap.PcbLib, diode.PcbLib, ic.PcbLib, ic.SchLib]
2021-12-07 Correcion diseño arm, diseño pcb
    [PMV2_IBV1_Altium.PcbDoc, Tfinal.PcbDoc, arm.SchDoc]
2021-12-17 version tamaño final
    [adc extern.SchDoc, adc_chanels.b.SchDoc, arm.SchDoc, conectors.SchLib, ic.PcbLib, others.SchLib, res.SchLib, supply.SchDoc]
2022-04-10 entrega 10/4
    [Cap.SchLib, PCB1.PcbDoc, Trabajo Final.PrjPcb, adc ext.SchDoc, adc_chanels.b.SchDoc, arm.SchDoc, diode.PcbLib, ic.PcbLib]
2022-05-29 29-5 agregado de fuentes de 1.5v
    [Cap.SchLib, adc ext.SchDoc, adc_chanels.b.SchDoc, arm.SchDoc, cap.PcbLib, ic.PcbLib, ic.SchLib, perifericos.SchDoc]
2022-05-29 esquematico con perifericos
    [Trabajo Final.PrjPcb, perifericos.SchDoc]
2022-05-29 nuevo esquematico sd
    [perifericos.SchDoc]
2022-05-30 29/5 falta ver wifi
    [Trabajo Final.PrjPcb, adc ext.SchDoc, arm.SchDoc, perifericos.SchDoc]
2022-06-02 Agregado archivos entregables
    [adc ext.SchDoc, adc_chanels.b.SchDoc, arm.SchDoc, perifericos.SchDoc, supply.SchDoc]
2022-06-15 15-6 falta agregar planos de masa
    [adc ext.SchDoc]
